lambdamikel/Busch-2090/microtronic-nextgen-sh1106-spi/README.md

# Busch-2090
## Microtronic Emulator - The Next Generation - SH1106 SPI OLED Display Version
### License: GPL 3

Current version. 

### PCB Version

SPI Pic 1
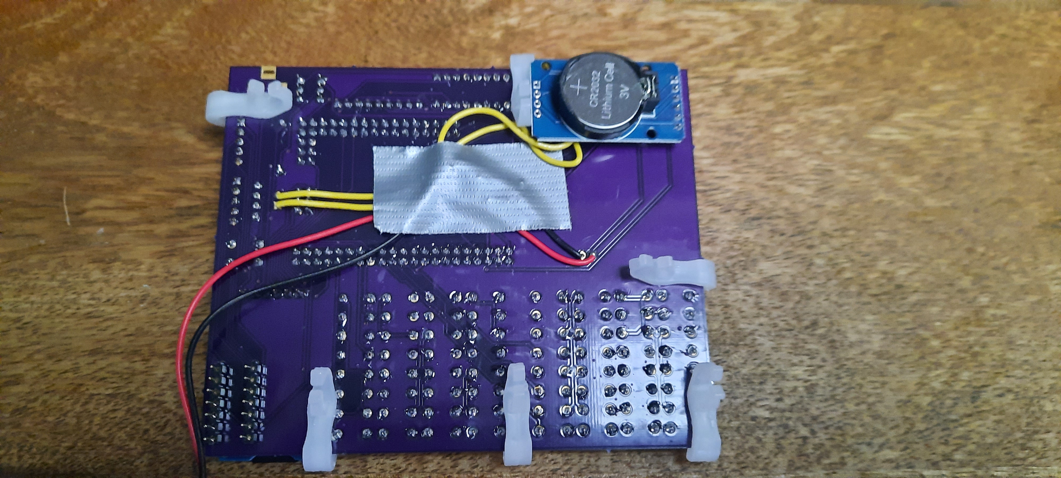
[picture p49: microtronic-nextgen-sh1106-spi/nextgen-spi-2.jpg]
SPI Pic 2

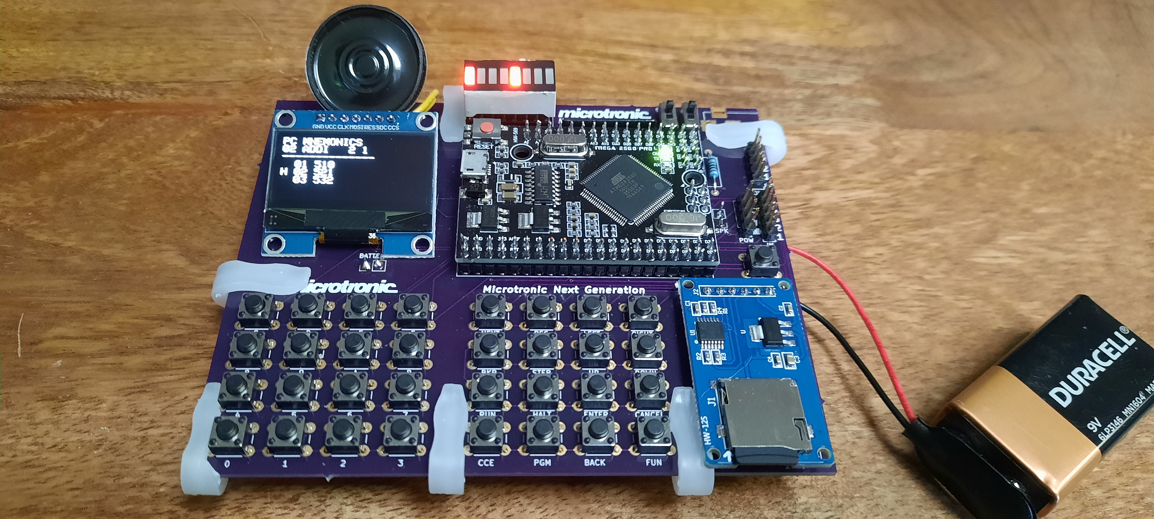
[picture p50: microtronic-nextgen-sh1106-spi/nextgen-spi-3.jpg]
SPI Pic 3

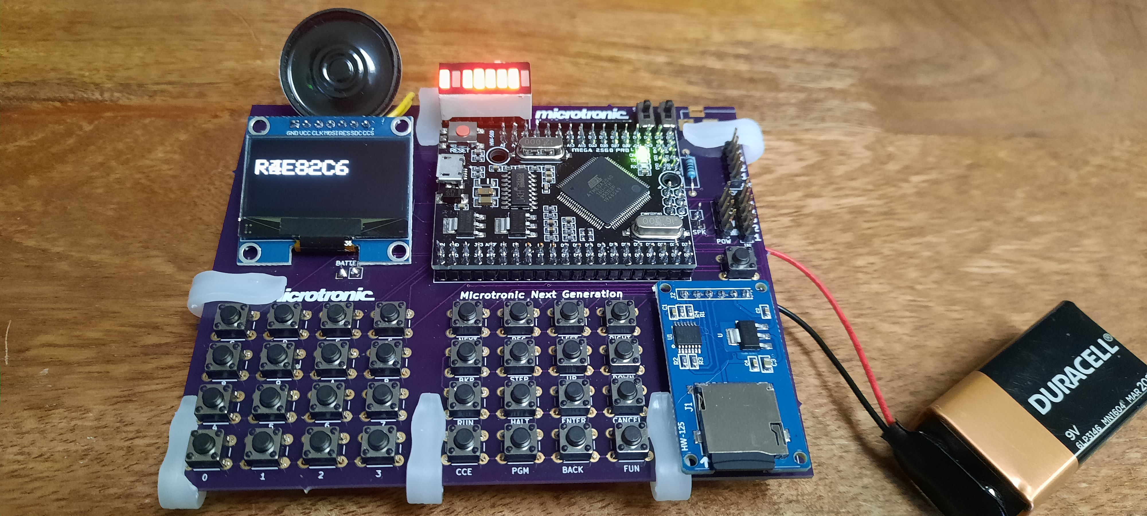
[picture p51: microtronic-nextgen-sh1106-spi/nextgen-spi-4.jpg]
SPI Pic 4

SPI Pic 5

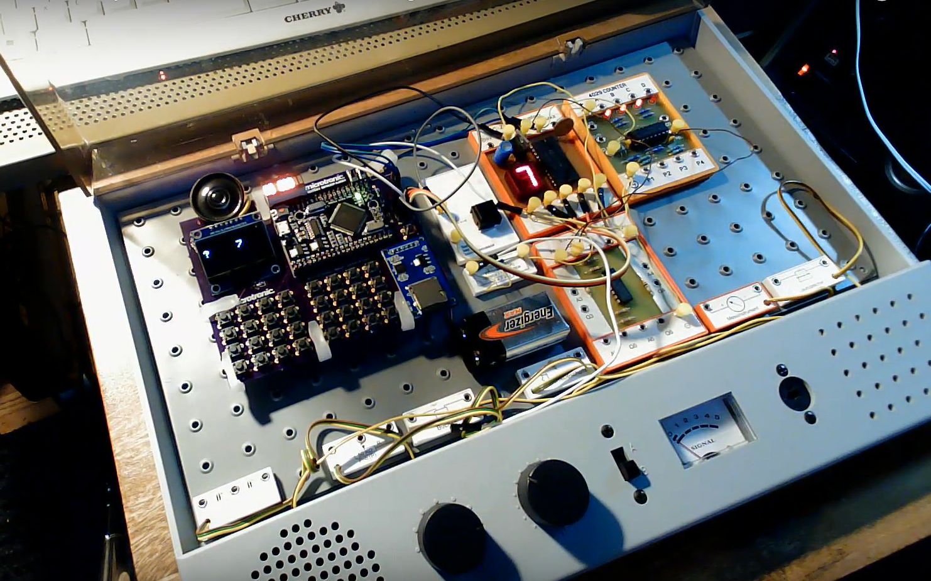
[picture p52: microtronic-nextgen-sh1106-spi/busch-2075-experiment.jpg]
SPI Pic 6


The latest version of the SPI SH1106 Next Generation also has pulldown-resistors and proper feet / PCB mounting holes: 

Busch 2090 Microtronic Next Generation - SH1106 SPI OLED Version v2 1 

Busch 2090 Microtronic Next Generation - SH1106 SPI OLED Version v2 2 

Busch 2090 Microtronic Next Generation - SH1106 SPI OLED Version v2 3 

### Breadboard Prototype

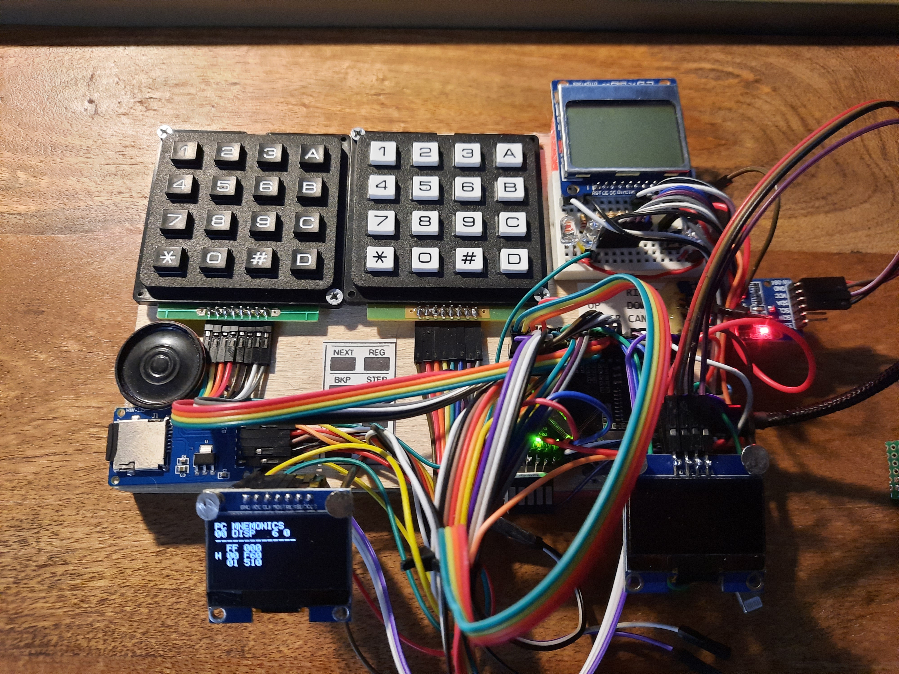
[picture p53: microtronic-nextgen-sh1106-spi/pic1.jpg]

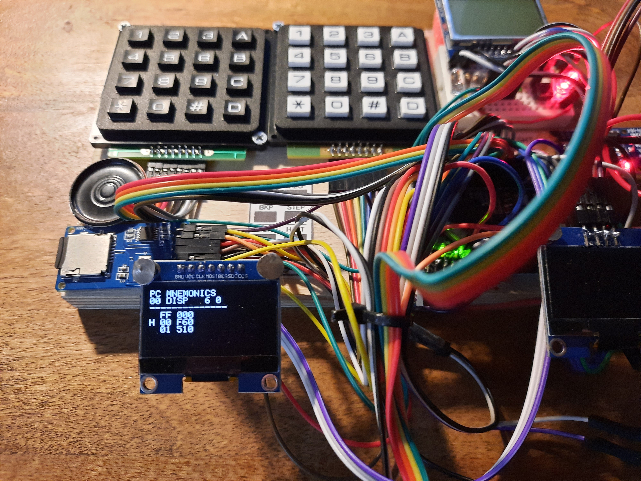
[picture p54: microtronic-nextgen-sh1106-spi/pic2.jpg]

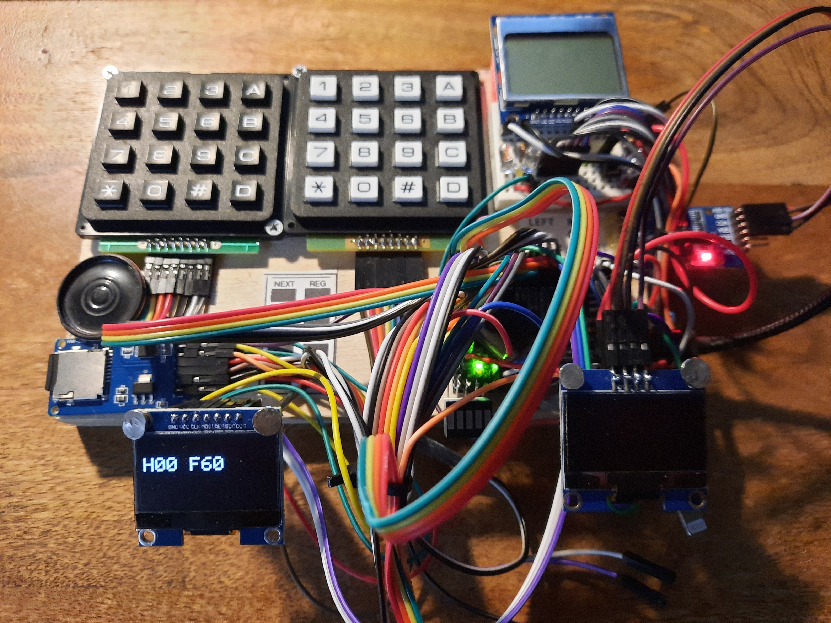
[picture p55: microtronic-nextgen-sh1106-spi/pic3.jpg]

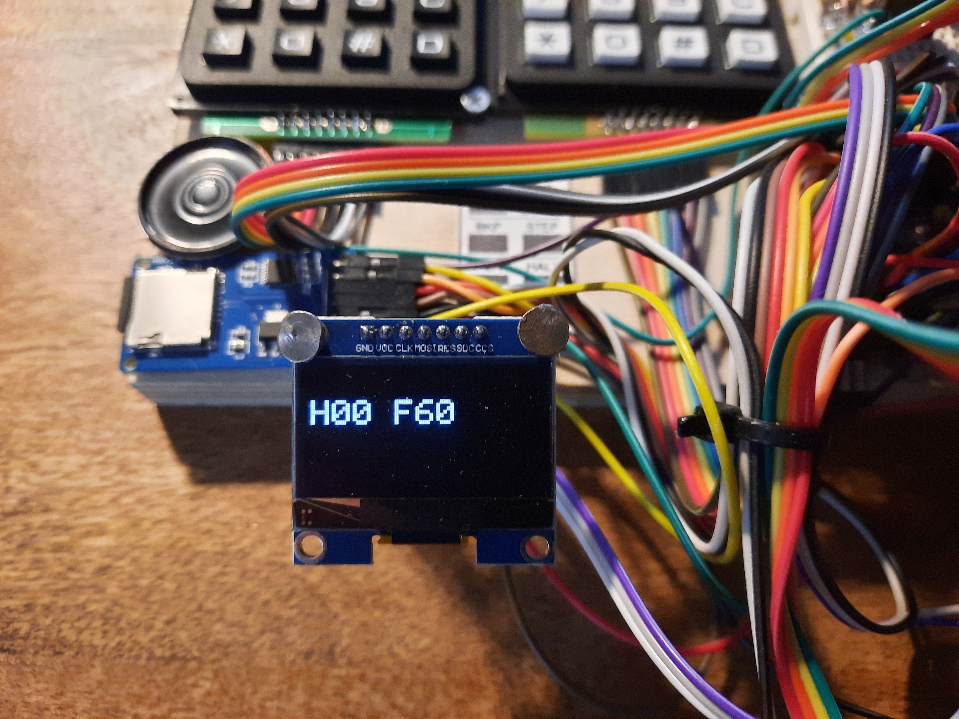
[picture p56: microtronic-nextgen-sh1106-spi/pic4.jpg]


### YouTube Videos

[YouTube Videos](https://www.youtube.com/playlist?list=PLvdXKcHrGqhekyx81EoCwQij1Lqylp0dB)
