lambdamikel/Busch-2090/microtronic-2nd-generation/README.md

# Busch-2090
## Microtronic Emulator - Microtronic 2nd Generation Version
### License: GPL 3

Microtronic 2nd Generation Version

Authors: 

- Frank de Jaeger: PCB Design & Electronics
- Manfred Henf: 3D Design & Print
- Michael Wessel: Arduino Firmware

More details about this great project can be found on the [homepage of the Microtronic 2nd Generation project.](https://www.rigert.com/ee-forum/viewtopic.php?t=2497) 

### PCB Version

*The following pictures are courtesy of Frank de Jaeger:* 

Microtronic 2nd Generation Pic 1
Microtronic 2nd Generation Pic 2
Microtronic 2nd Generation Pic 3
Microtronic 2nd Generation Pic 4
