lambdamikel/Busch-2090/microtronic-nextgen-nokia/README.md

# Busch-2090
## Microtronic Emulator - The Next Generation - Nokia 5110 Display Version
### License: GPL 3

**Deprecated.** 
Please consider [the SH1106 SPI Version instead](https://github.com/lambdamikel/Busch-2090/tree/master/microtronic-nextgen-sh1106-spi). 

### PCB Version

PCB 1
PCB 2
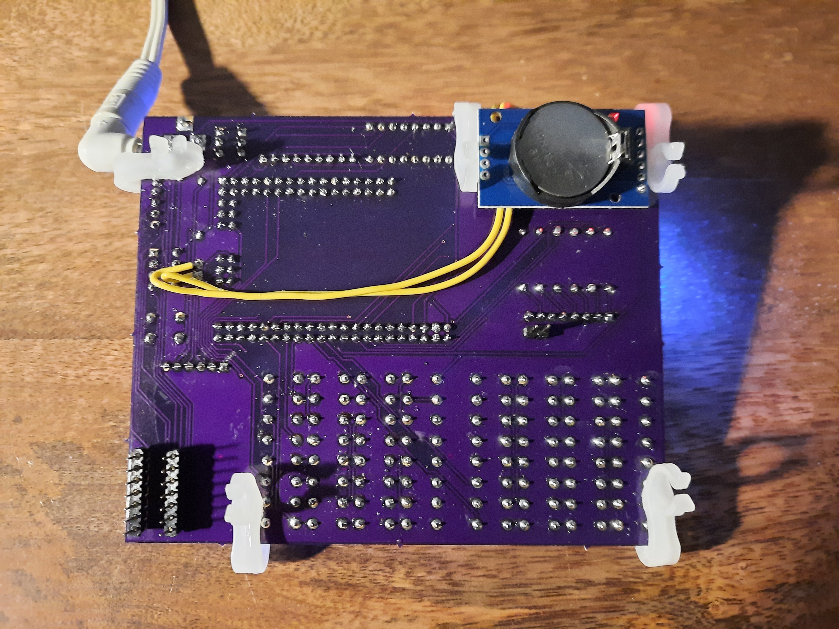
[picture p57: microtronic-nextgen-nokia/pcb3.jpg]
PCB 3


### 2095 Cassette Interface Emulation 



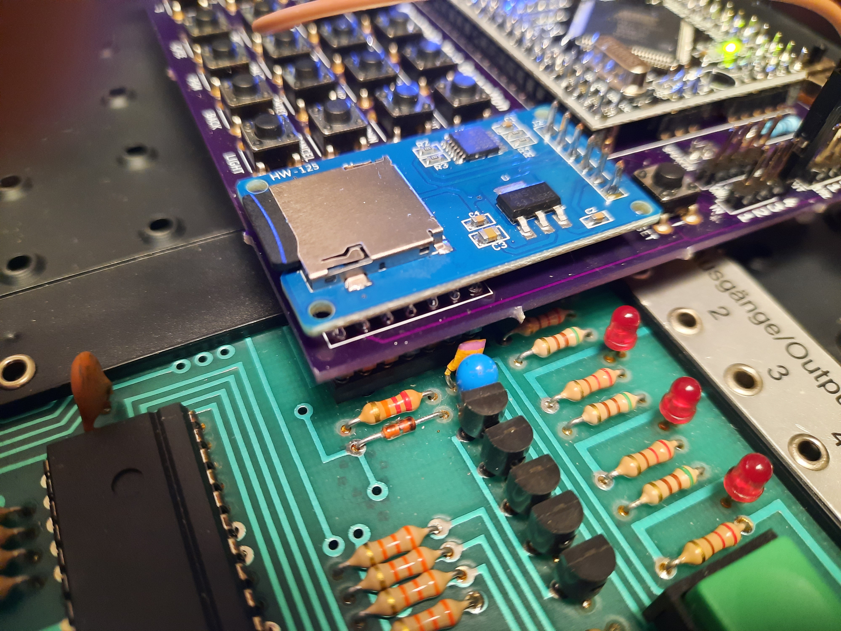
[picture p58: microtronic-nextgen-nokia/2095-3.jpg]


### Breadboard Prototype

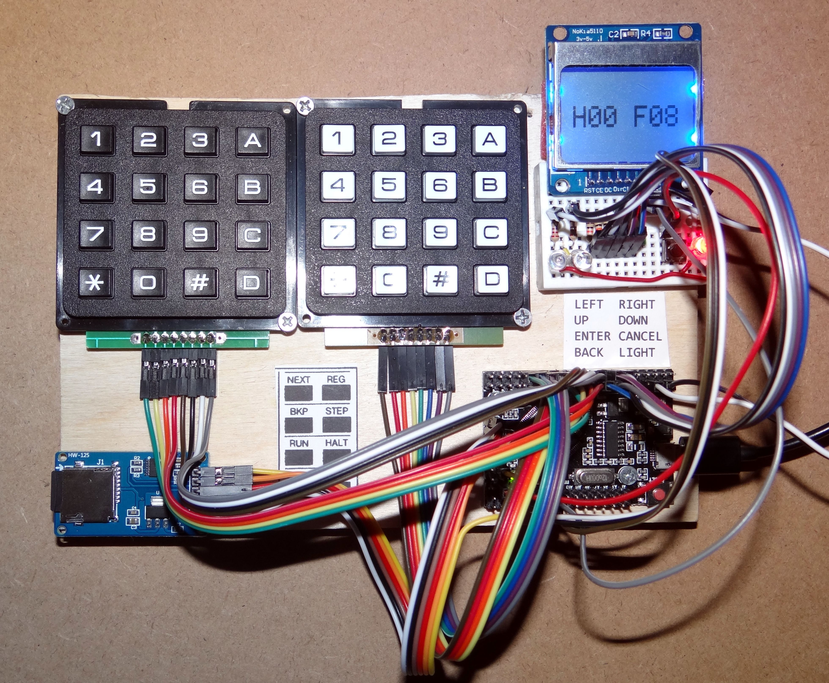
[picture p59: microtronic-nextgen-nokia/microtronic-next-gen-1.jpg]
Microtronic Emulator New Version - 1


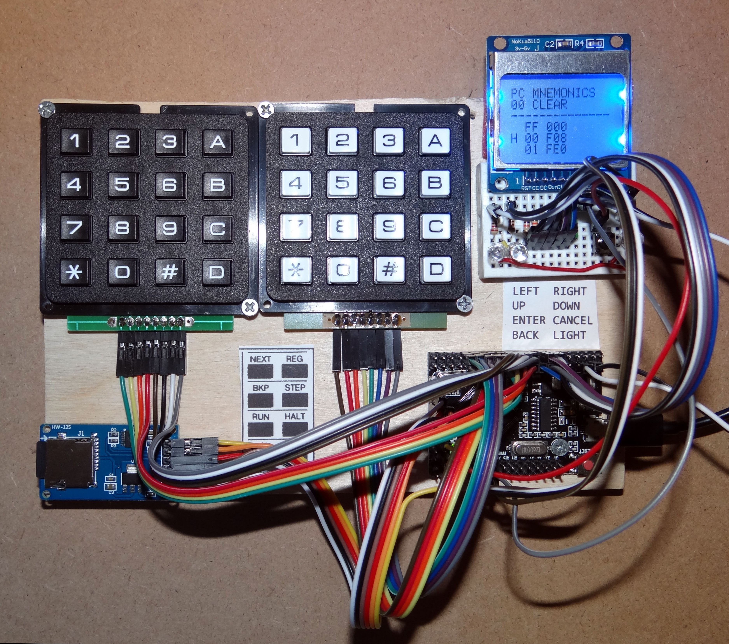
[picture p60: microtronic-nextgen-nokia/microtronic-next-gen-2.jpg]
Microtronic Emulator New Version - 2






### YouTube Videos

[YouTube Videos](https://www.youtube.com/playlist?list=PLvdXKcHrGqhekyx81EoCwQij1Lqylp0dB)
