lambdamikel/Busch-2090/microtronic-nextgen-sh1106-i2c/README.md

# Busch-2090
## Microtronic Emulator - The Next Generation - SH1106 I2C OLED Display Version
### License: GPL 3

**Deprecated.** 
Please consider [the SH1106 SPI Version instead](https://github.com/lambdamikel/Busch-2090/tree/master/microtronic-nextgen-sh1106-spi). 

### PCB Version



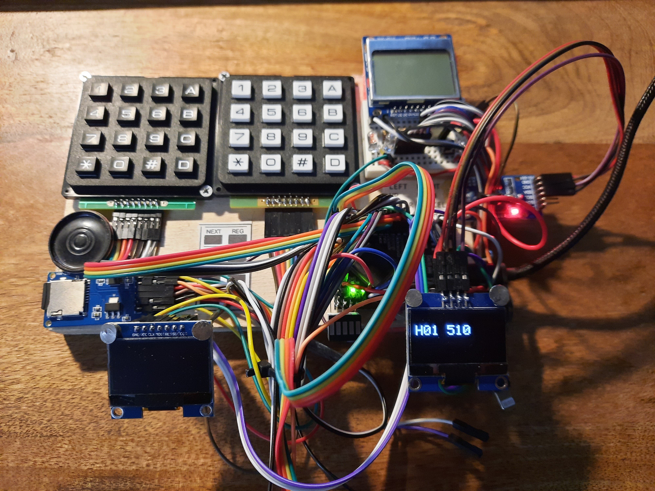
[picture p61: microtronic-nextgen-sh1106-i2c/pic3.jpg]

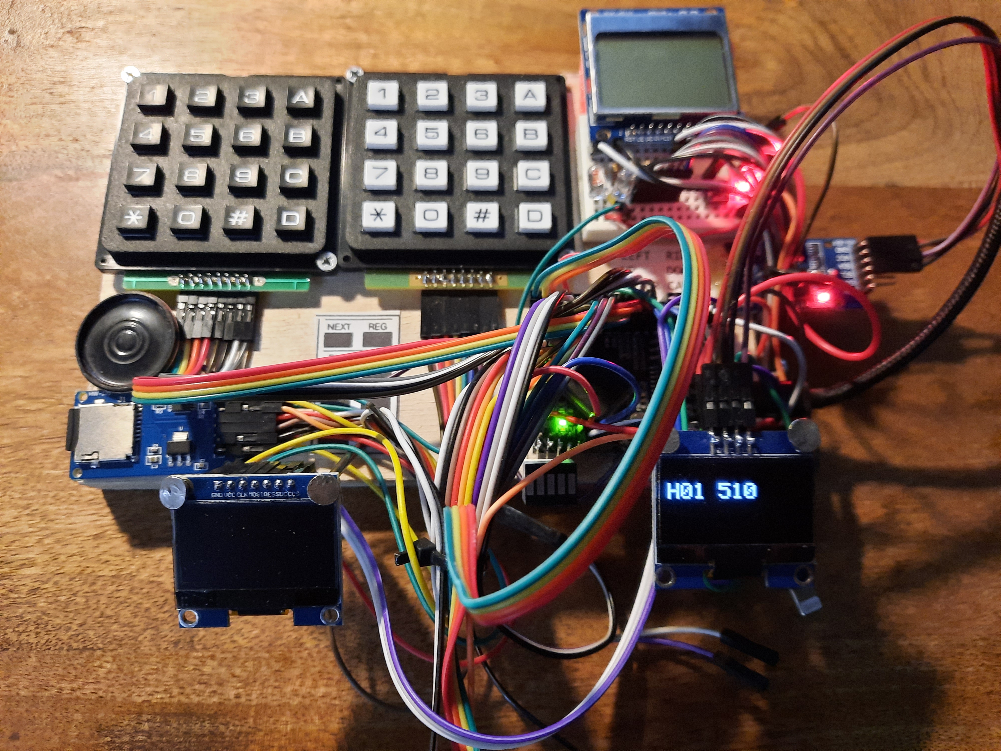
[picture p62: microtronic-nextgen-sh1106-i2c/pic4.jpg]



### YouTube Videos

[YouTube Videos](https://www.youtube.com/playlist?list=PLvdXKcHrGqhekyx81EoCwQij1Lqylp0dB)
