lambdamikel/Busch-2090/busch2090-pcb/datasheets/TM-key+led-schematics.png

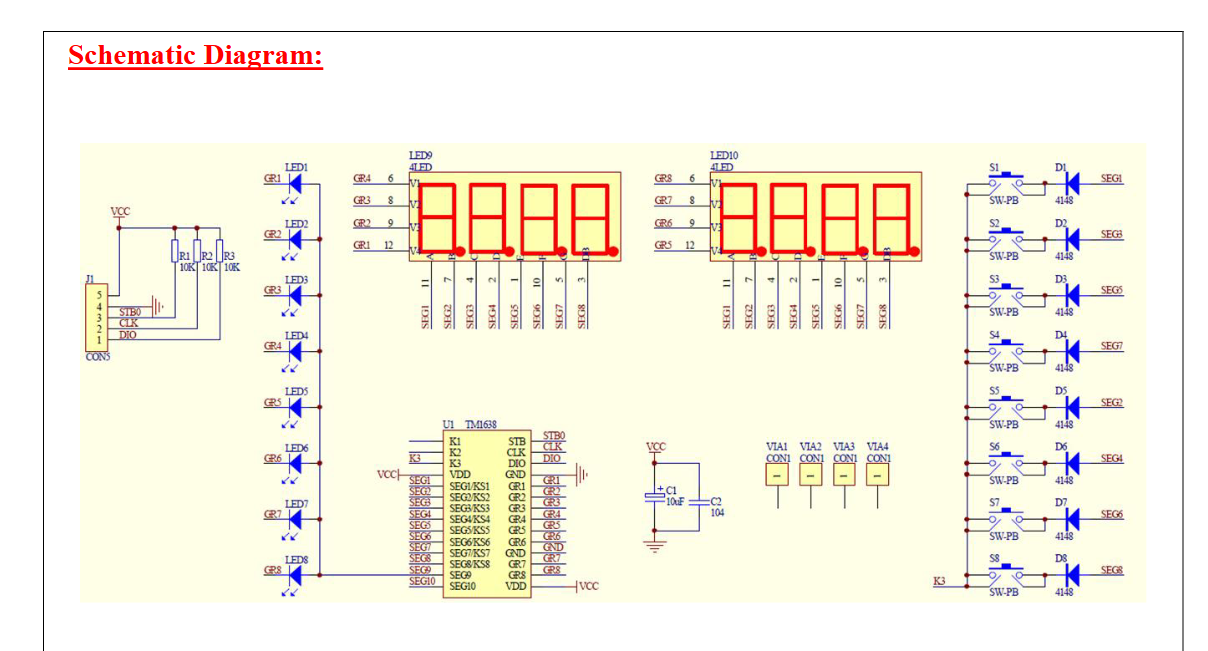
busch2090-pcb/datasheets/TM-key+led-schematics.png
