lambdamikel/Busch-2090/images/2095-flatband-cable-1.jpg

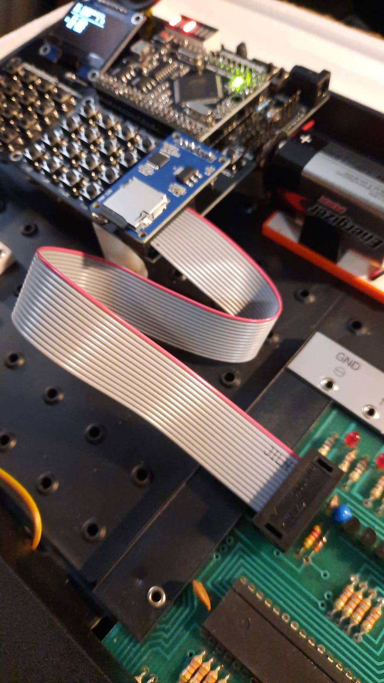
images/2095-flatband-cable-1.jpg
