lambdamikel/Busch-2090/images/emulator-busch-1-medium.jpg

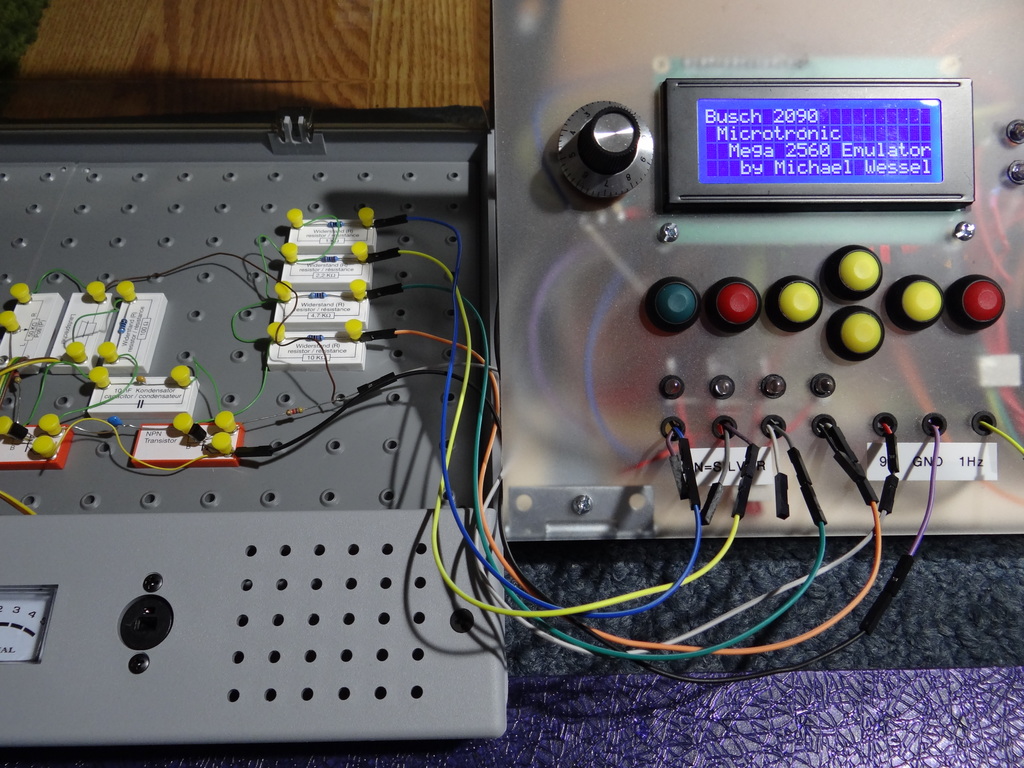
images/emulator-busch-1-medium.jpg
