lambdamikel/Busch-2090/images/emulator-busch-2-medium.jpg

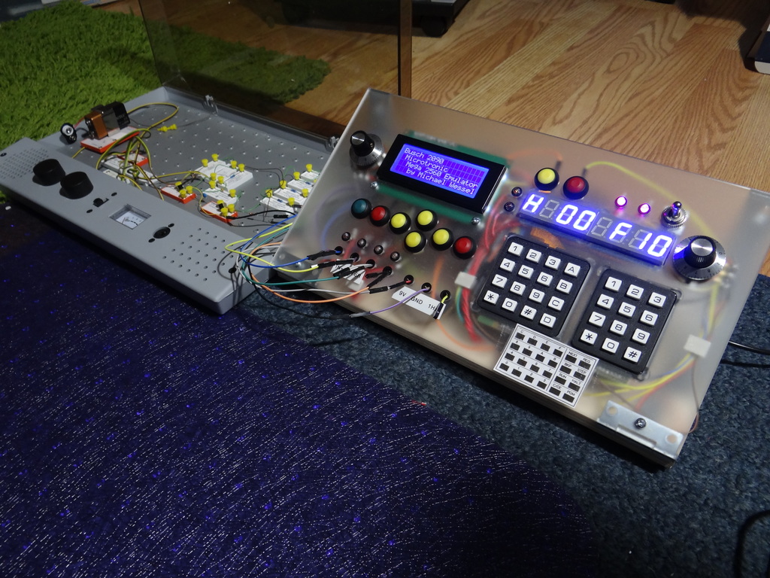
images/emulator-busch-2-medium.jpg
