lambdamikel/Busch-2090/images/emulator-busch-3-medium.jpg

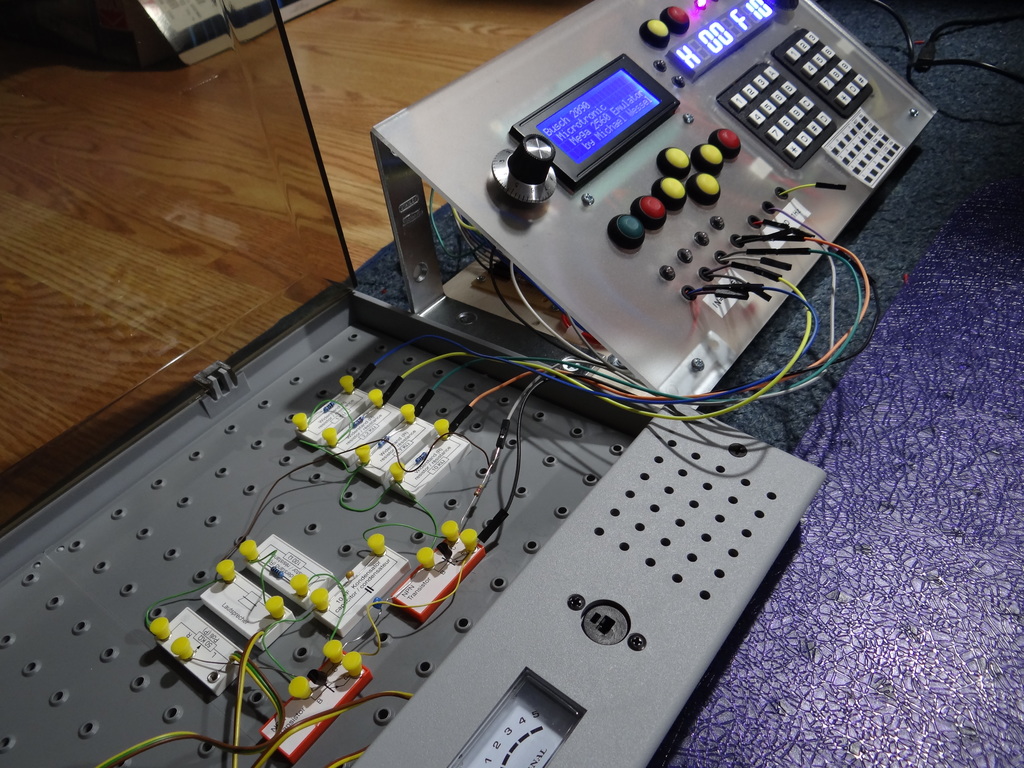
images/emulator-busch-3-medium.jpg
