lambdamikel/Busch-2090/images/emulator-busch-4-medium.jpg

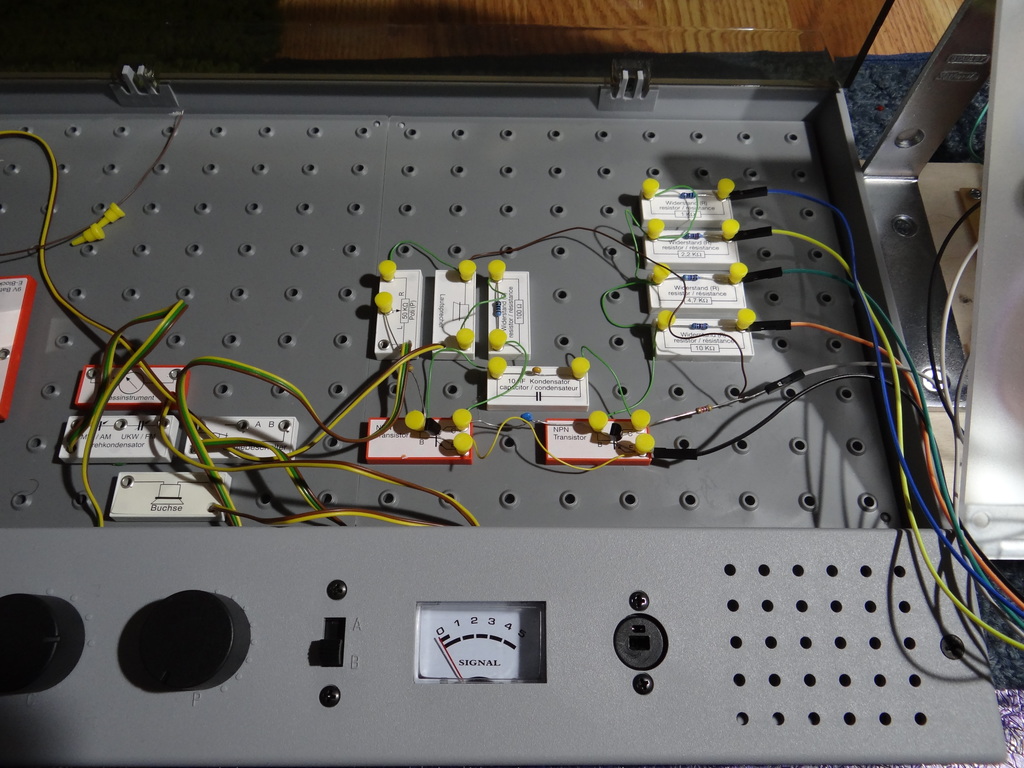
images/emulator-busch-4-medium.jpg
