lambdamikel/Busch-2090/images/emulator-busch-5-medium.jpg

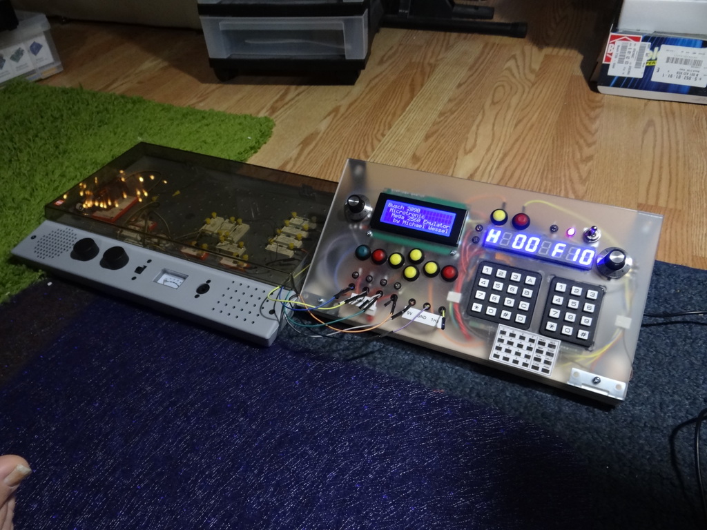
images/emulator-busch-5-medium.jpg
