lambdamikel/Busch-2090/images/emulator-busch-6-medium.jpg

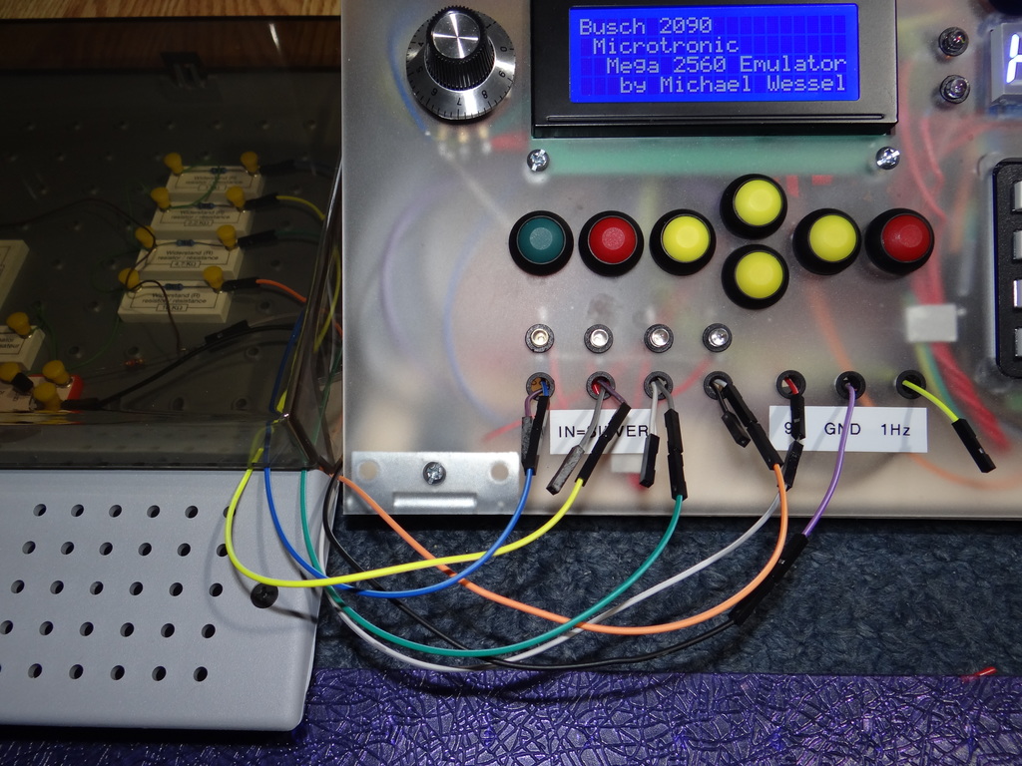
images/emulator-busch-6-medium.jpg
