lambdamikel/Busch-2090/images/emulator-busch-7-medium.jpg

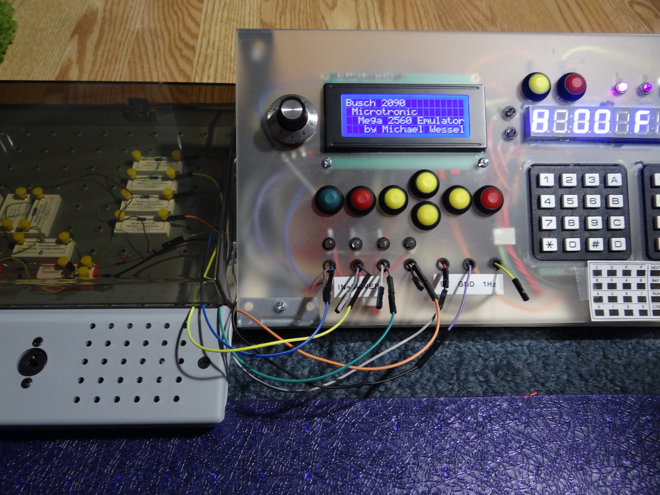
images/emulator-busch-7-medium.jpg
