lambdamikel/Busch-2090/images/img1-medium.jpg

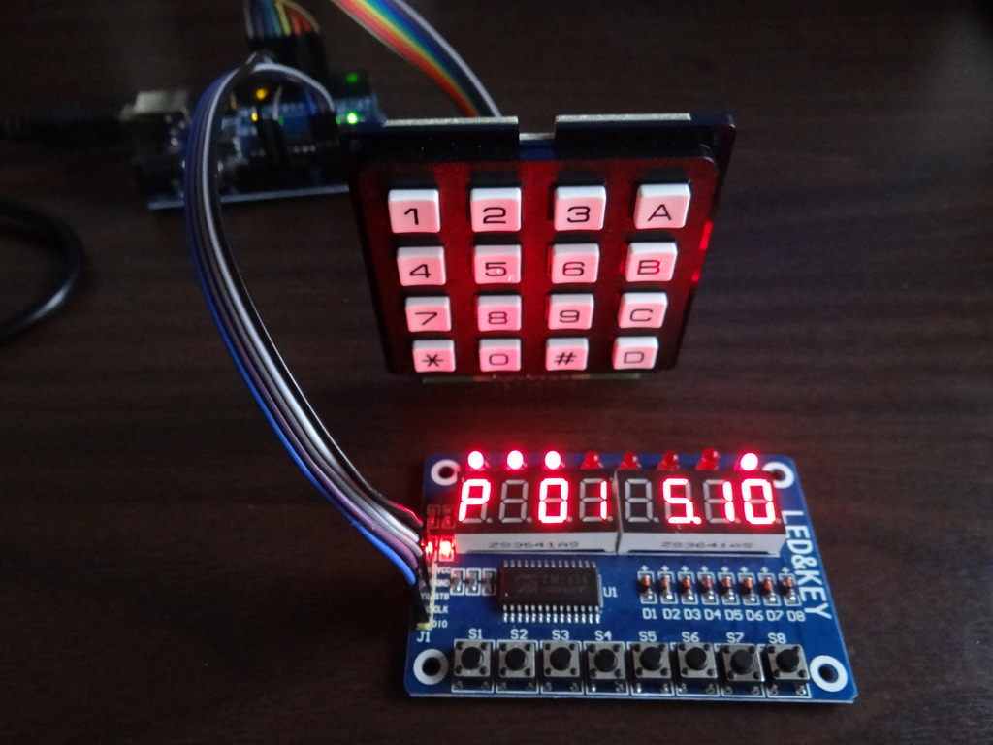
images/img1-medium.jpg
