lambdamikel/Busch-2090/images/img2-medium.jpg

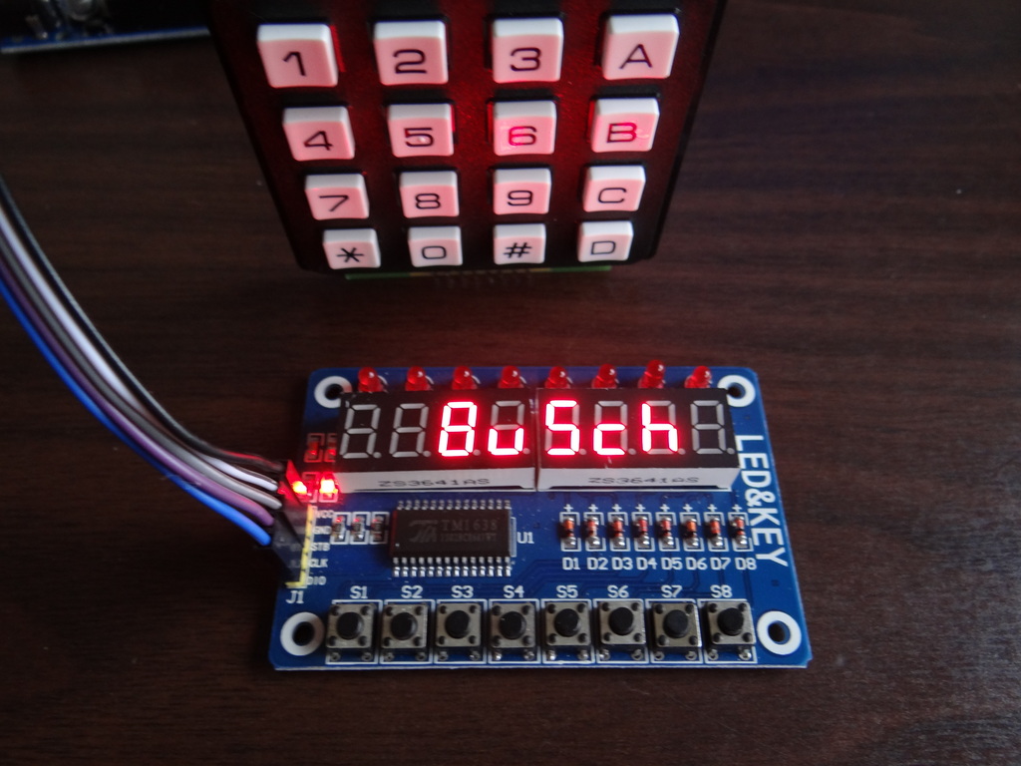
images/img2-medium.jpg
