lambdamikel/Busch-2090/images/img3-medium.jpg

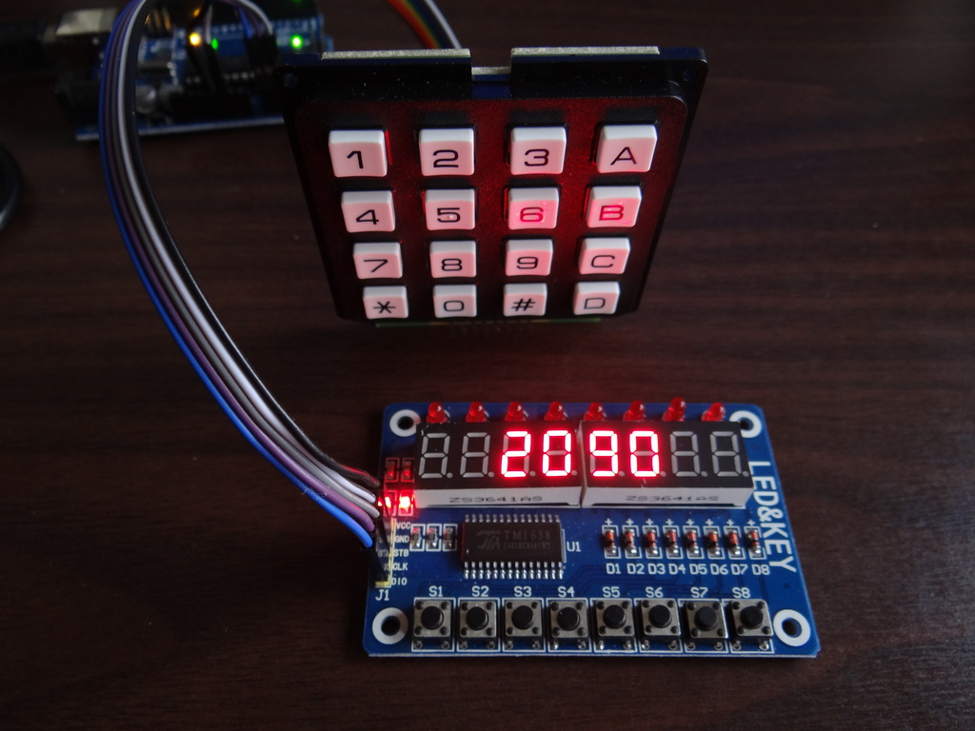
images/img3-medium.jpg
