lambdamikel/Busch-2090/images/img5-medium.jpg

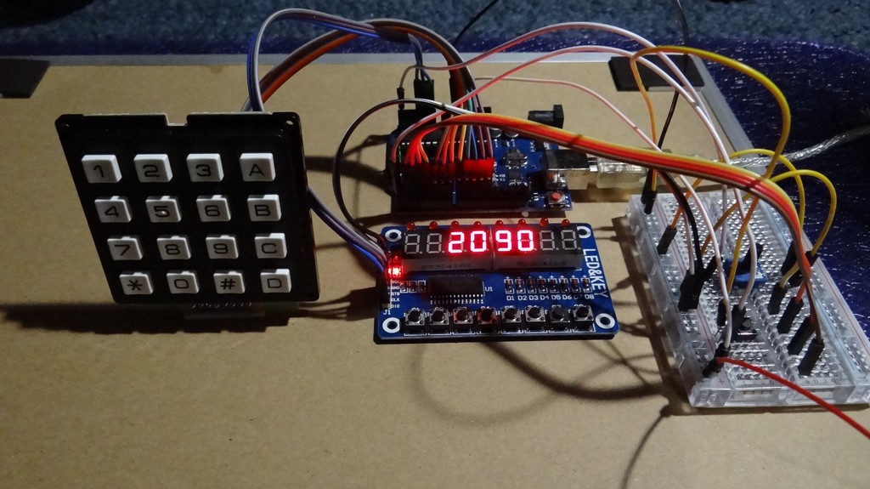
images/img5-medium.jpg
