lambdamikel/Busch-2090/images/img6-medium.jpg

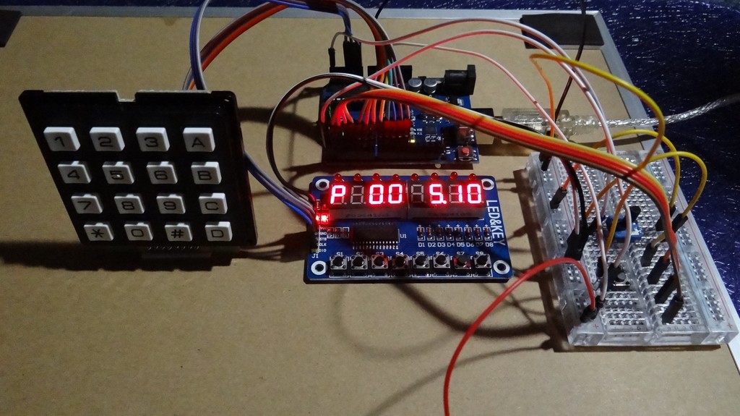
images/img6-medium.jpg
