lambdamikel/Busch-2090/images/img-mega1-medium.jpg

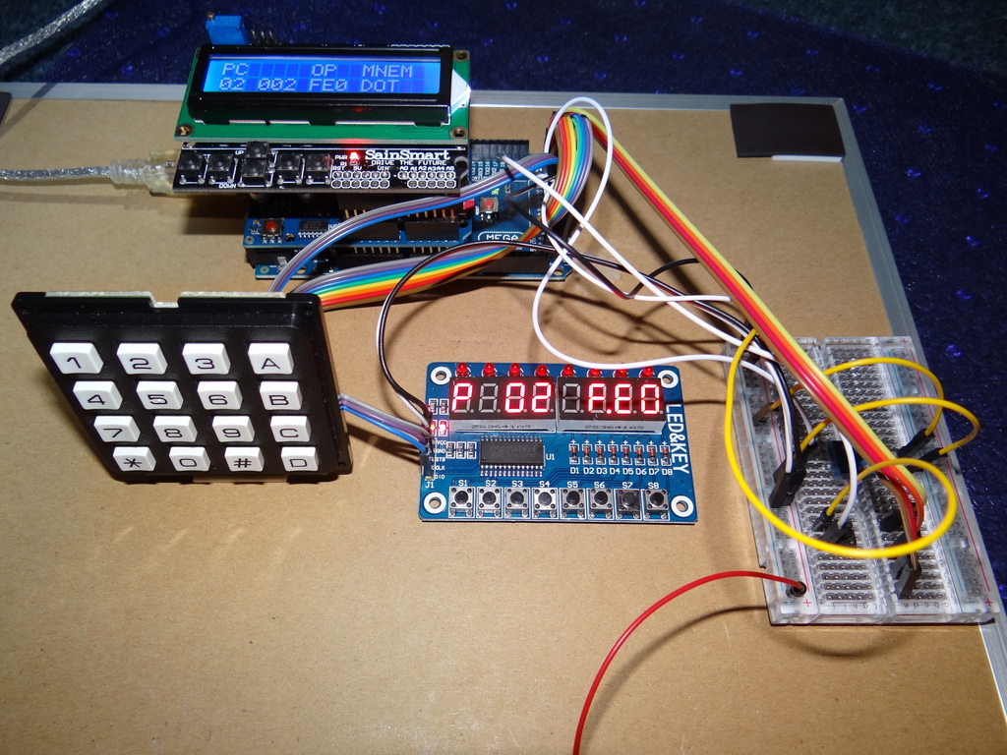
images/img-mega1-medium.jpg
