lambdamikel/Busch-2090/images/img-mega2-medium.jpg

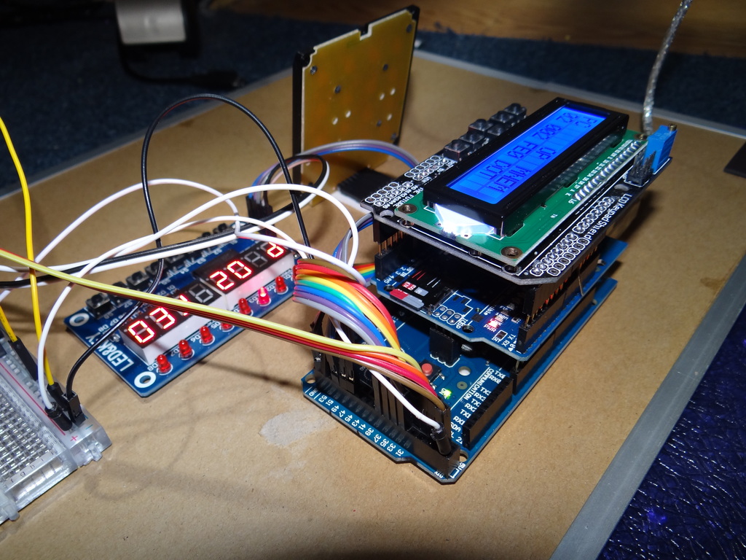
images/img-mega2-medium.jpg
