lambdamikel/Busch-2090/images/img-mega3-medium.jpg

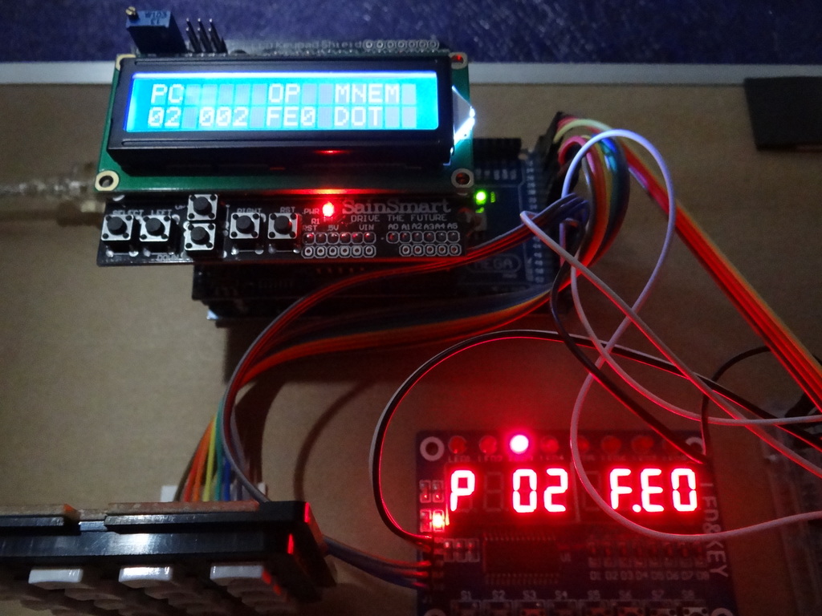
images/img-mega3-medium.jpg
