lambdamikel/Busch-2090/images/img-mega4-medium.jpg

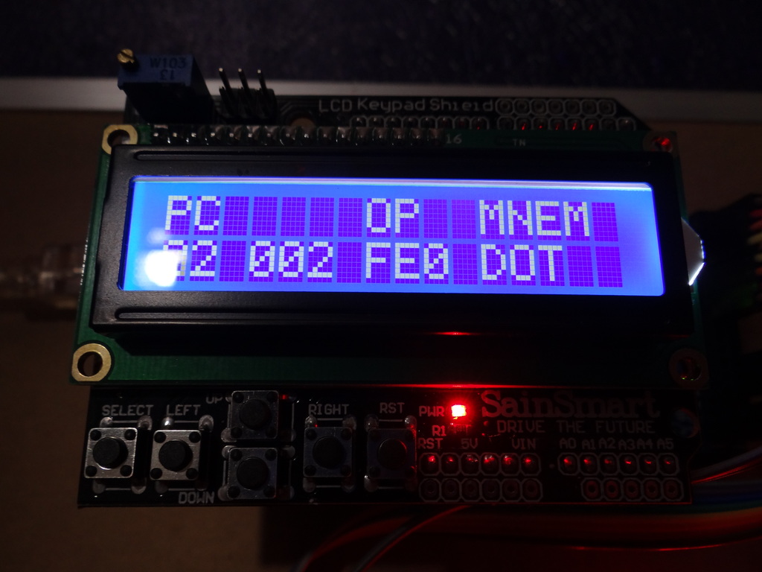
images/img-mega4-medium.jpg
