lambdamikel/Busch-2090/images/img-mega-v1-3-medium.jpg

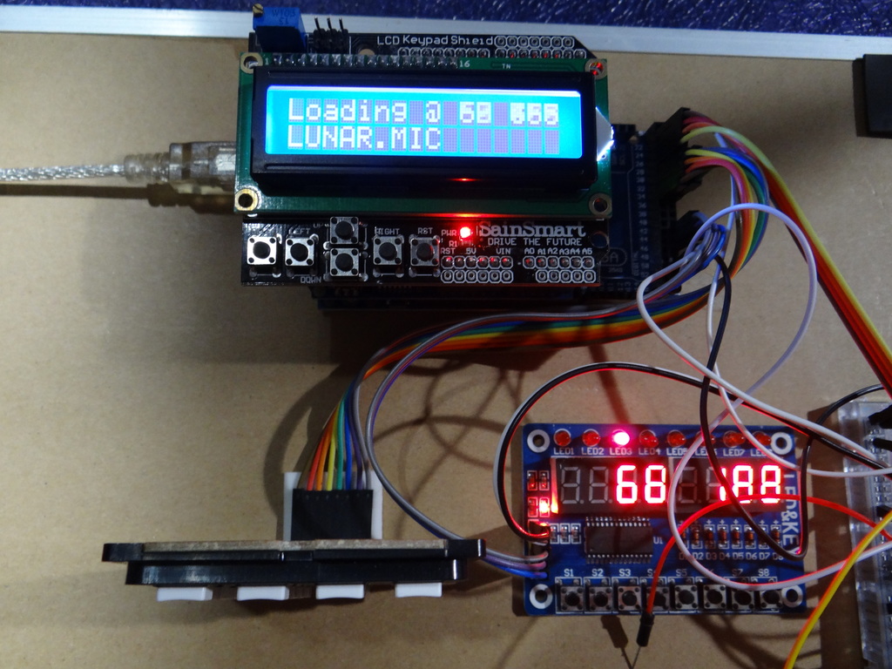
images/img-mega-v1-3-medium.jpg
