lambdamikel/Busch-2090/images/img-mega-v2-1-medium.jpg

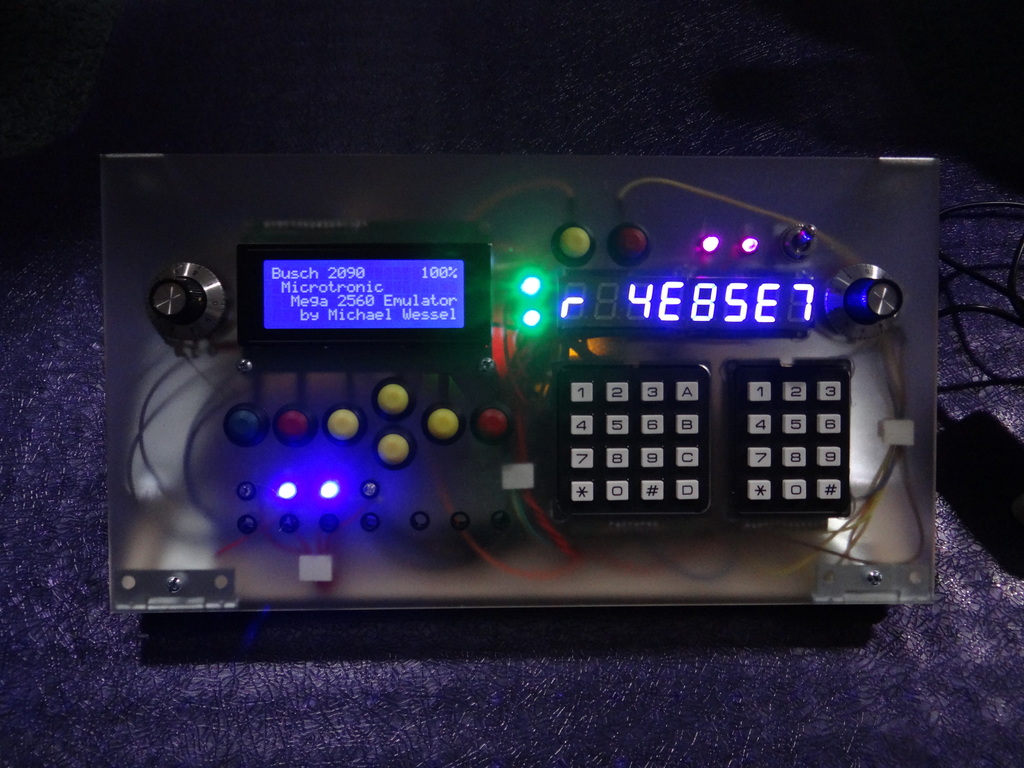
images/img-mega-v2-1-medium.jpg
