lambdamikel/Busch-2090/images/img-mega-v2-3-medium.jpg

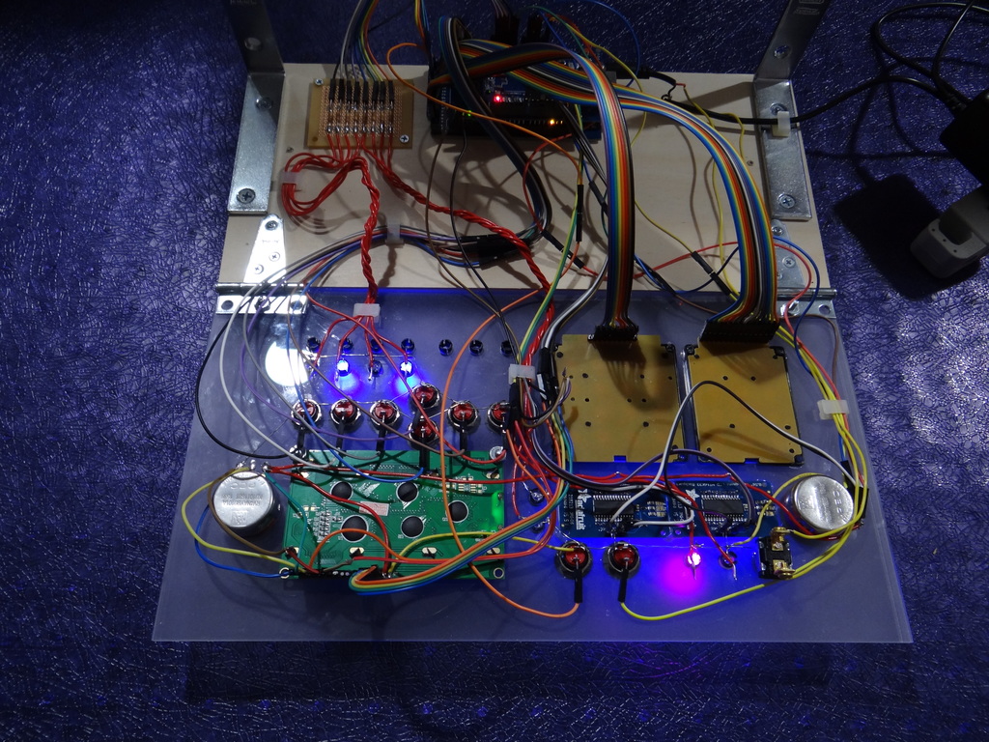
images/img-mega-v2-3-medium.jpg
