lambdamikel/Busch-2090/images/img-mega-v2-4-medium.jpg

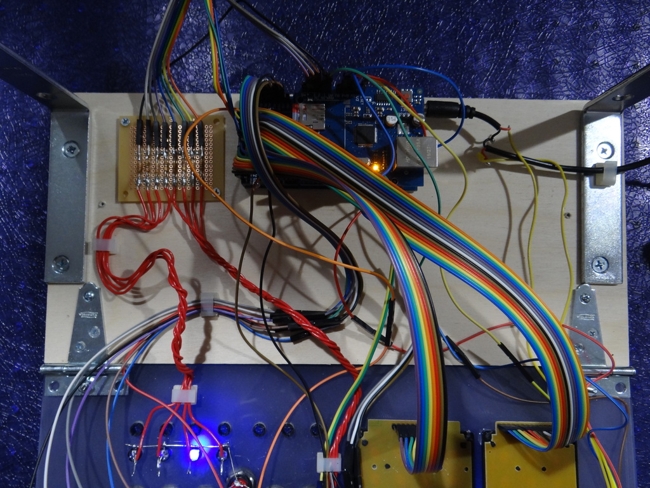
images/img-mega-v2-4-medium.jpg
