lambdamikel/Busch-2090/images/IMG_1842.JPG

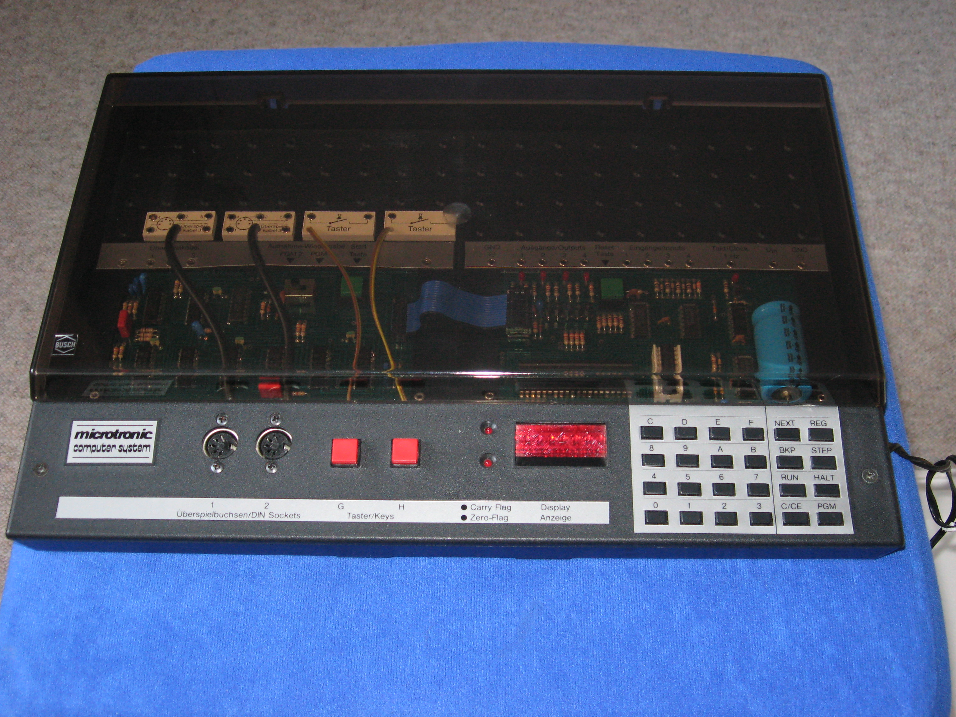
images/IMG_1842.JPG
