lambdamikel/Busch-2090/images/IMG_1843.JPG

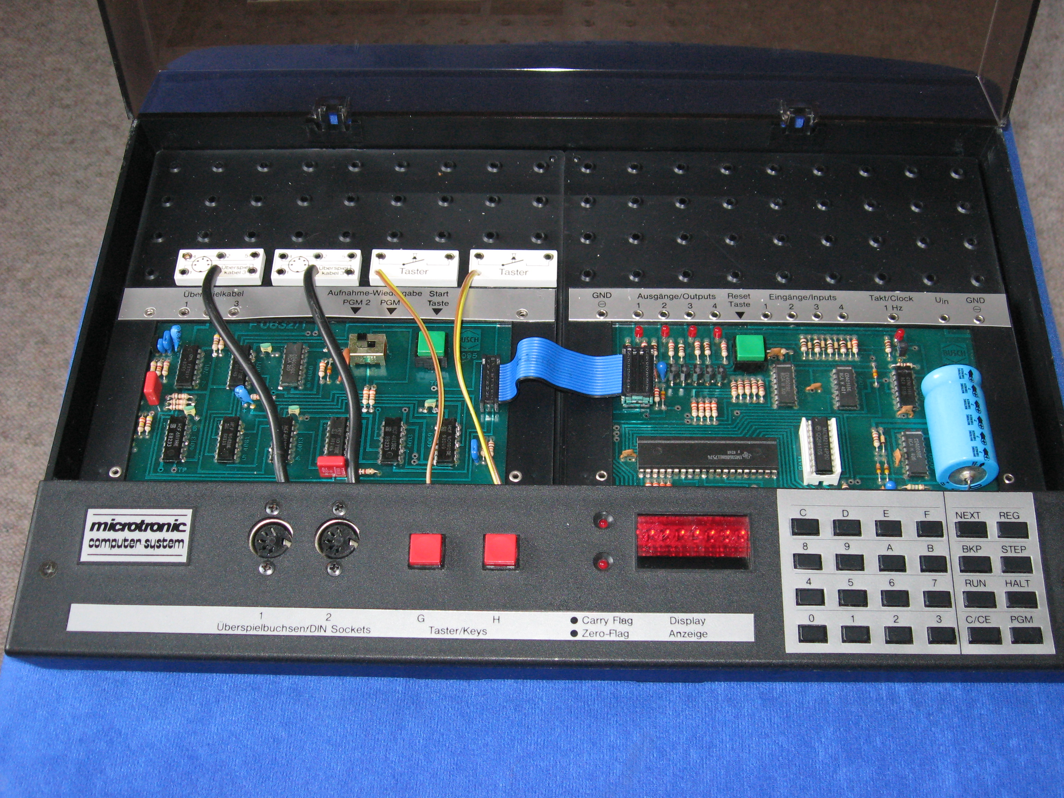
images/IMG_1843.JPG
