lambdamikel/Busch-2090/images/schematics-nextgen-v2.jpg

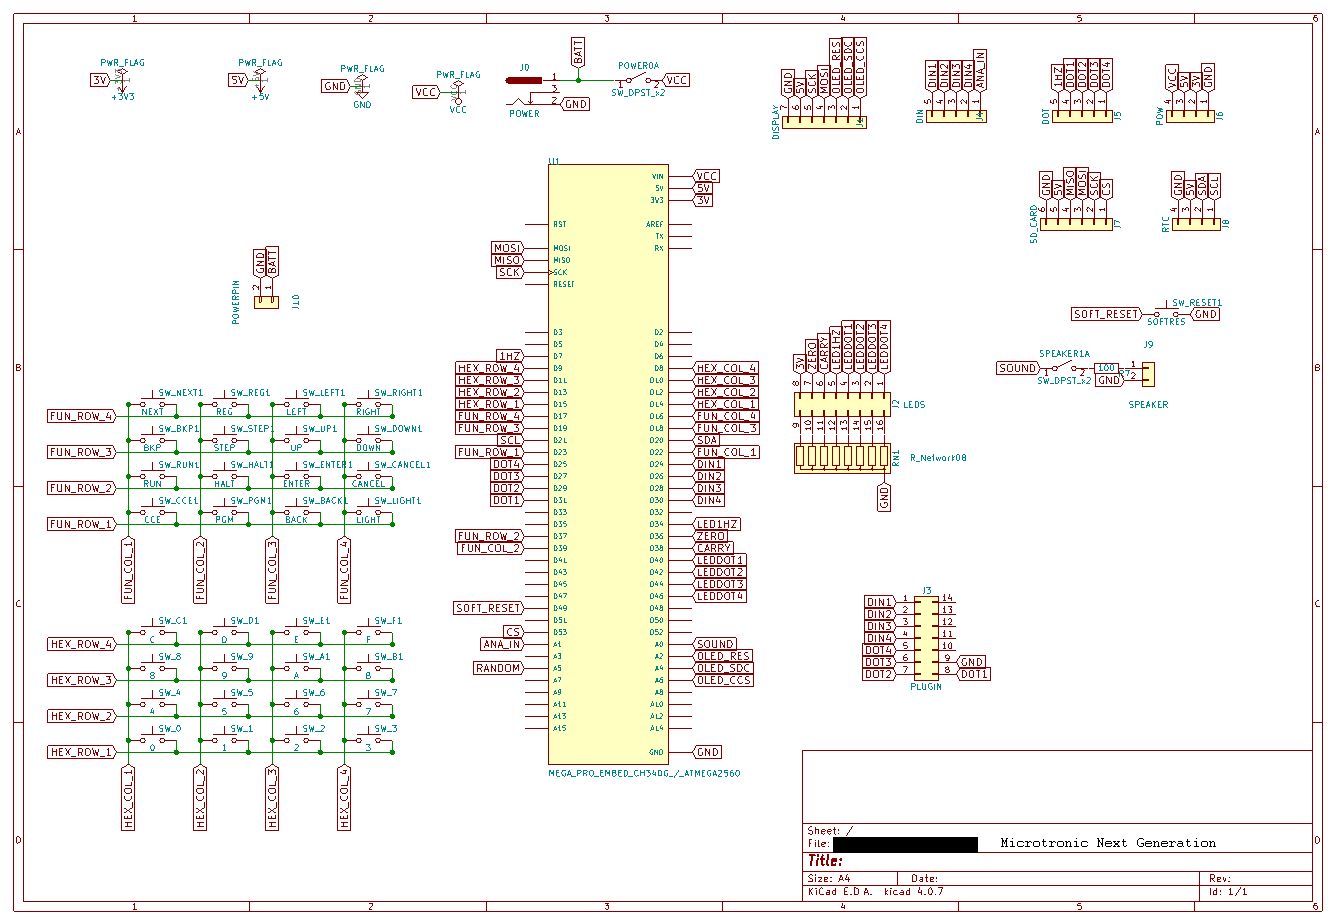
images/schematics-nextgen-v2.jpg
