lambdamikel/Busch-2090/images/smd-pcb-b-l.jpg

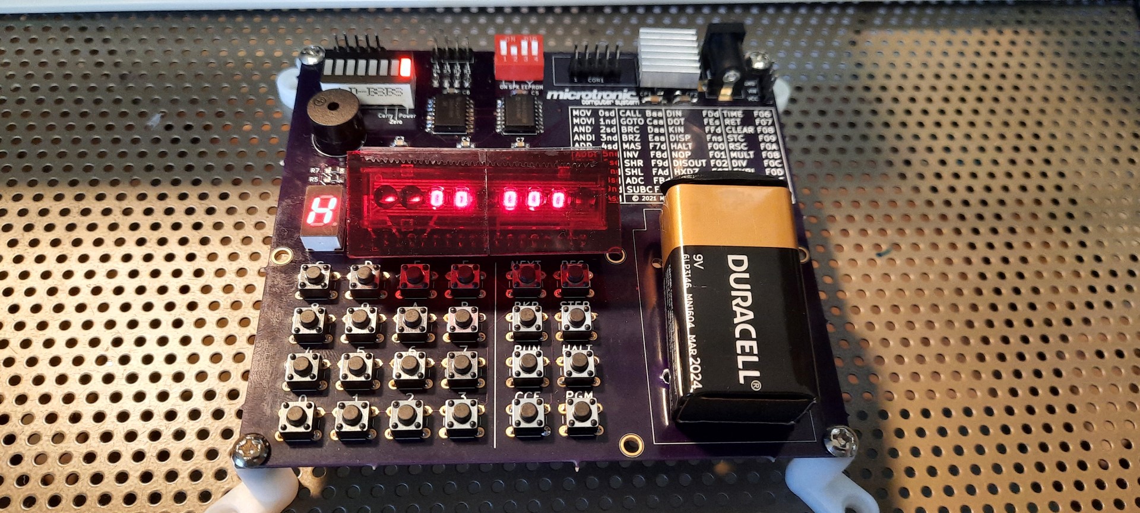
images/smd-pcb-b-l.jpg
