lambdamikel/Busch-2090/images/smd-version-pcb-1.png

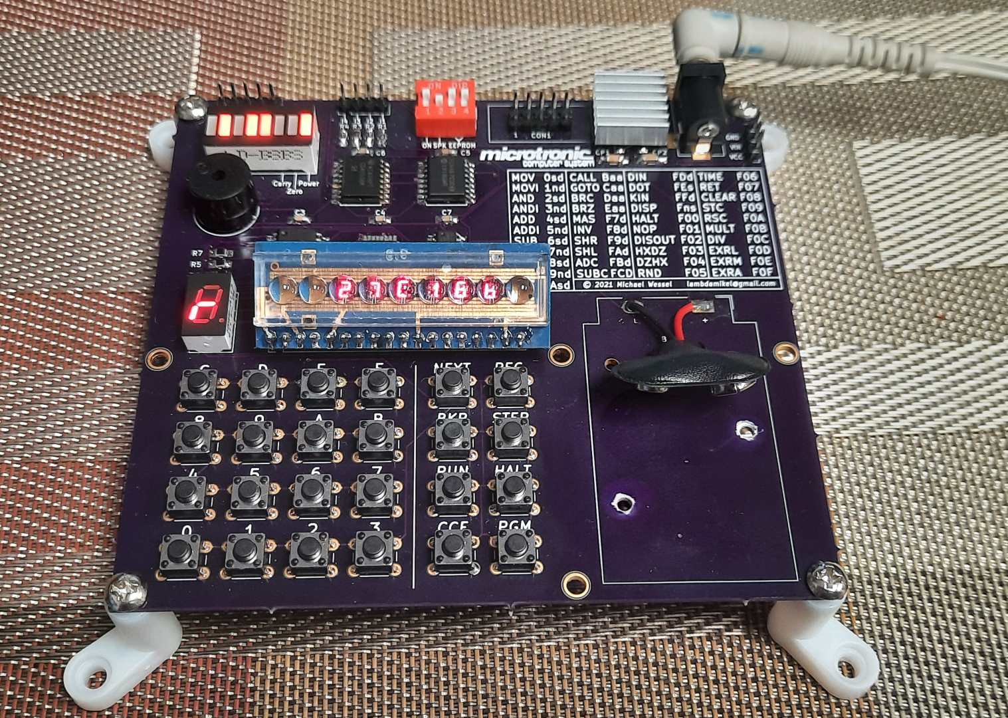
images/smd-version-pcb-1.png
