lambdamikel/Busch-2090/images/smd-version-pcb-2.jpg

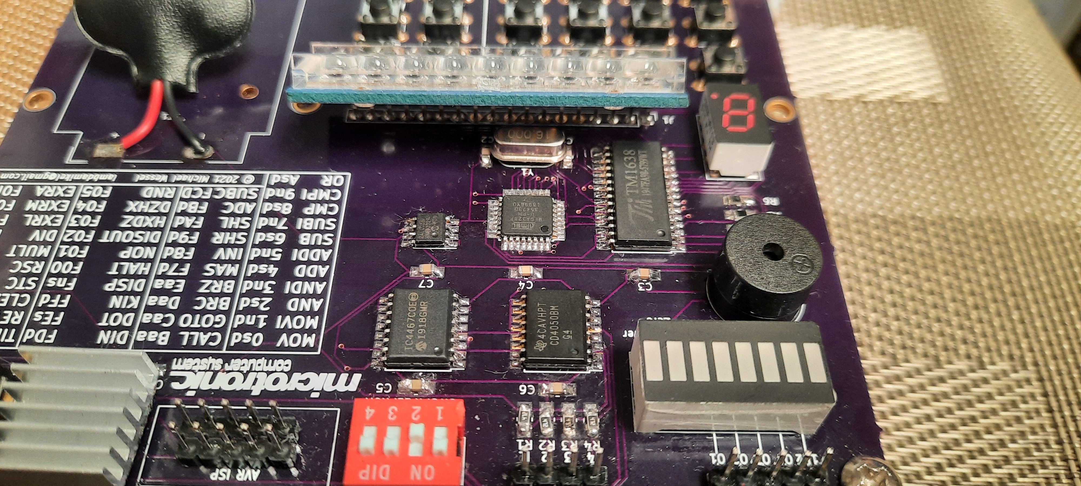
images/smd-version-pcb-2.jpg
