lambdamikel/Busch-2090/manuals/TIL393-9_pinout.jpg

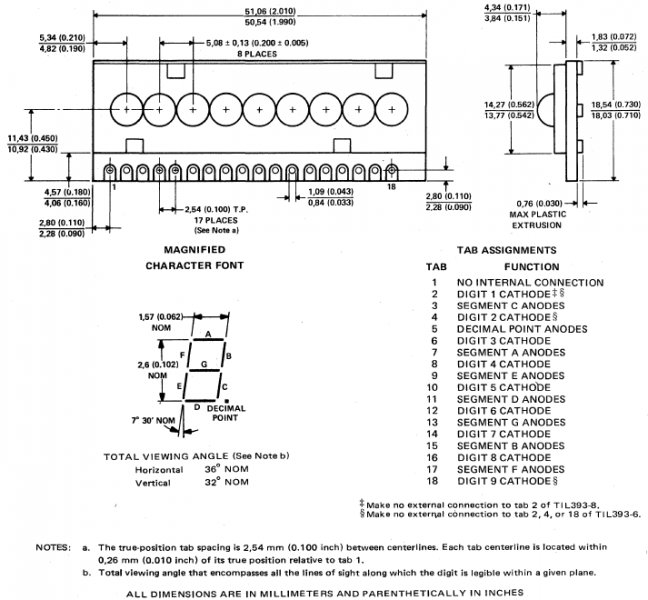
manuals/TIL393-9_pinout.jpg
