lambdamikel/Busch-2090/microtronic-nextgen-sh1106-i2c/atmega-pinout.jpg

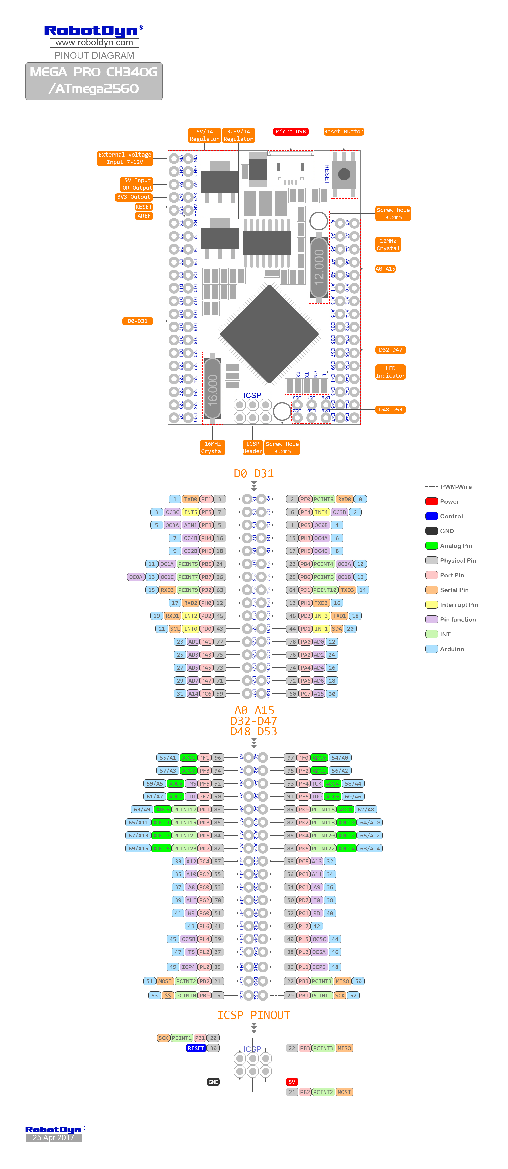
microtronic-nextgen-sh1106-i2c/atmega-pinout.jpg
