lambdamikel/Busch-2090/microtronic-nextgen-sh1106-i2c/busch-keypad.jpeg

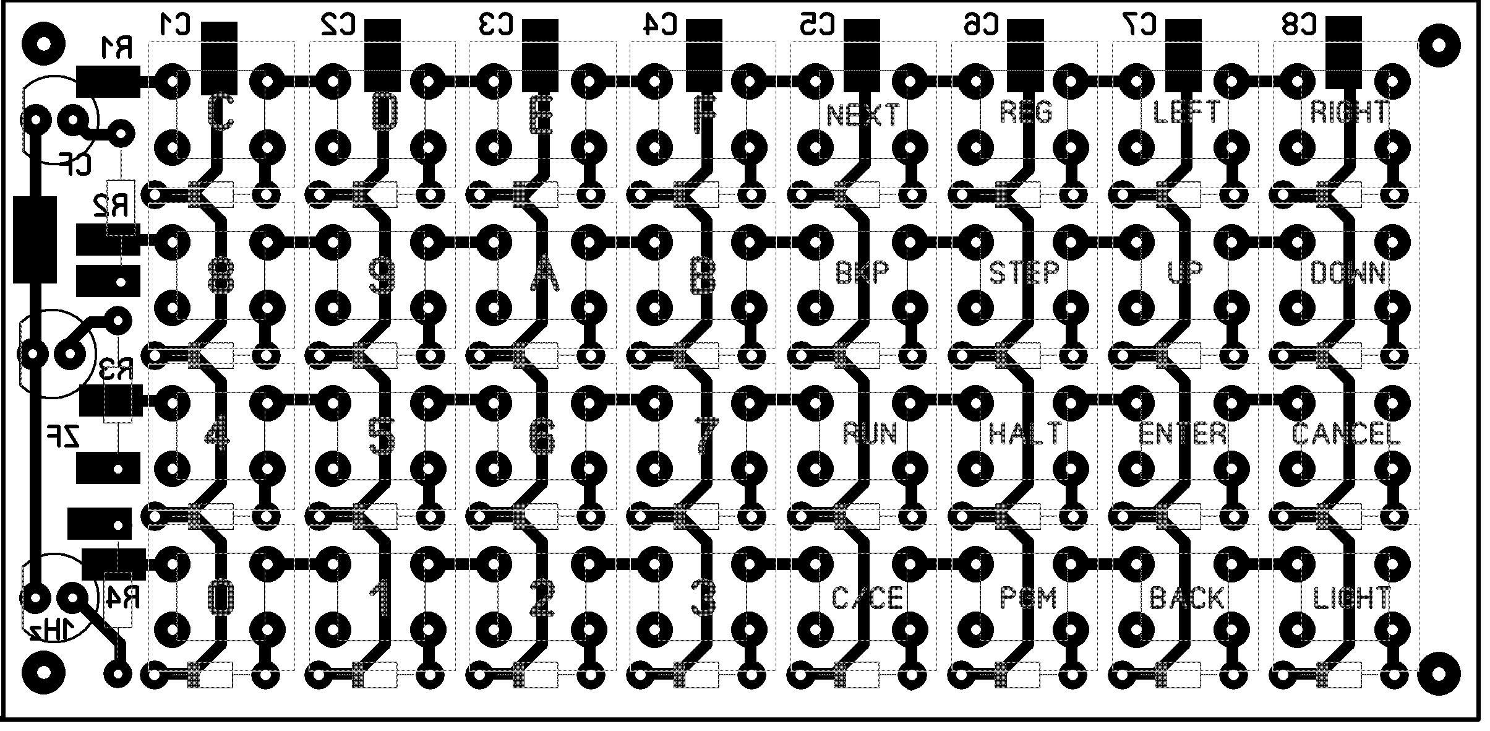
microtronic-nextgen-sh1106-i2c/busch-keypad.jpeg
