lambdamikel/Busch-2090/microtronic-nextgen-sh1106-i2c/microtronic-keyboard.png

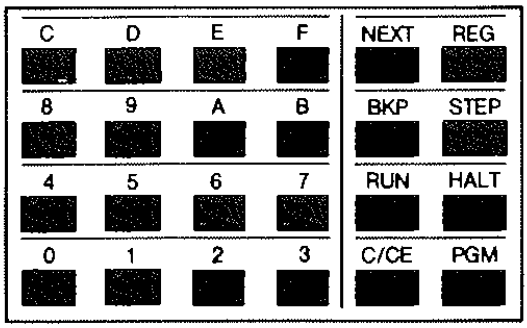
microtronic-nextgen-sh1106-i2c/microtronic-keyboard.png
