lambdamikel/Busch-2090/microtronic-nextgen-sh1106-i2c/microtronic.jpg

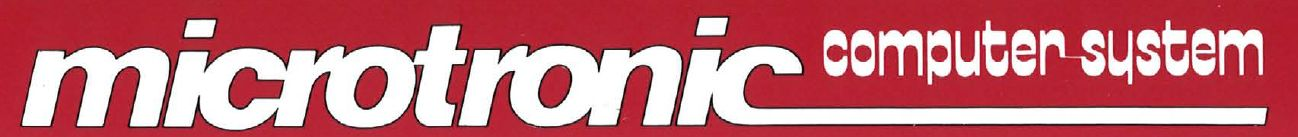
microtronic-nextgen-sh1106-i2c/microtronic.jpg
