lambdamikel/Busch-2090/software/busch-calculator-overlay.jpg

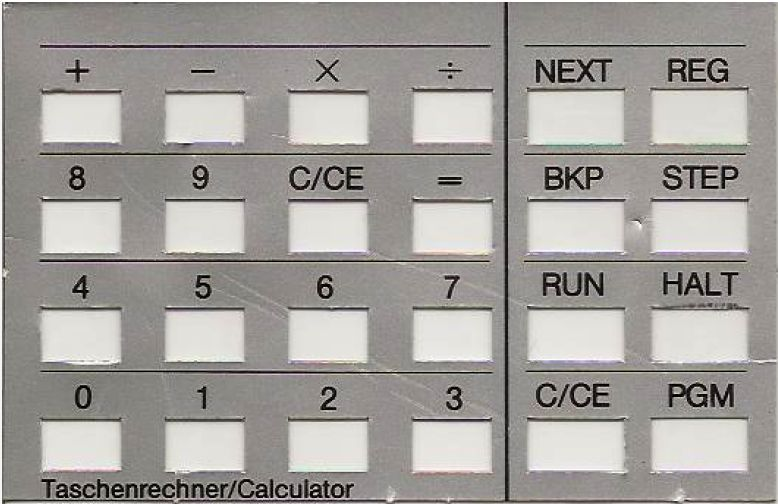
software/busch-calculator-overlay.jpg
