lambdamikel/Busch-2090/software/busch-morse-encoder-overlay.jpg

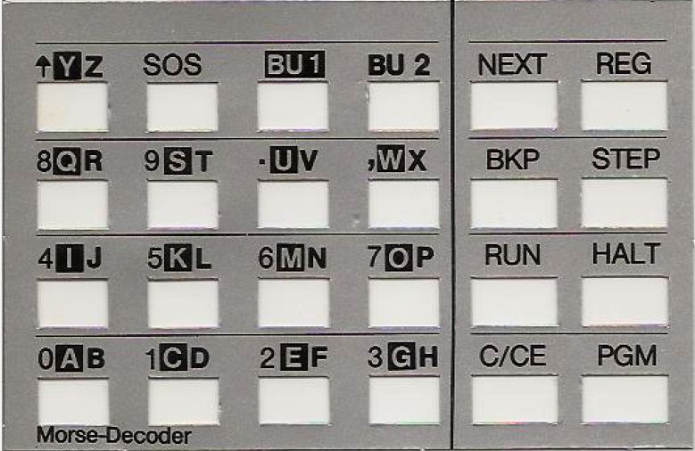
software/busch-morse-encoder-overlay.jpg
