lambdamikel/Busch-2090/software/busch-resistor-decoder-overlay.jpg

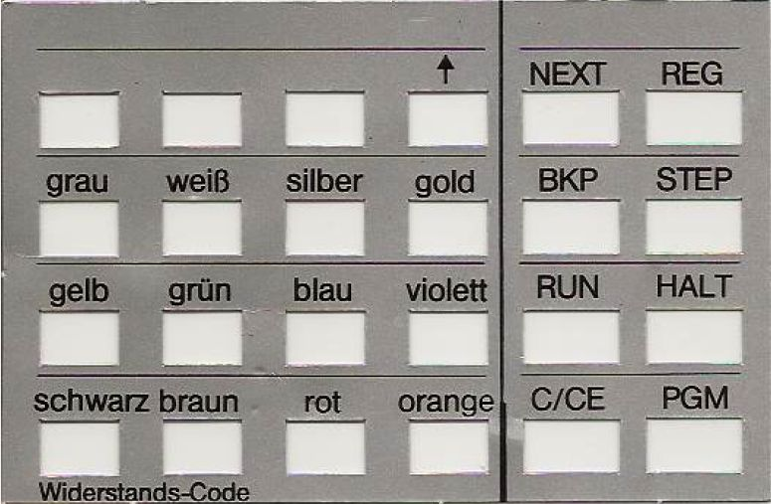
software/busch-resistor-decoder-overlay.jpg
