lambdamikel/Busch-2090/manuals/microtronic-intro-doc.rtf

Dear Customer,
Thank you so much for the purchase of
"Microtronic - The Next Generation"!
Please note: do not use an external power supply while the battery is connected, even if the device is off! Please only either use the battery, or an external power, but not both, even if the device is off!
The external PSU should have 7 to 12 V, and positive center polarity (i.e., a standard Arduino Uno PSU will do).
Some first steps:
17+4 Game: when the machine turns on, it will have 17+4 blackjack game loaded. Display shows "H00 F08" (Halted, Op-Code at address 00: F08 = CLEAR REGISTERS). Just run it: HALT-NEXT-0-0-RUN. Display shows "?17ADD4". "?" Indicates that Microtronic is waiting for keypad input. Press any HEX key. Display shows 4 digits now: current value (2 digits), and value of last card (2 digits), e.g., 1304 means you have 13, and last card was 4. Get another card with 1, or decline with 0. Computer will also take cards. The player who got closest to 21 wins ("G00D" or "BAD" output). Stop program with HALT.
Set the realtime clock: HALT-PGM-3. Enter time, using 24 hours format. Display time with HALT-PGM-4. Set and see the date: HALT-PGM-0.
Play the NIM game in ROM: HALT-PGM-7. HALT-NEXT-0-0-RUN. Display shows "? 0000". Enter number of matches on the table, e.g., 15: 1-5. Enter number of matches you can take max: 3. Now make the first move: 2. Display shows 1012. Now - meaning: computer took 1, leaving 12 matches on the table. Make your next move. Player who has to take the last match looses, e.g., display shows "3EE1" and Output LEDs flicker. If you win, computer shows "FOO".
Next, maybe try Lunar Lander. Clear memory: HALT-PGM-5. Enter SD Card loader: HALT-PGM-1. Us UP and DOWN buttons to select LUNAR.MIC. Hit ENTER. Display shows "2095? YOU NO" - say "NO = CANCEL Button". Display shows "Turbo?". Say NO = CANCEL BUTTON (YES is also possible, and faster, but that way you see the loading process). Display shows H00 FO2. Start the program: HALT-NEXT-0-0-RUN. Display shows "?A0500" = Current Height of Lunar Lander. Hit 0. Next the display shows "?B0050" = Current Velocity in m/s. Hit 0. Display shows "?C0120" = Current Fuel left. Now display shows "? 00". Enter the amount of fuel you would like to use. Use HEX button "A" to continue. Continue until game ends. Possible outputs: EEEEEEE = You landed successfully! AAAAAA = Lander crashed - velocity too high. AEAE - Out of fuel. AFAF = you're lost in outer space, you put in too much fuel.
Next, try a ROM program - Prime Numbers. HALT-PGM-8. HALT-NEXT-0-0-RUN. Display shows "? 00000". Push B. Enter "123", then C - What is the next prime number higher than 123? Microtronic comes back after 20 seconds: 127.
Write you first program: HALT-PGM-5 (Clear Memory). HALT-NEXT-0-0. Now change display mode: push RIGHT button until you see PC MNEMONICS..." etc. Then enter: F-0-8-NEXT F-1-0-NEXT 5-1-0-NEXT F-E-0-NEXT C-0-2-NEXT. Program entered. Double check: HALT-NEXT-0-0. Use NEXT button to step through. See the MNEMONICS. Or use UP DOWN for navigation through program. Run the program: HALT-NEXT-0-0-RUN. Change display mode: RIGHT or LEFT. Change speed of CPU emulation while the program is running: use UP DOWN.

Please note: there is a MICRO.INI init file on SD card which determines some default values for the UI and emulation. Please see the documentation here:
https://github.com/lambdamikel/Busch-2090?tab=readme-ov-file#init-file-on-sdcard---microini

I hope you enjoy this little very limited, but IMHO, very fun microcomputer!

Thanks much for supporting this project

Yours,

Michael Wessel aka LambdaMikel
