lambdamikel/Busch-2090/manuals/2210976NAT.pdf

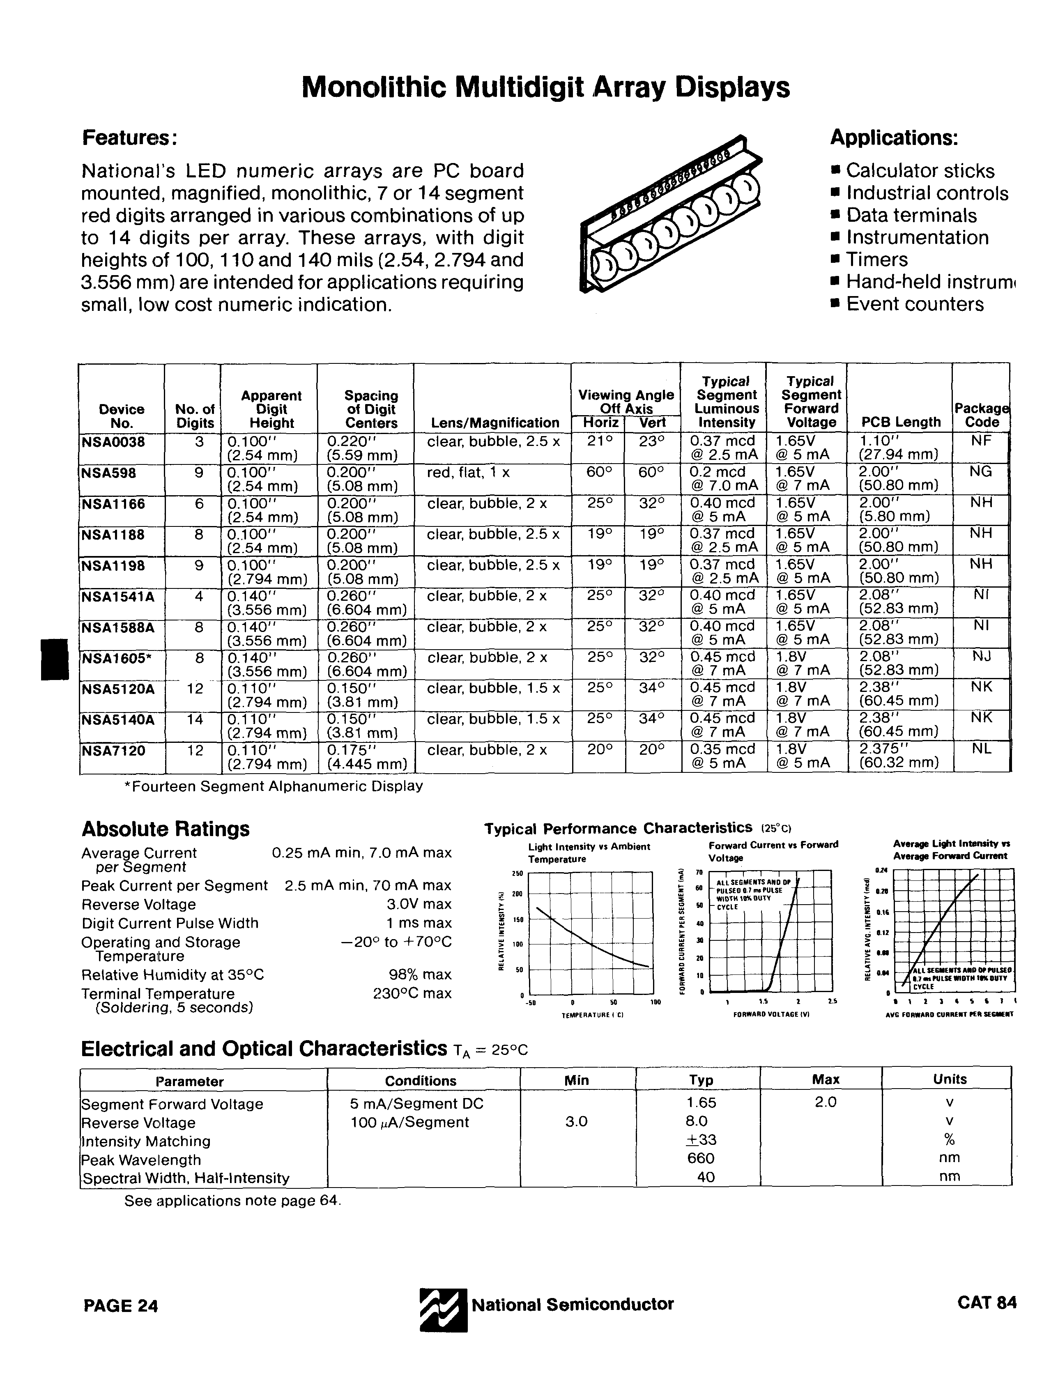
[picture p109: page 1]
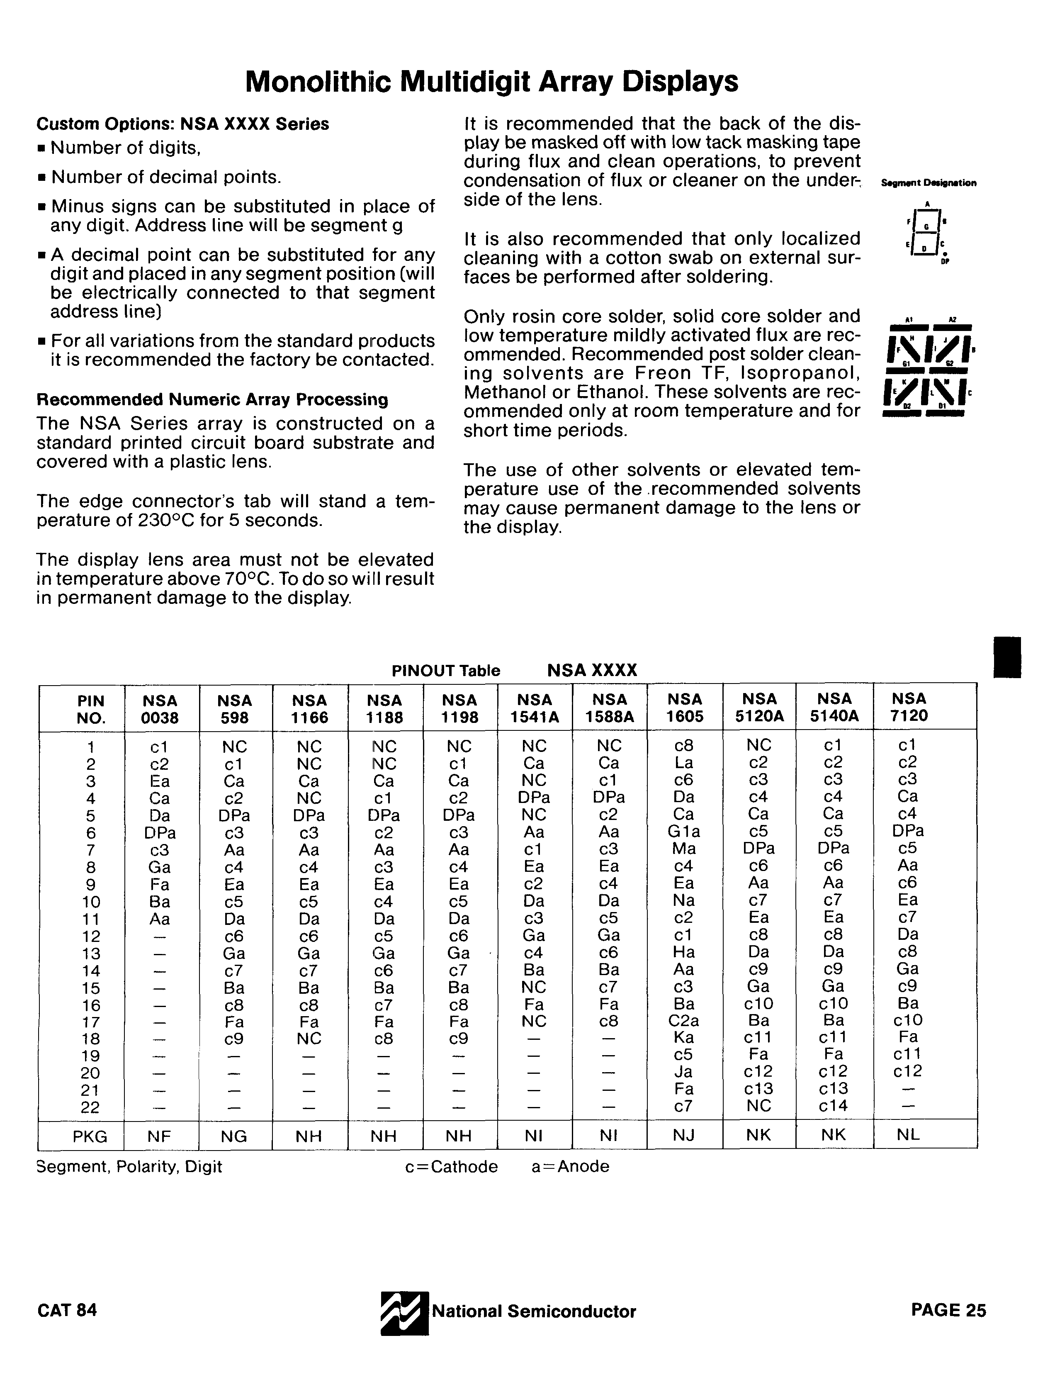
[picture p110: page 2]
