lambdamikel/Busch-2090/manuals/mc-1983-03-microtronic-review.pdf

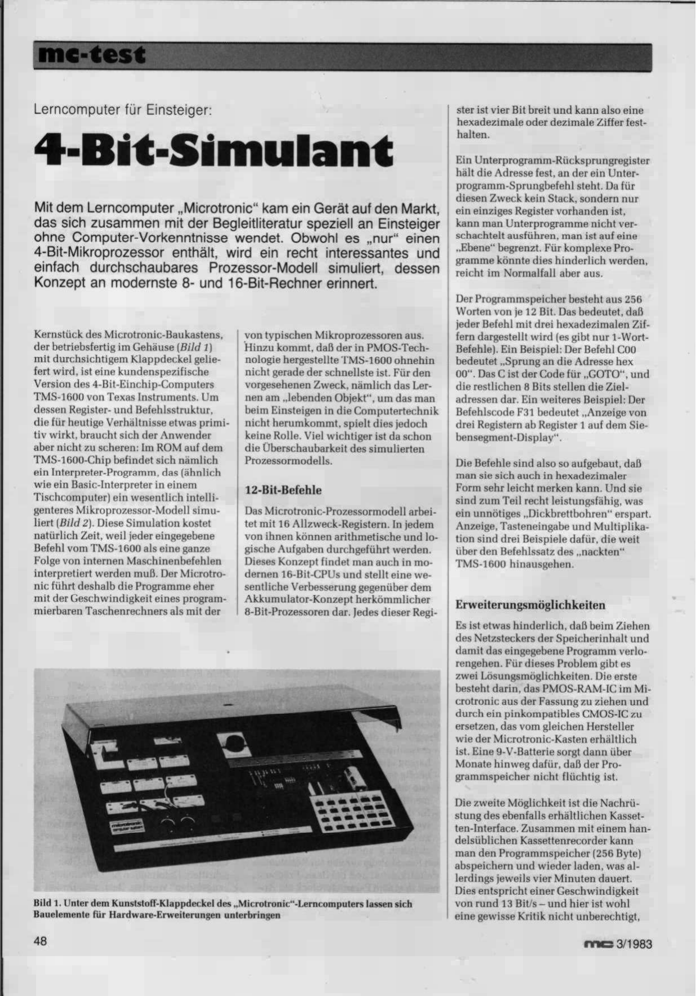
[picture p111: page 1]
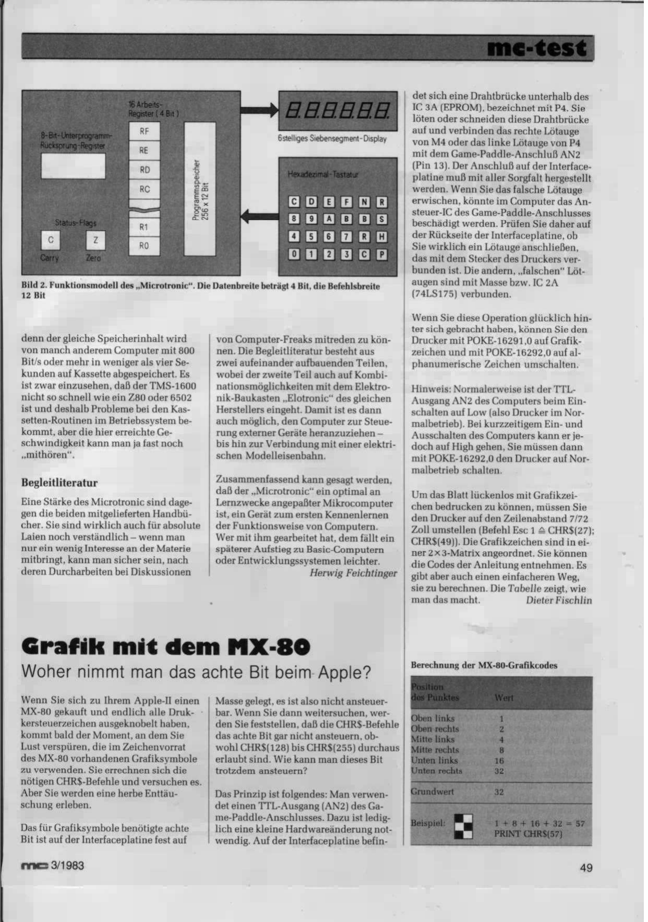
[picture p112: page 2]
