lambdamikel/Busch-2090/hackaday/microchip-makes.jpg

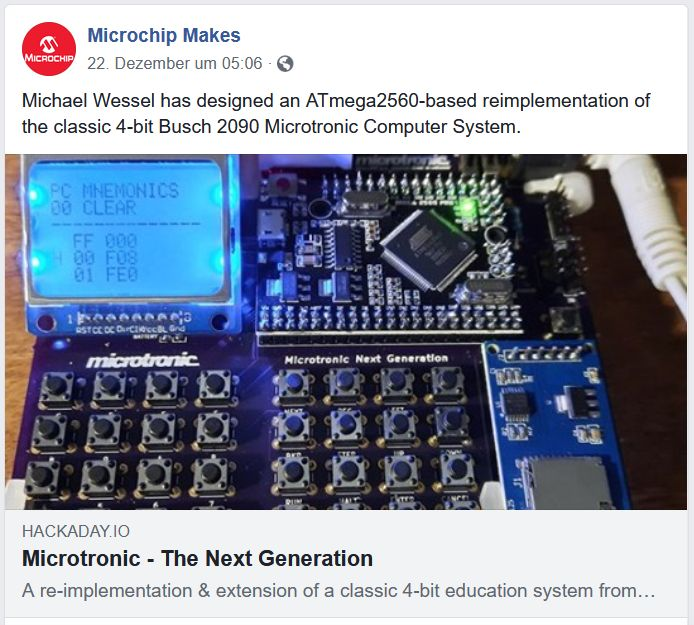
hackaday/microchip-makes.jpg
