lambdamikel/Busch-2090/manuals/blockschaltbild.jpg

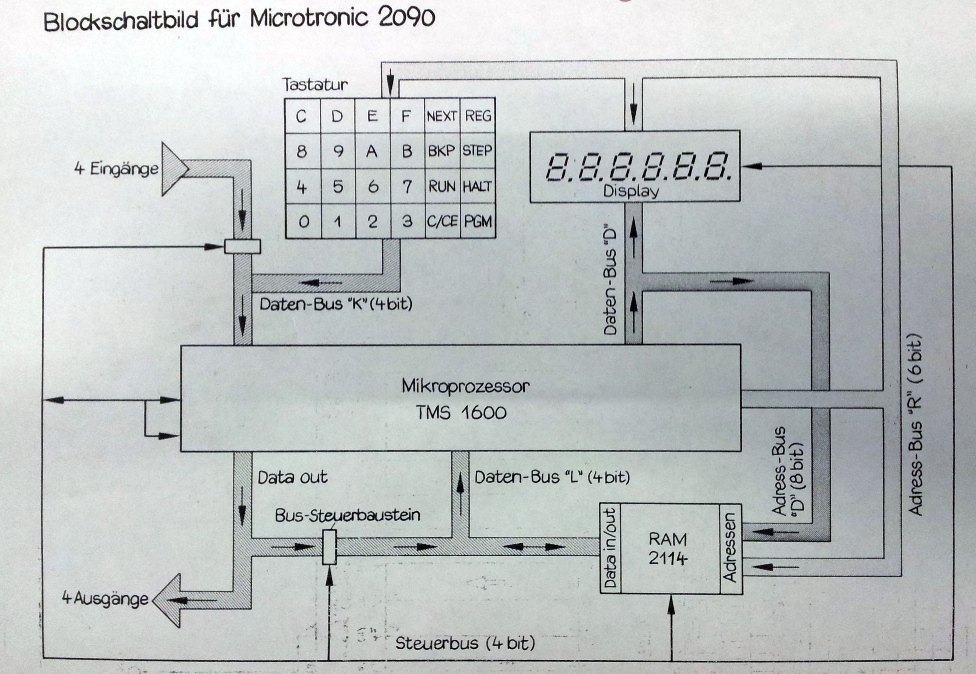
manuals/blockschaltbild.jpg
