lambdamikel/Busch-2090/manuals/elo-8-1982-microtronic-review-page-1.jpg

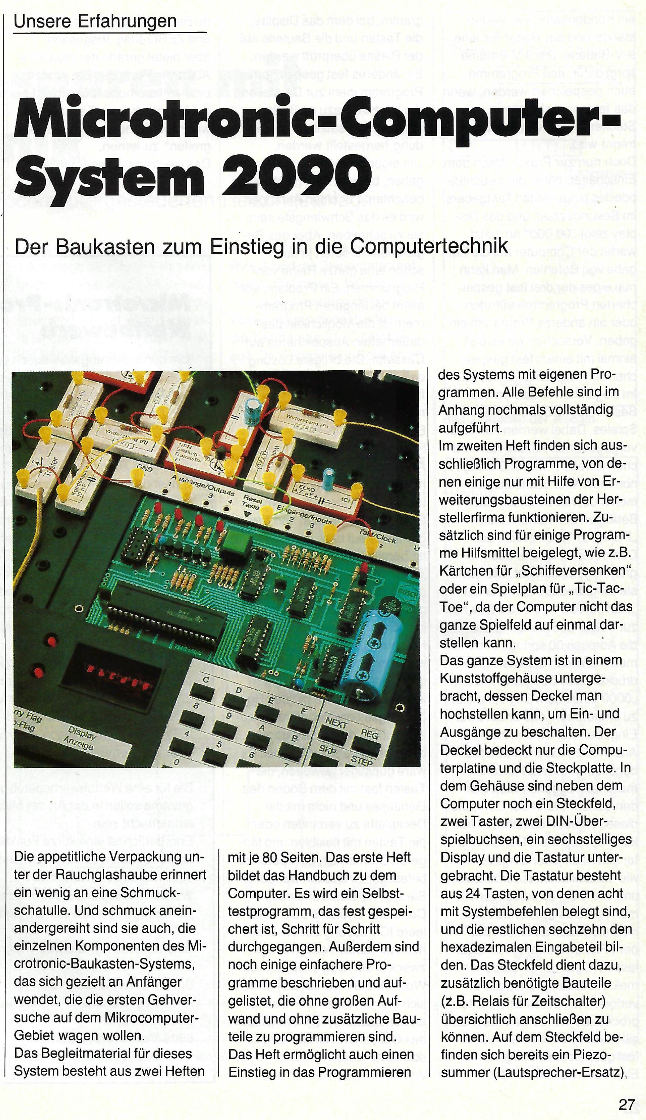
manuals/elo-8-1982-microtronic-review-page-1.jpg
