lambdamikel/Busch-2090/manuals/elo-8-1982-microtronic-review-page-2.jpg

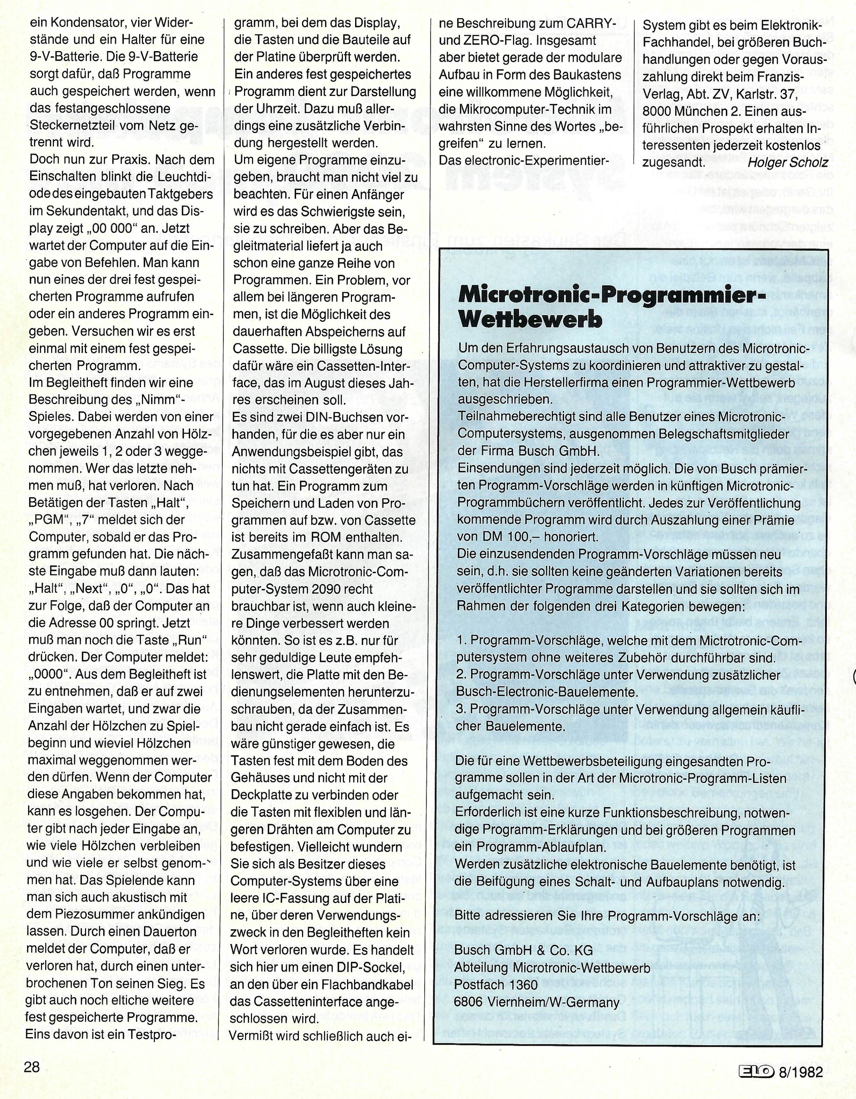
manuals/elo-8-1982-microtronic-review-page-2.jpg
