lambdamikel/Busch-2090/manuals/HE-2.png

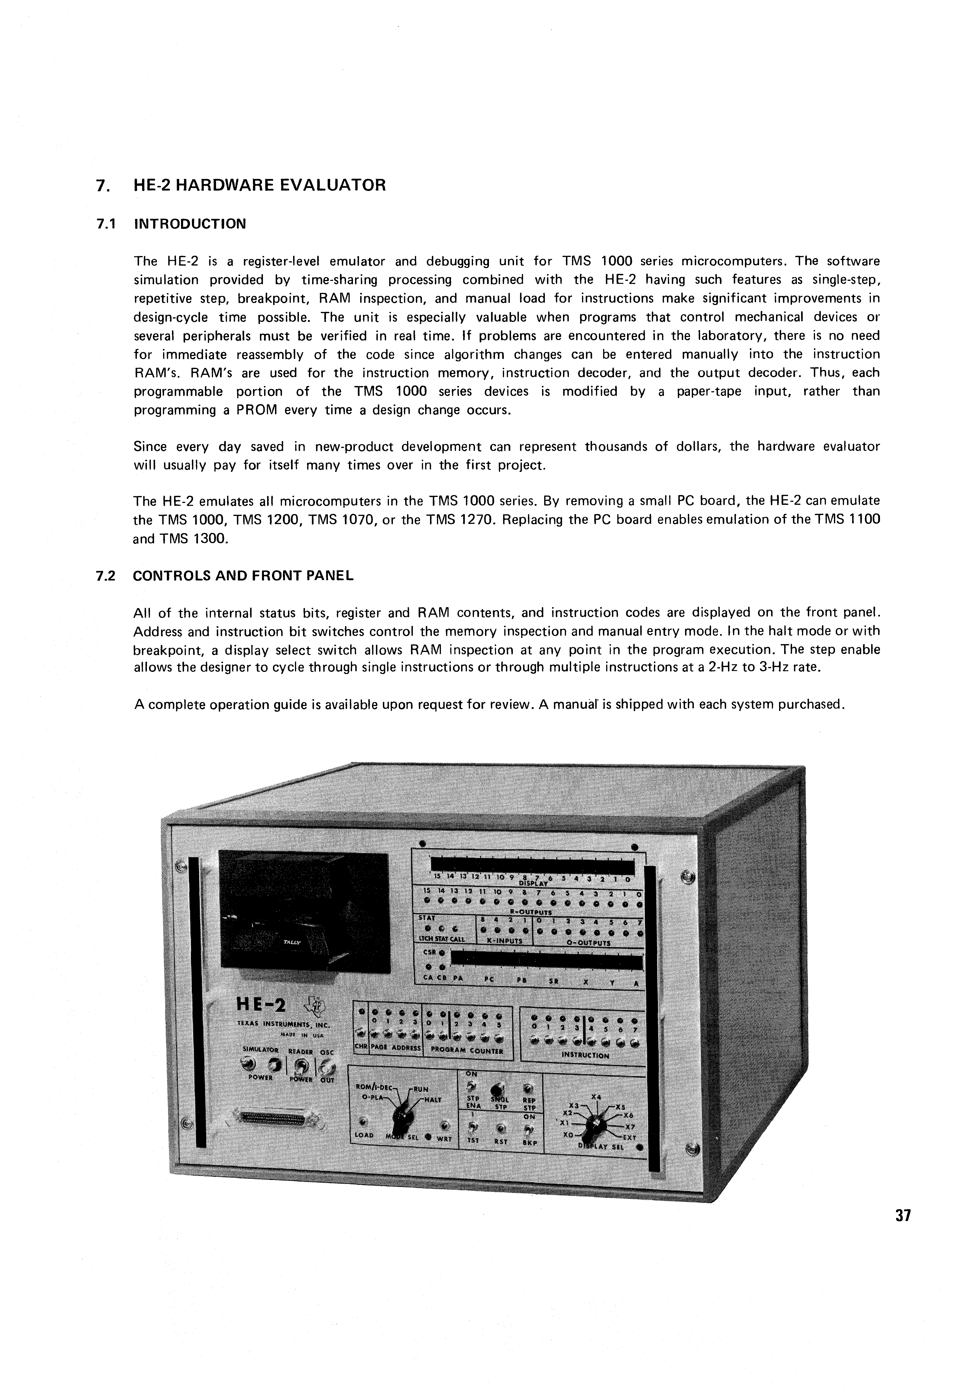
manuals/HE-2.png
