lambdamikel/Busch-2090/manuals/microtronic.jpg

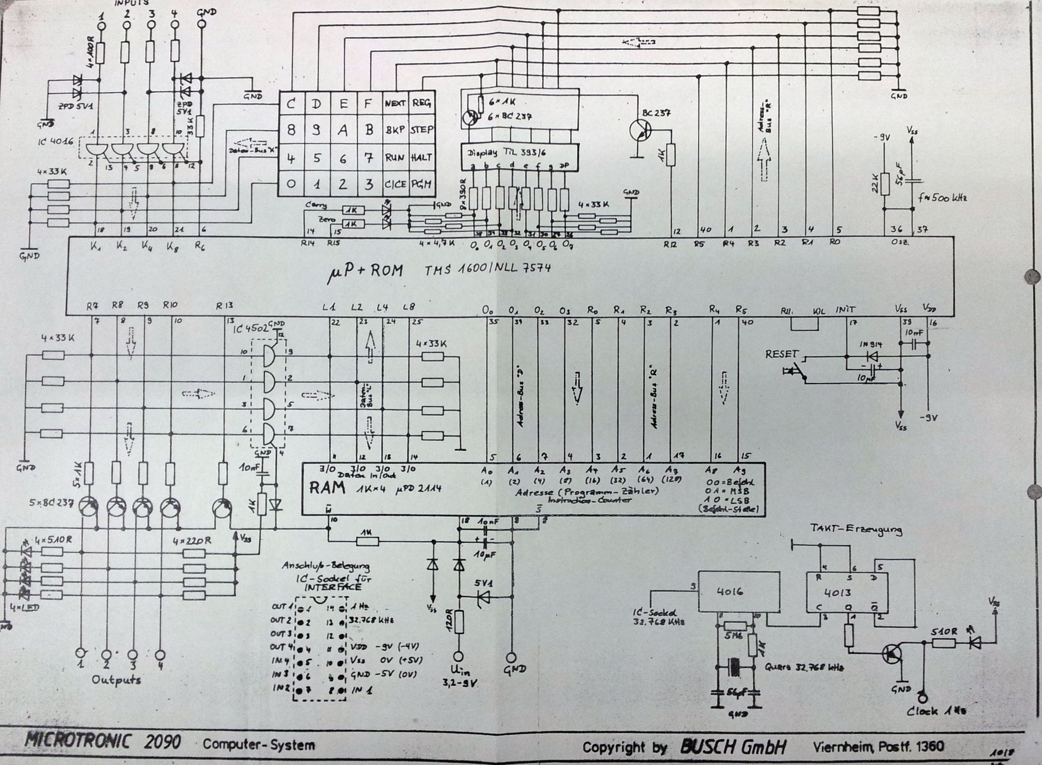
manuals/microtronic.jpg
