lambdamikel/Busch-2090/manuals/netzteil.jpg

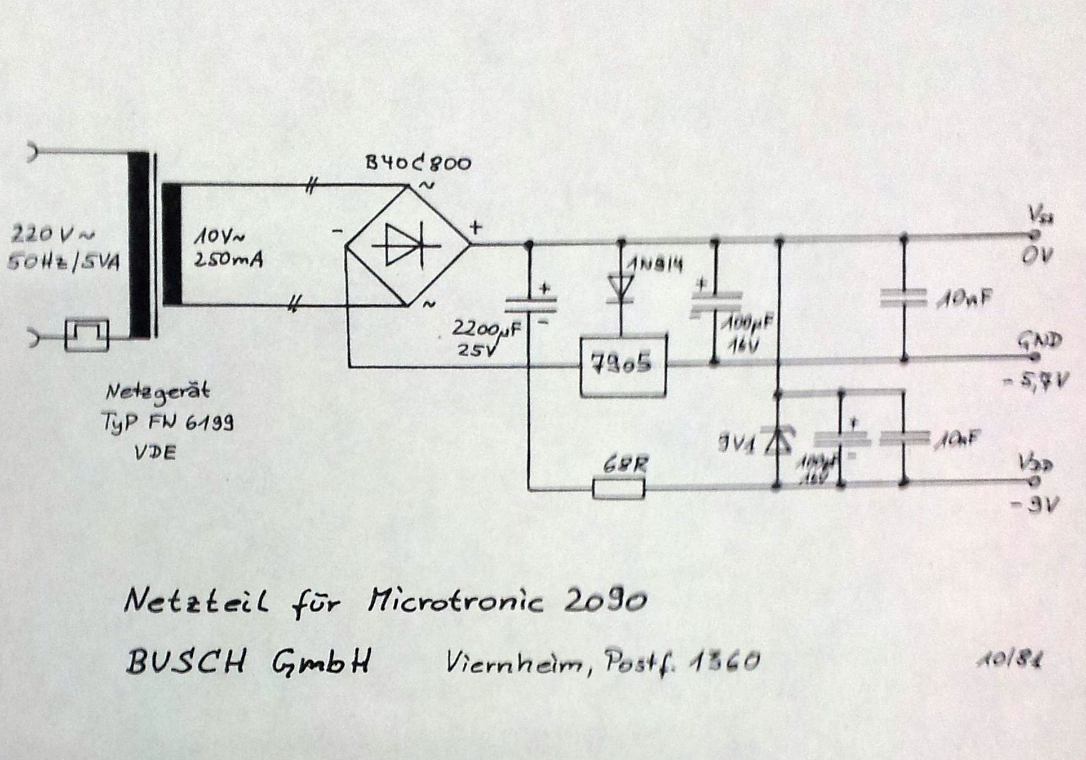
manuals/netzteil.jpg
