lambdamikel/Busch-2090/manuals/spielmittel-article1-page1.jpg

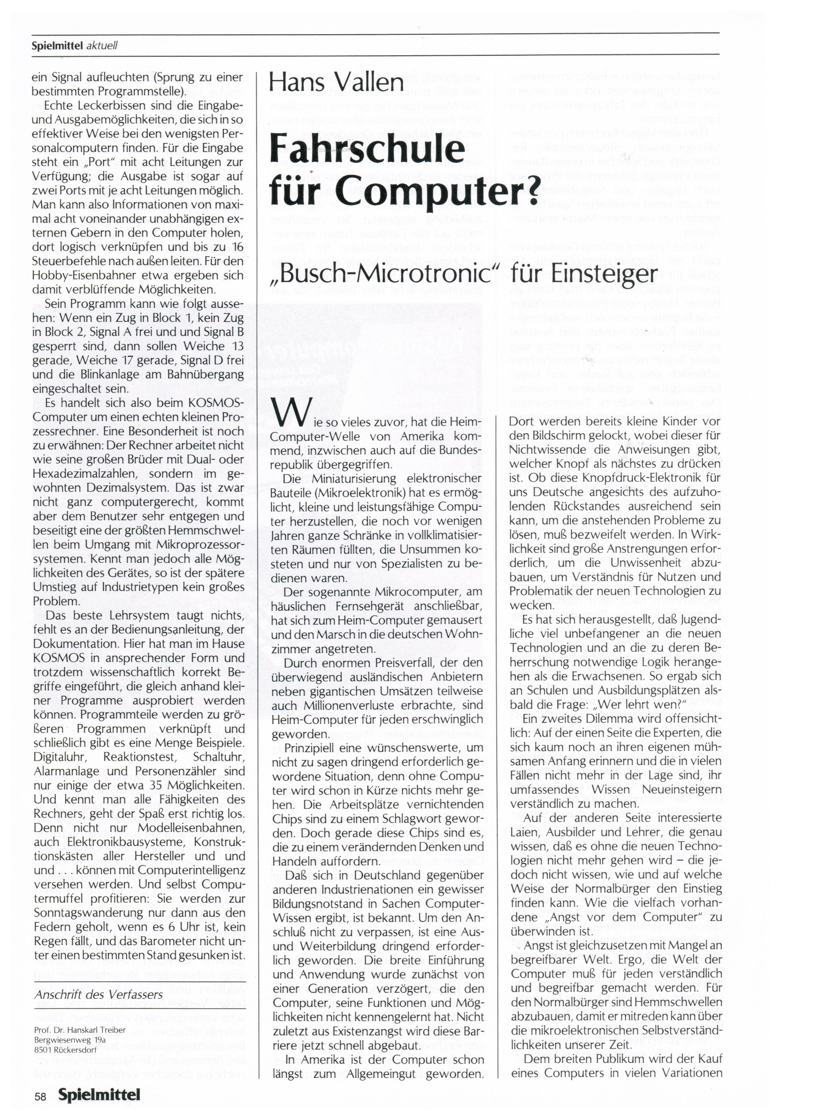
manuals/spielmittel-article1-page1.jpg
