lambdamikel/Busch-2090/manuals/spielmittel-article1-page2.jpg

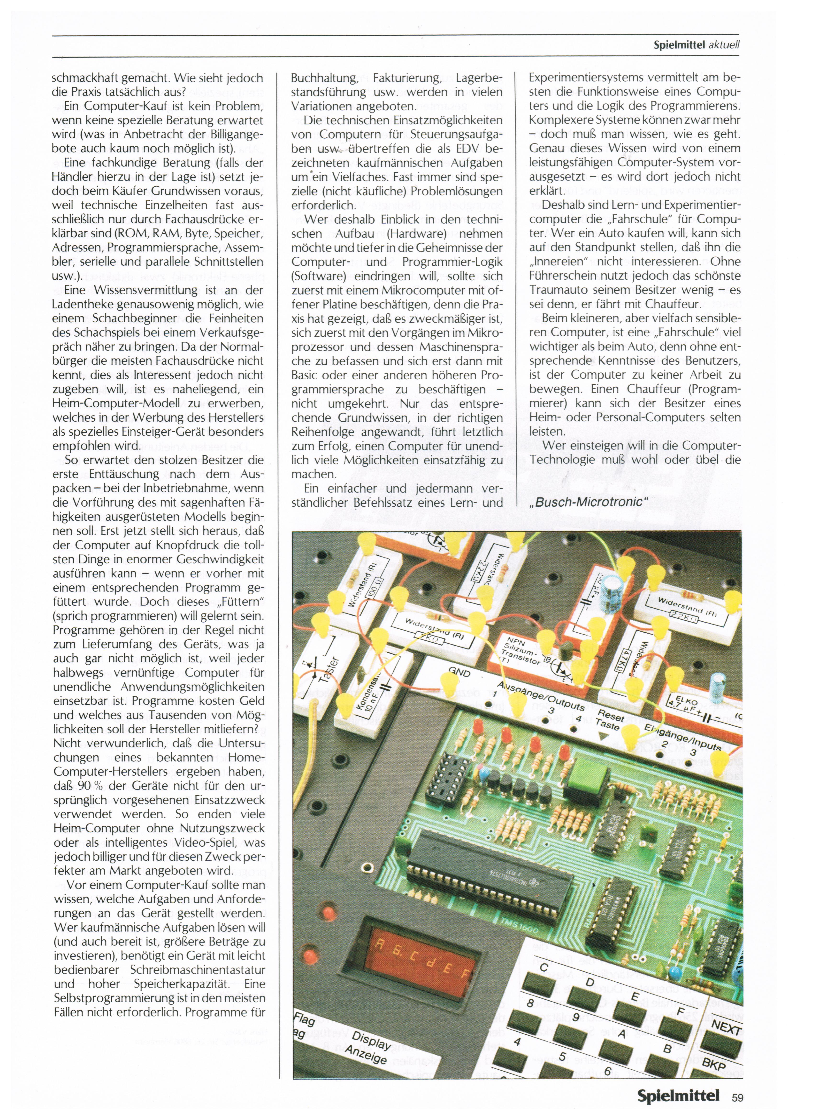
manuals/spielmittel-article1-page2.jpg
