lambdamikel/Busch-2090/manuals/spielmittel-article1-page3.jpg

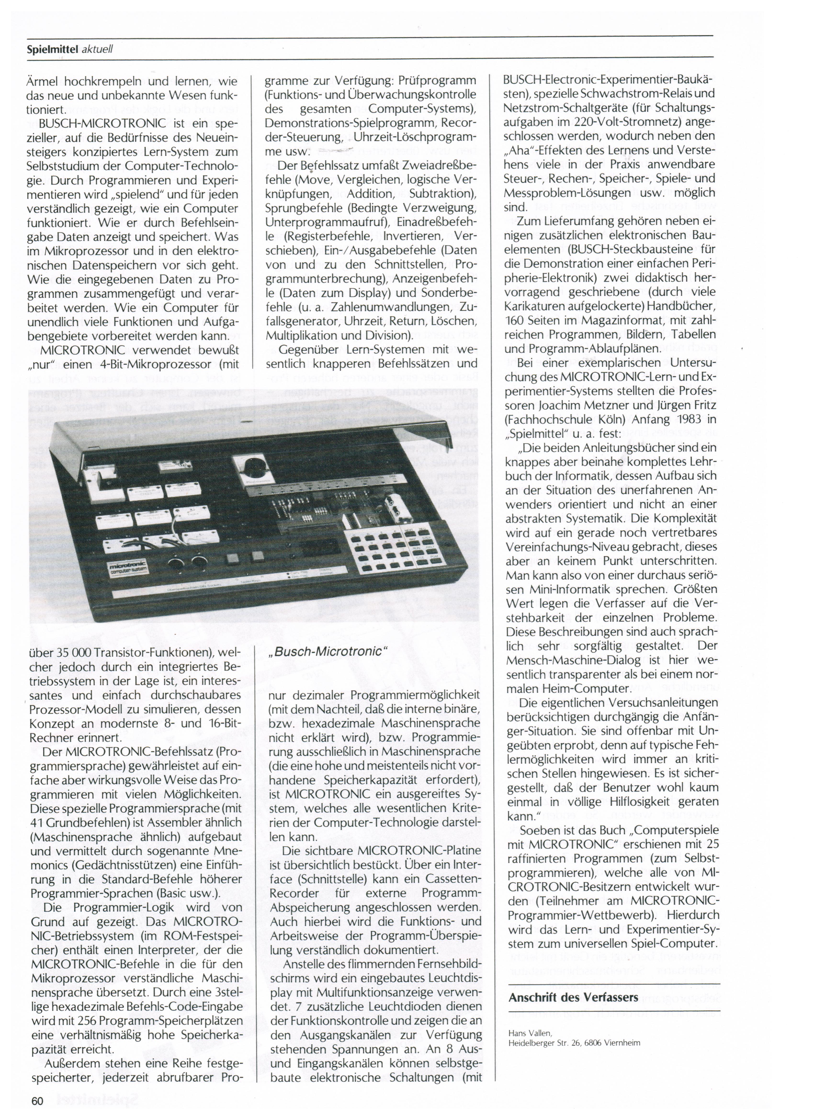
manuals/spielmittel-article1-page3.jpg
