lambdamikel/Busch-2090/manuals/spielmittel-article2-page2.jpg

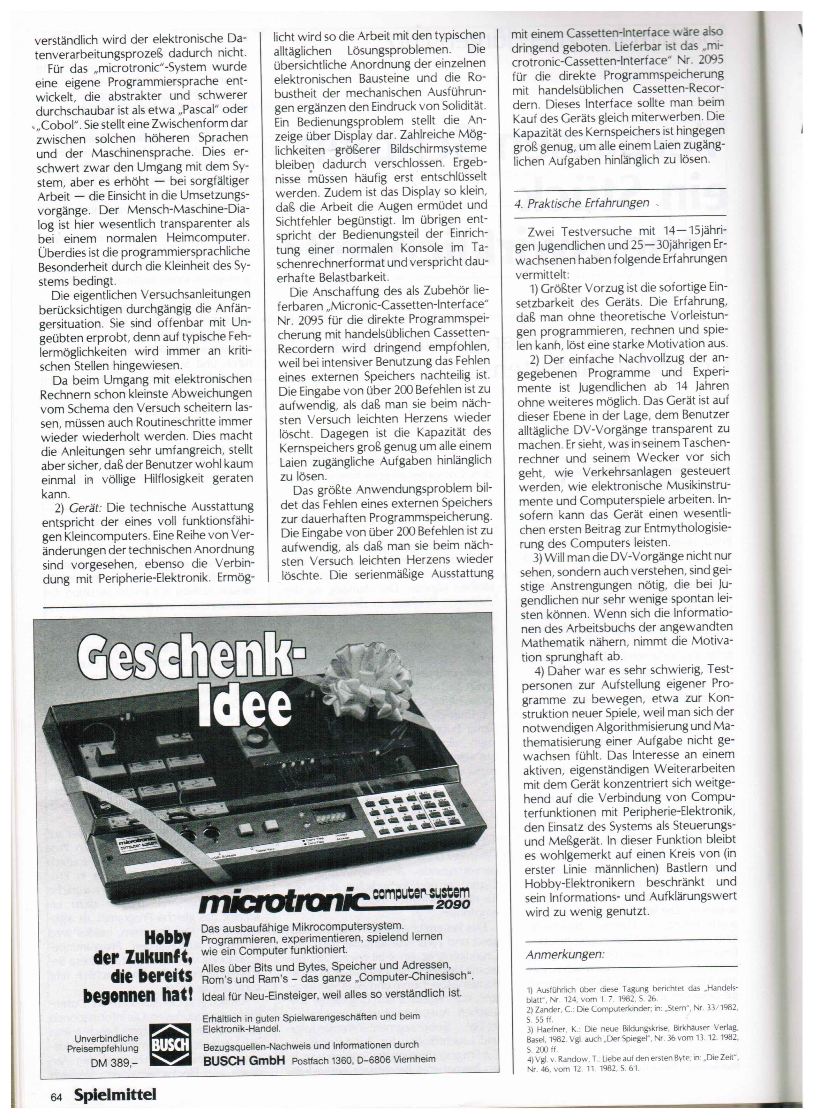
manuals/spielmittel-article2-page2.jpg
