lambdamikel/Busch-2090/hackaday/4-bit Retrocomputer Emulator Gets Custom PCB _ Hackaday.pdf

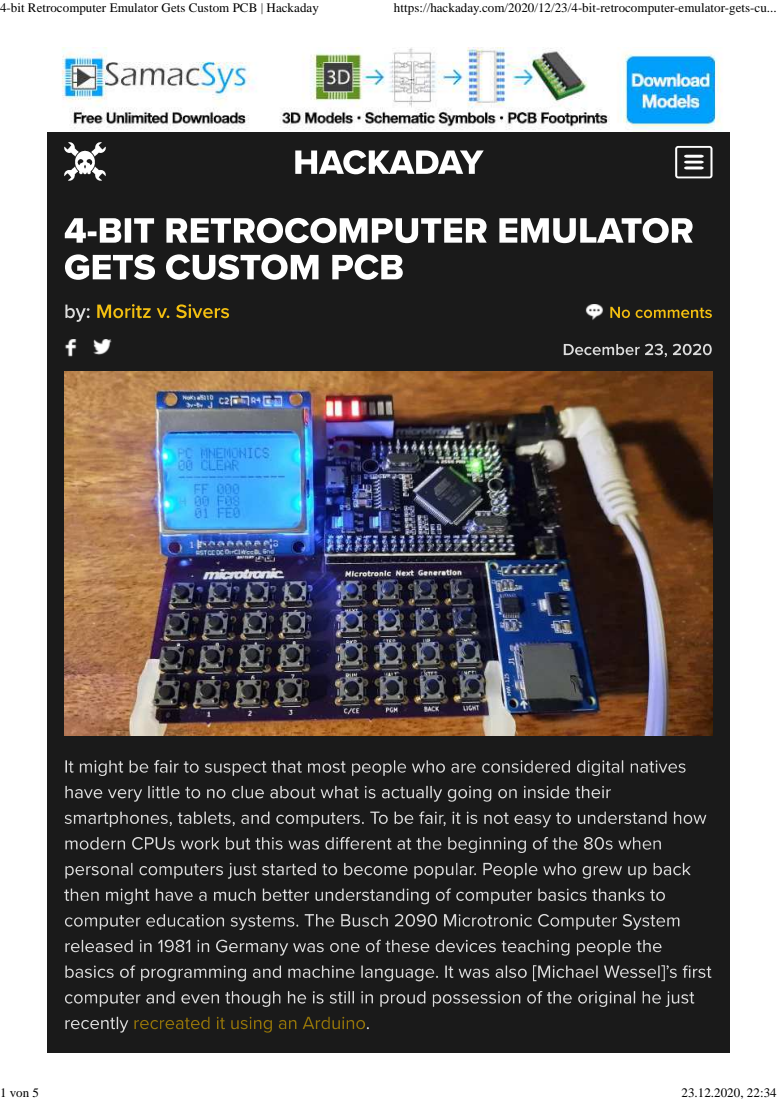
[picture p125: page 1]
4-bit Retrocomputer Emulator Gets Custom PCB | Hackaday; https://hackaday.com/2020/12/23/4-bit-retrocomputer-emulator-gets-cu...; 1 von 5

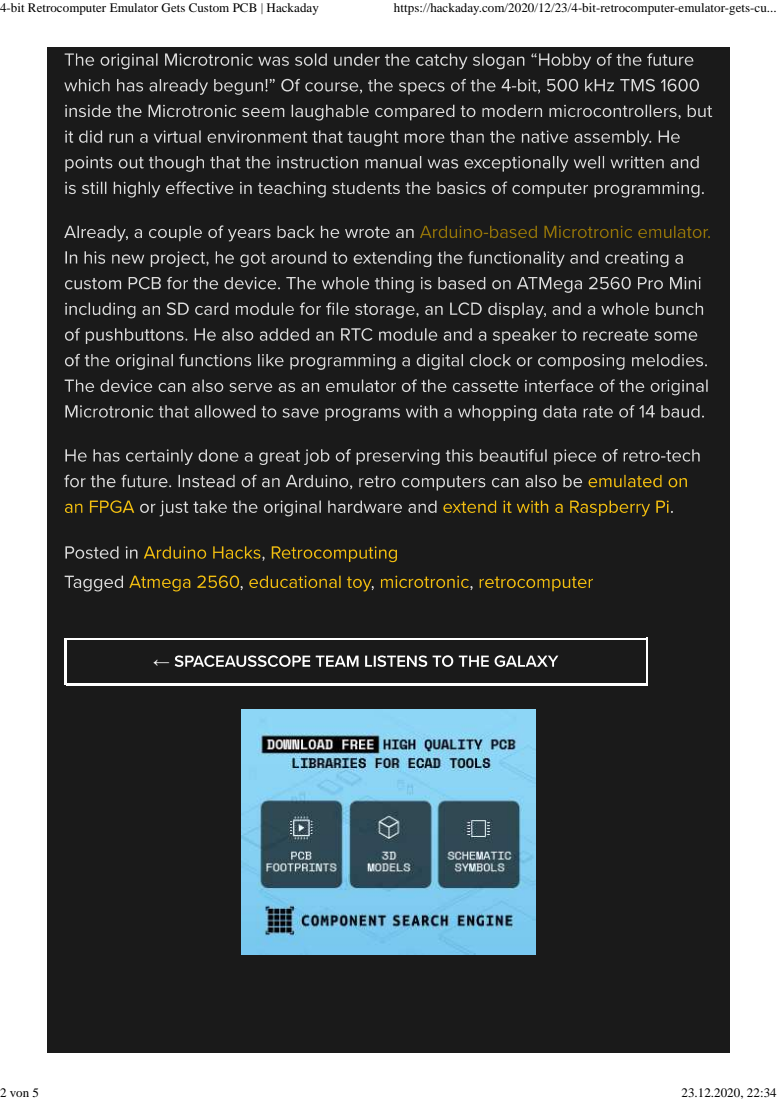
[picture p126: page 2]
4-bit Retrocomputer Emulator Gets Custom PCB | Hackaday; https://hackaday.com/2020/12/23/4-bit-retrocomputer-emulator-gets-cu...; 2 von 5
