lambdamikel/Busch-2090/Microtronic-Phoenix/schematics.pdf

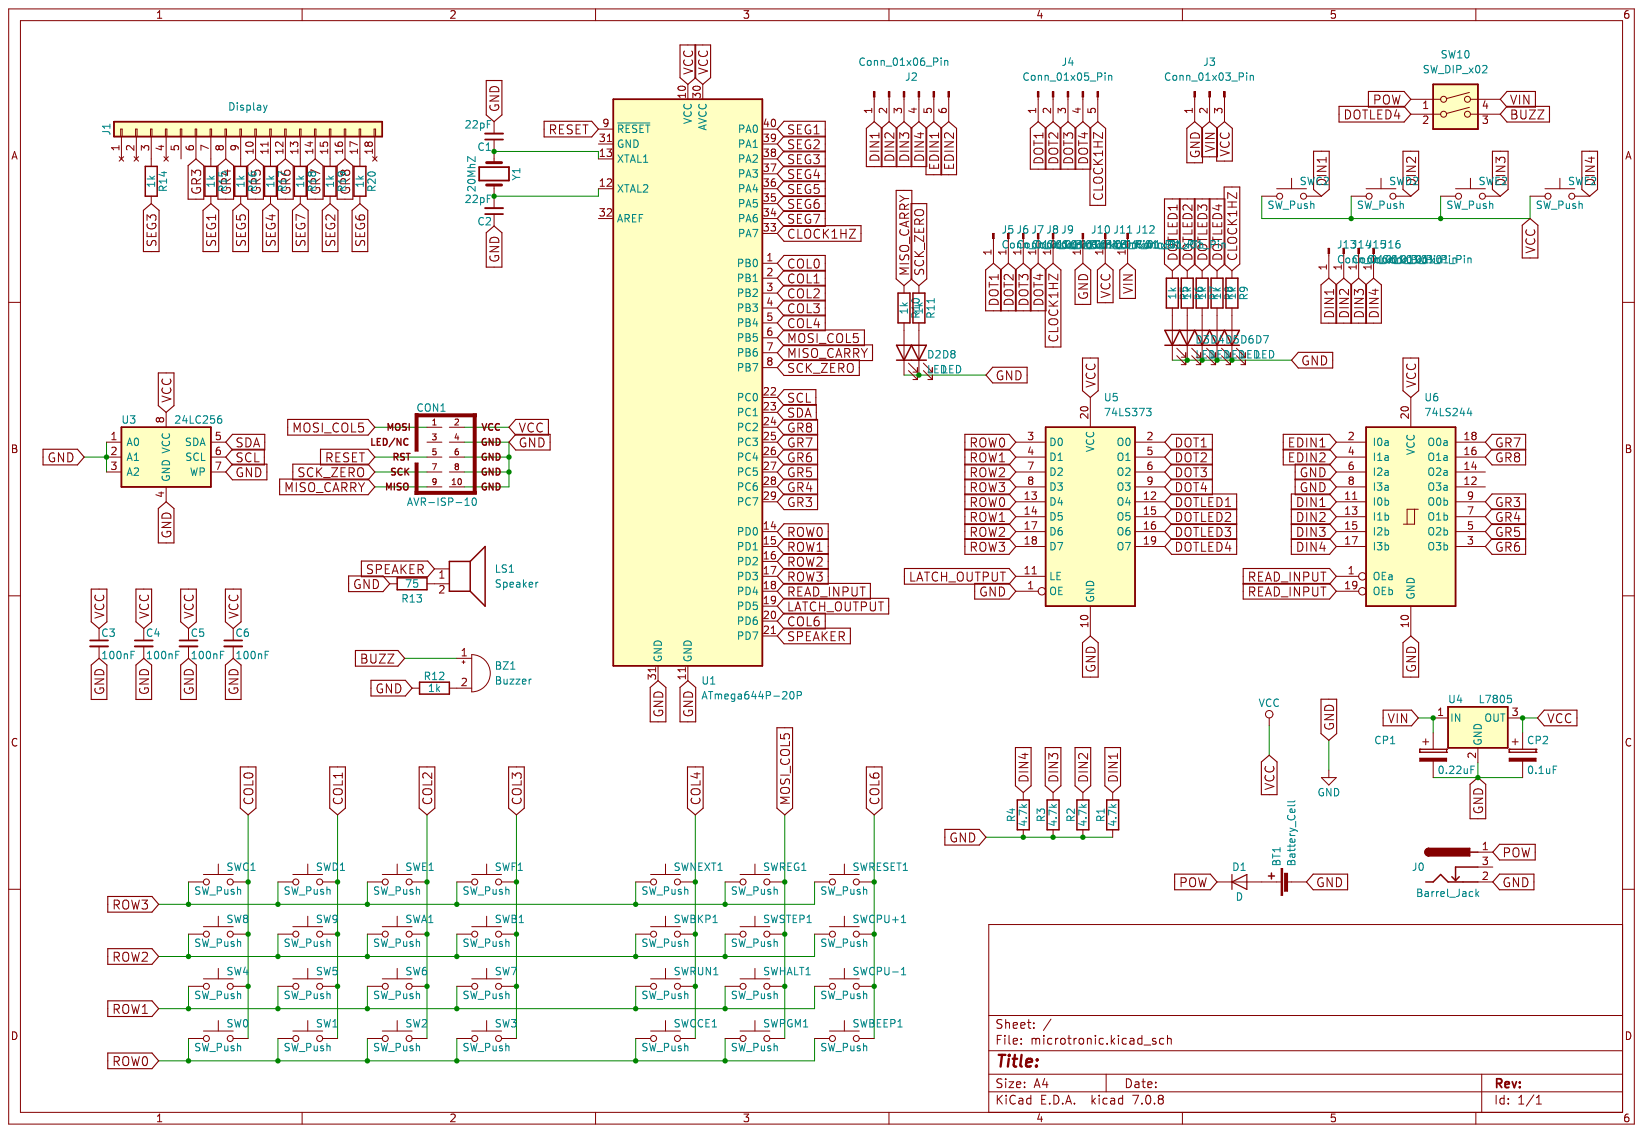
[picture p127: page 1]
