lambdamikel/Busch-2090/images/retro-microtronic-schematics.pdf

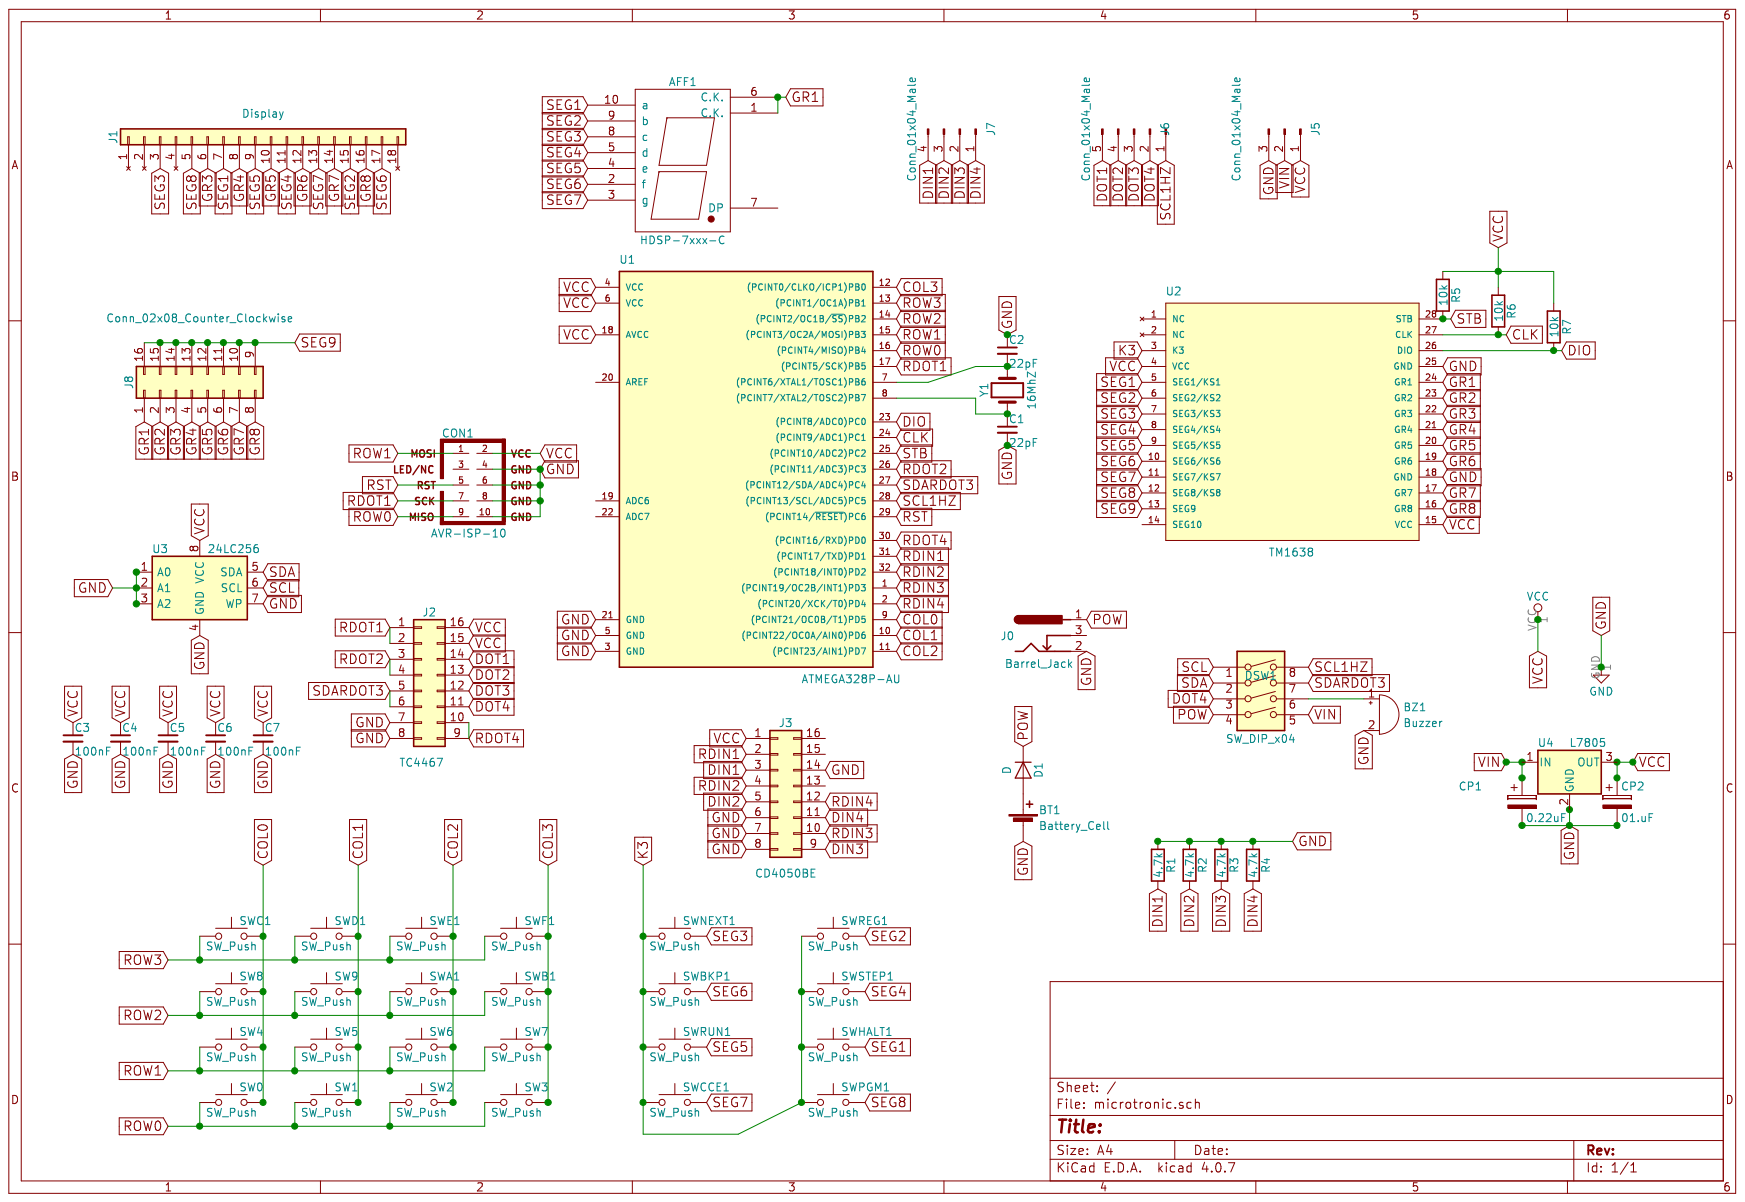
[picture p128: page 1]
