lambdamikel/Busch-2090/images/schematics-microtronic-emulator-bw.pdf

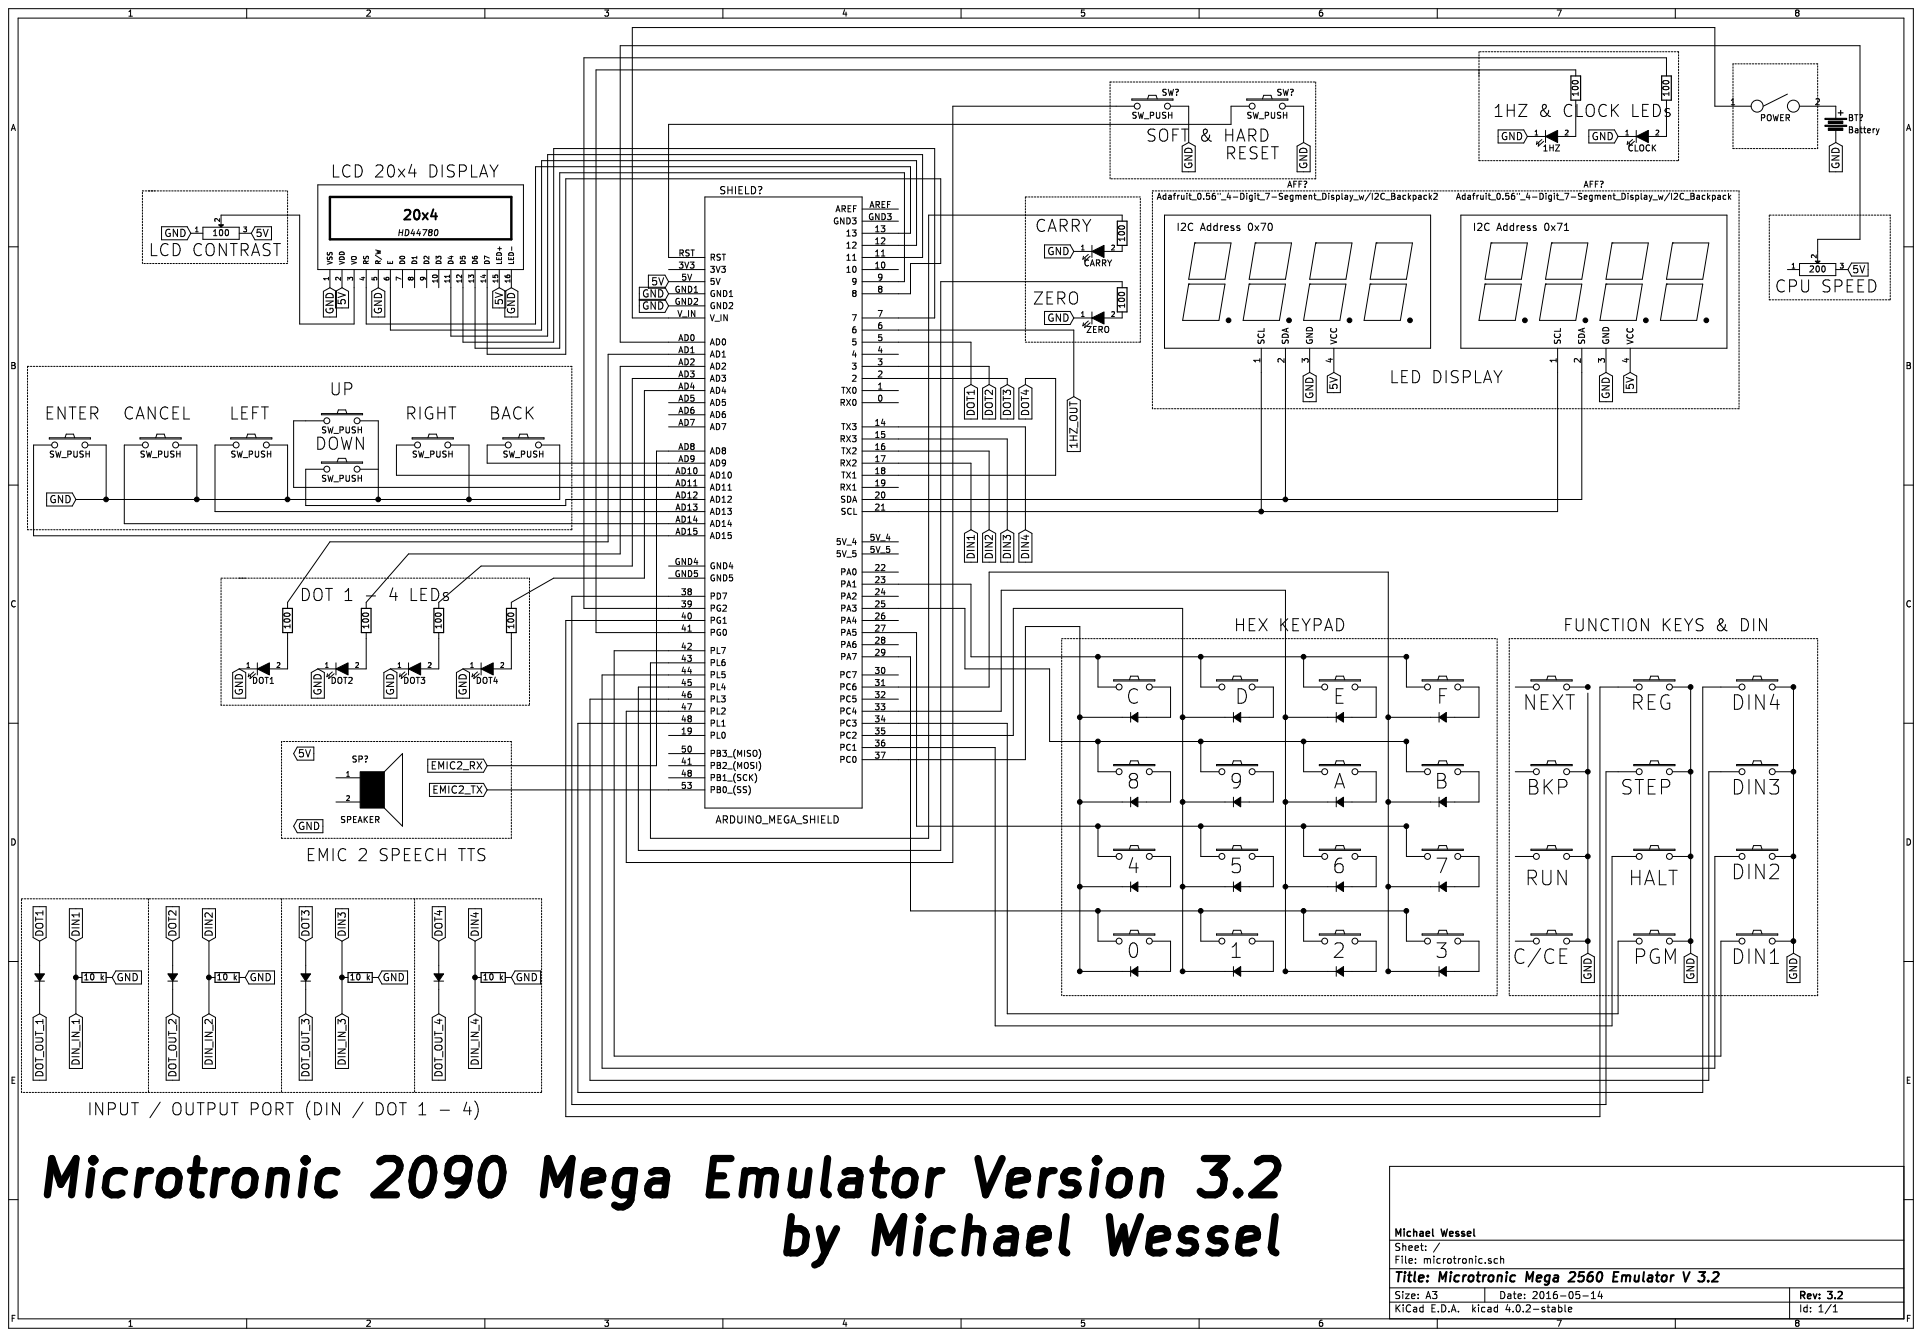
[picture p129: page 1]
