lambdamikel/Busch-2090/images/schematics-microtronic-emulator-color.pdf

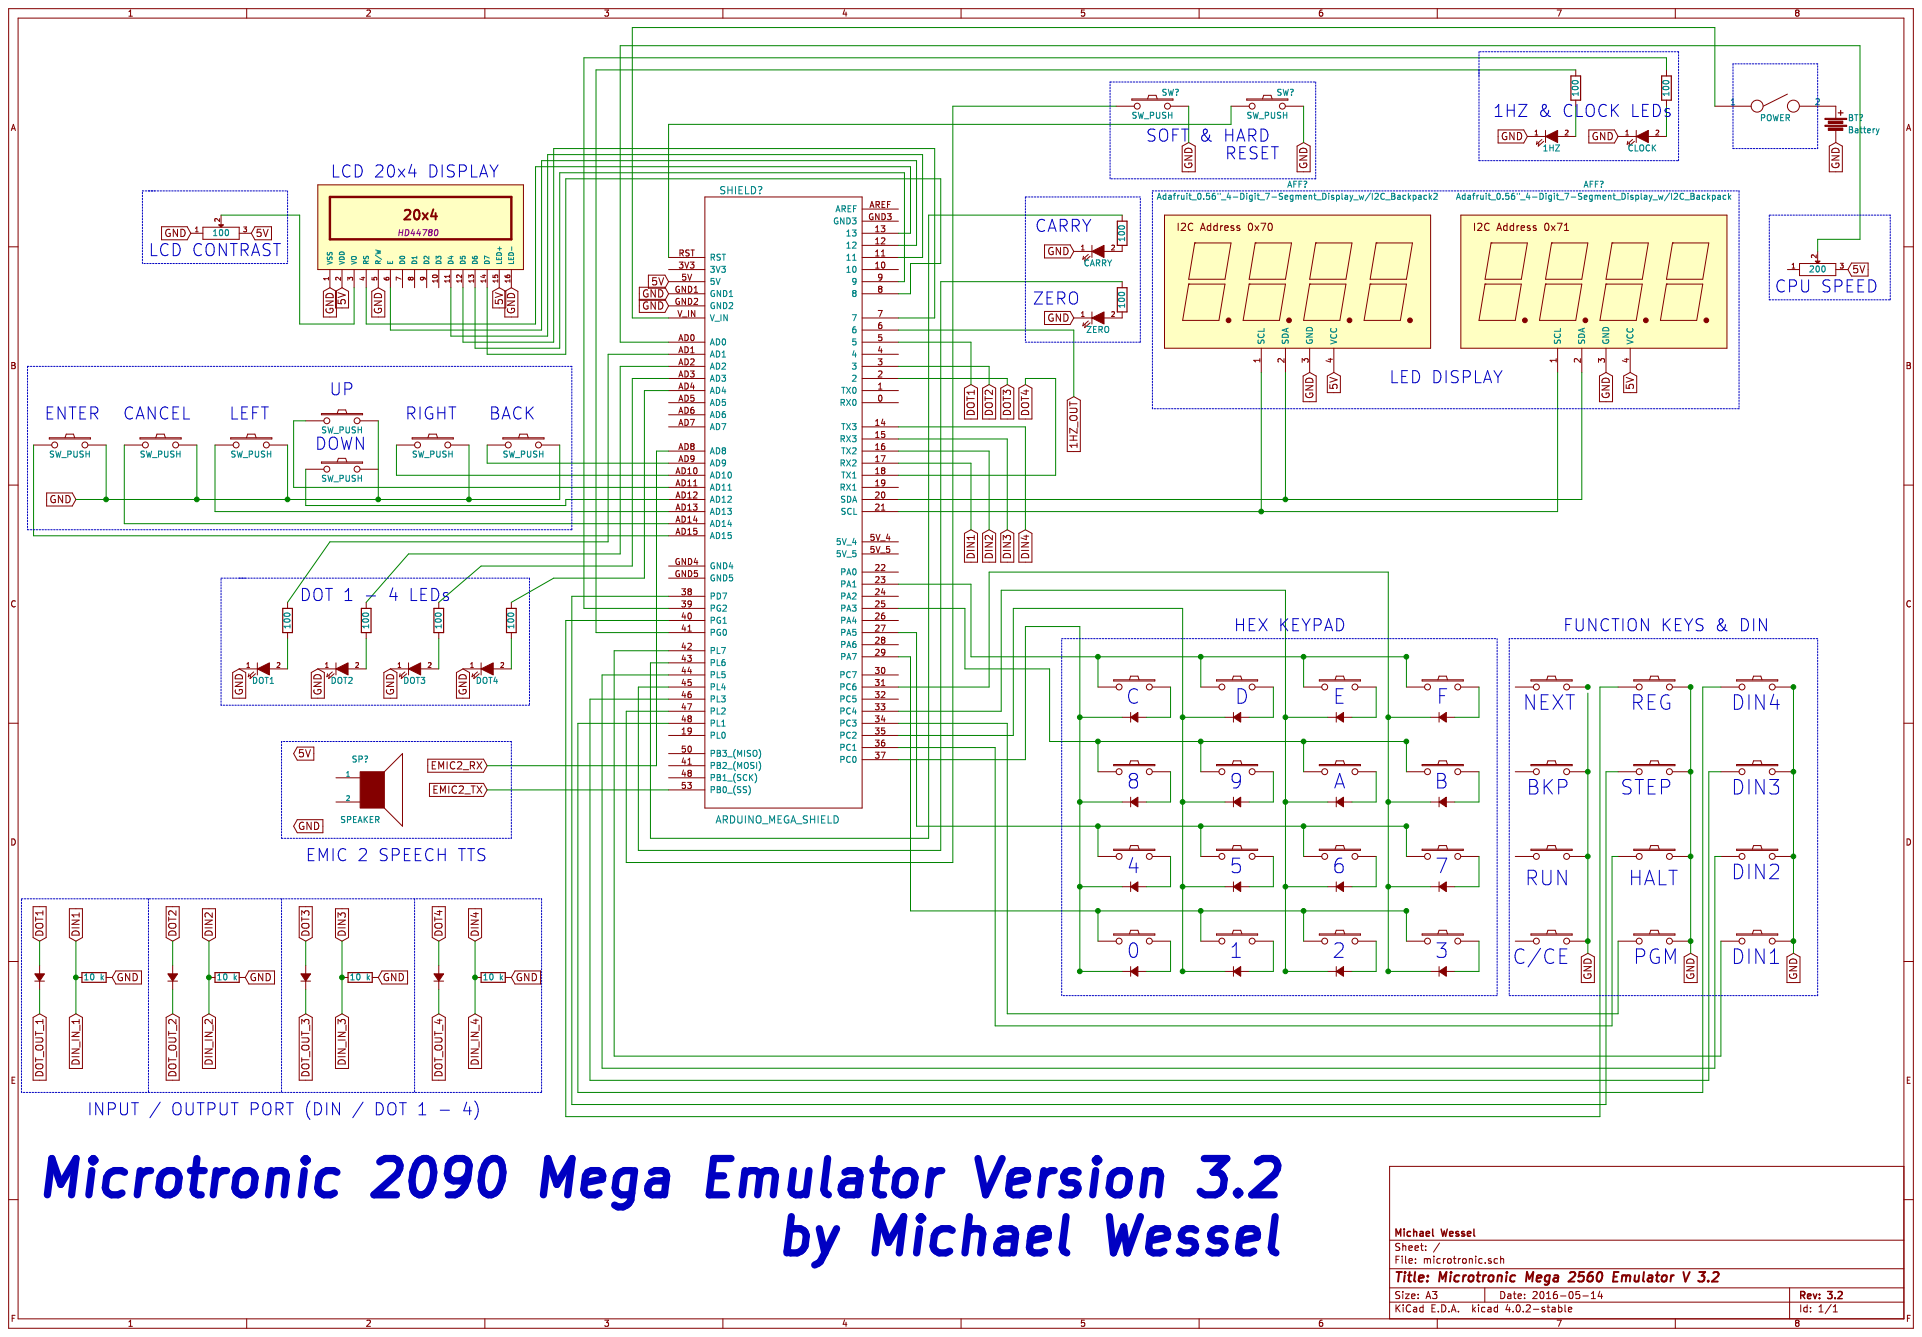
[picture p130: page 1]
