lambdamikel/Busch-2090/hackaday/Microtronic - The Next Generation Is a 4-bit MCU Trainer Running on an Arduino Mega - Hackster.io.pdf

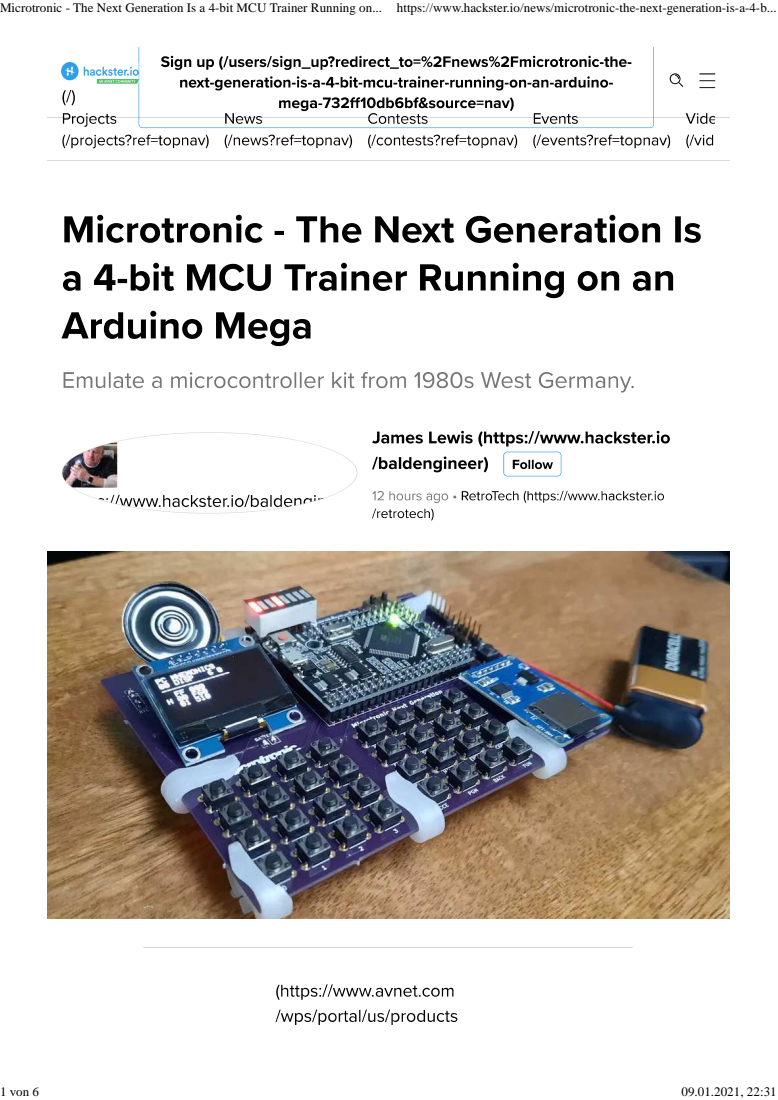
[picture p131: page 1]
1 von 6

Microtronic - The Next Generation Is a 4-bit MCU Trainer Running on... https://www.hackster.io/news/microtronic-the-next-generation-is-a-4-b...

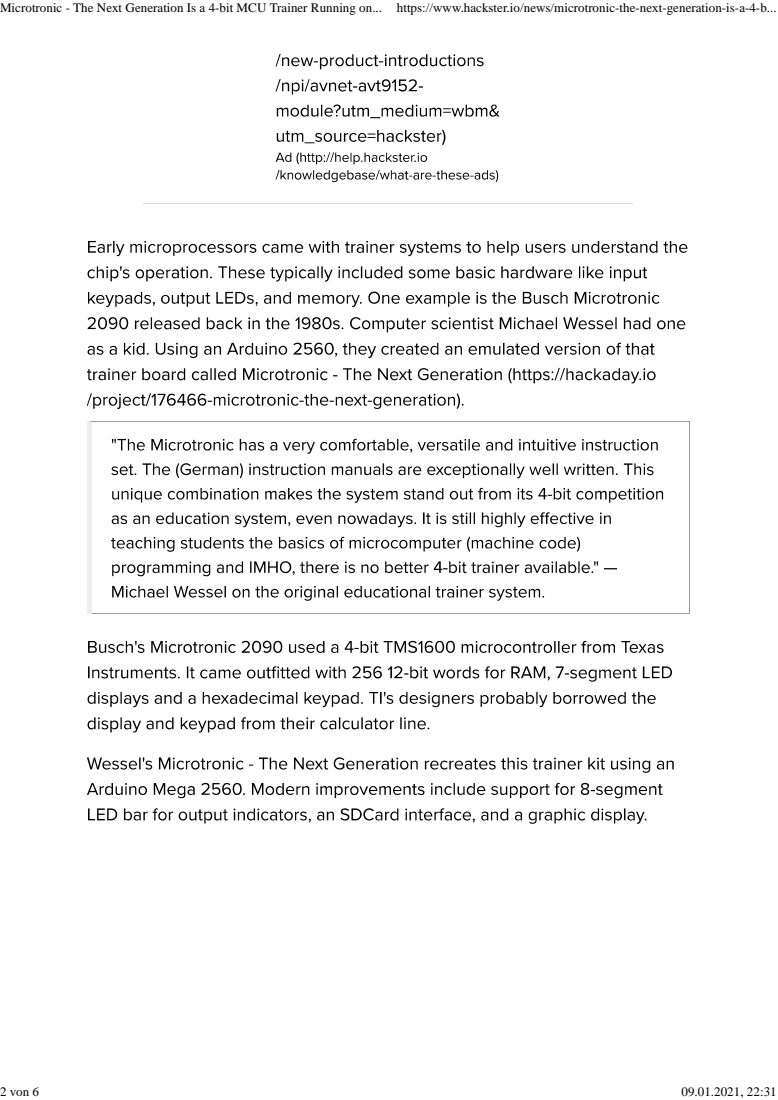
[picture p132: page 2]

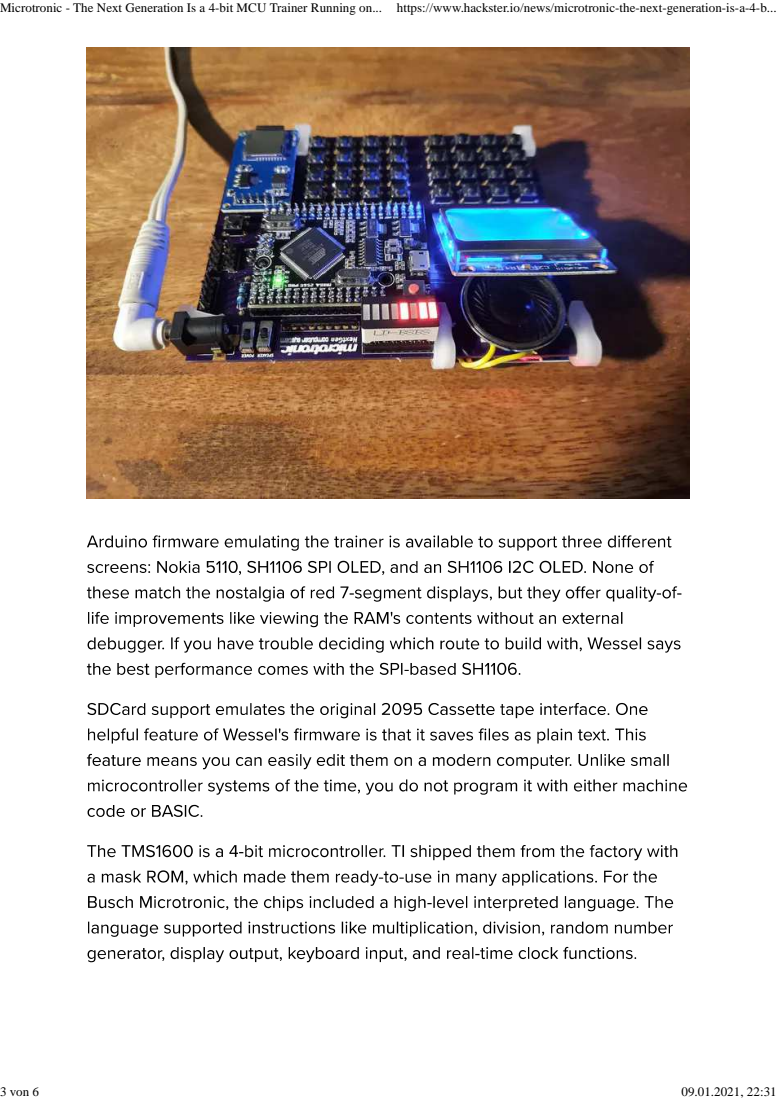
[picture p133: page 3]

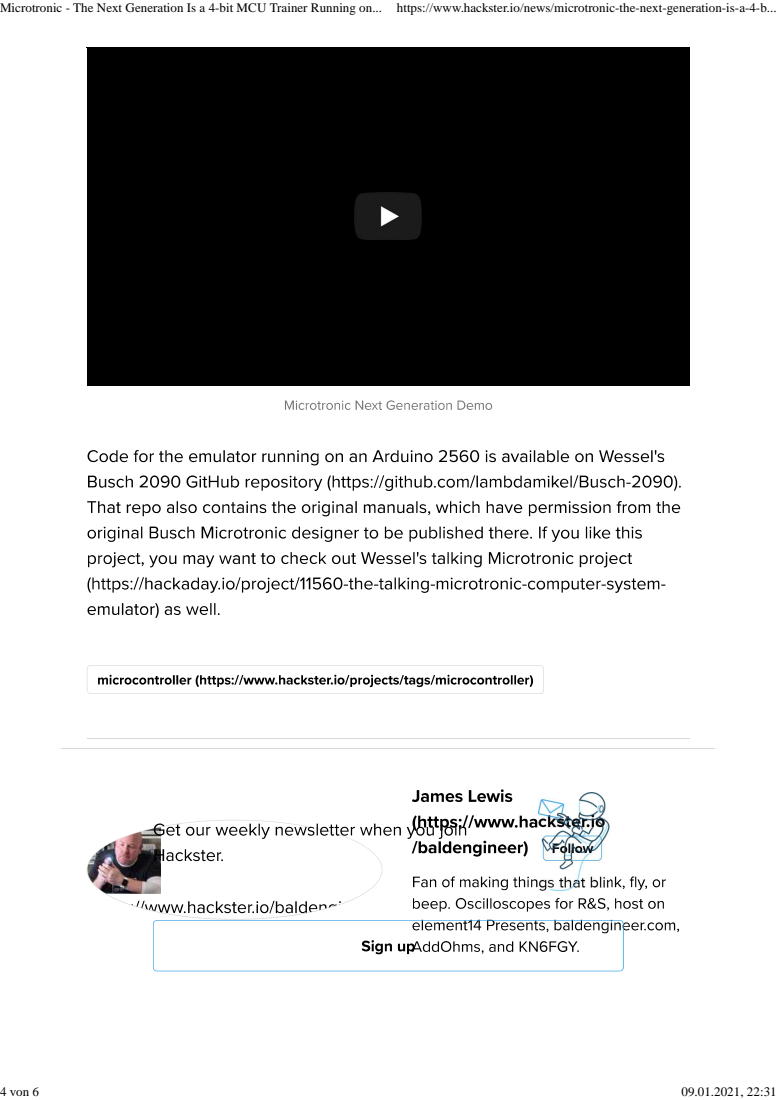
[picture p134: page 4]

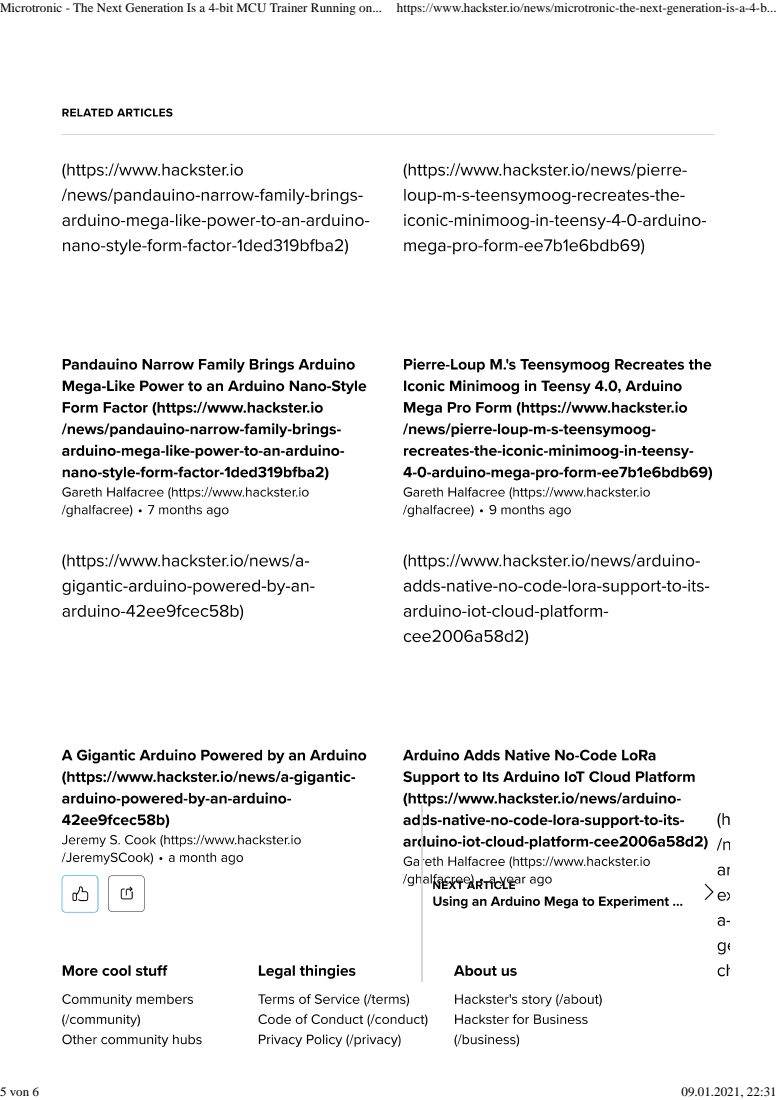
[picture p135: page 5]

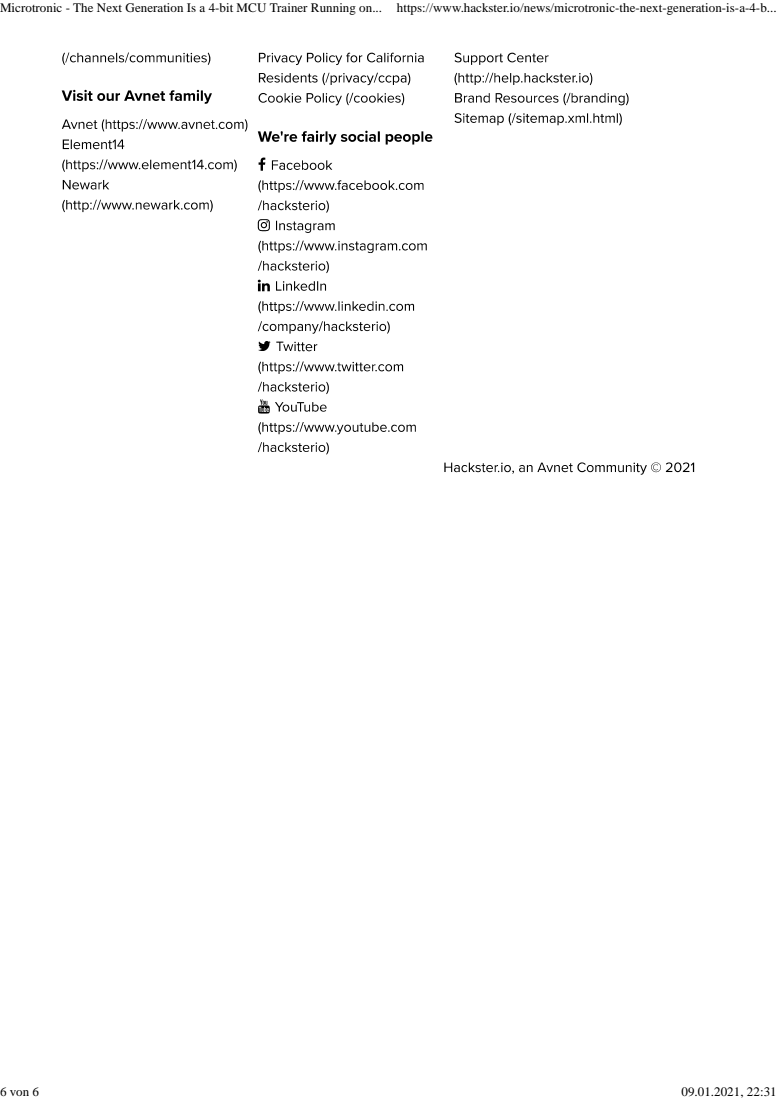
[picture p136: page 6]
