lambdamikel/Busch-2090/microtronic-speech-synthesizer-for-uno/microtronic-speech-synthesizer-for-uno.ino

// this version was used for connecting to a real Microtronic
// the analog THRESHOLDs and timing values are quite sensitive
// and required a lot of hand tweaking and trial and error
// to get the data connection reliably working

#include <SoftwareSerial.h>

#define rxPin 2 // Serial input (connects to Emic 2 SOUT)
#define txPin 3 // Serial output (connects to Emic 2 SIN)

#define IN1 A4  // we are using the analog inputs to connect to the Microtronic outputs
#define IN2 A3  // the digital inputs turned out to be difficult for that purpose 
#define IN3 A1
#define IN4 A0

#define THRESHOLD 1000

byte in = 0 ;
byte in1 = 0 ;
byte lastin = 0 ;
byte last = 255;

SoftwareSerial emicSerial =  SoftwareSerial(rxPin, txPin);

char buffer[100];

byte nibble1 = 0;
byte nibble2 = 0;
long t1 = 0;
byte ar1 = 0;
byte ar2 = 0;
byte ar3 = 0;
byte ar4 = 0;
char ch = 0;

void inline readString() {

  int count = 0;
  char ch = '0';
  long r = 0;

  do {

    nibble1 = 0;
    nibble2 = 0;
    ch = 0;

    while (true) {

      ar1 = analogRead(IN1) > THRESHOLD ? 1 : 0;
      ar2 = analogRead(IN2) > THRESHOLD ? 2 : 0;
      ar3 = analogRead(IN3) > THRESHOLD ? 4 : 0;
      ar4 = analogRead(IN4) > THRESHOLD ? 8 : 0;

      in = ar1 | ar2 | ar3 | ar4;

      t1 = 0;

      while (true) {

        if (in == in1) {

          t1++;

          if (t1 > 1) {
            if (last != in) {
              last = in;
              break;
            }
          }
        } else
          t1 = 0;

        in1 = in;

        delay(2);
        ar1 = analogRead(IN1) > THRESHOLD ? 1 : 0;
        ar2 = analogRead(IN2) > THRESHOLD ? 2 : 0;
        ar3 = analogRead(IN3) > THRESHOLD ? 4 : 0;
        ar4 = analogRead(IN4) > THRESHOLD ? 8 : 0;

        in = ar1 | ar2 | ar3 | ar4;

      }

      if (in != 0) {
        if (nibble1 == 0)
          nibble1 = in - 1;
        else {
          nibble2 = in - 1;
          ch = nibble1 * 10 + nibble2;
          break;
        }
      }
    }

    Serial.print(ch);
    buffer[count++] = ch;

  } while ( ch != 13 ) ;

  buffer[count] = 0;

}

void setup()
{

  Serial.begin(9600);
  Serial.println("Serial connection established!");

  pinMode(rxPin, INPUT);
  pinMode(txPin, OUTPUT);

  emicSerial.begin(9600);


  pinMode(IN1, INPUT);
  pinMode(IN2, INPUT);
  pinMode(IN3, INPUT);
  pinMode(IN4, INPUT);

}

void loop()
{

  while (true) {

    emicSerial.print('\n');
    while (emicSerial.read() != ':');
    delay(10);
    emicSerial.flush();

    while (true) {

      readString();
      Serial.println("String received: ");
      Serial.print(buffer);
      Serial.println();

      emicSerial.print(buffer);
    }
  }

}
