lambdamikel/Busch-2090/(commit log)

2016-01-15 Bugfixes and documentation update. Implemented reset function (D0 to GND), and digital input (D1 - D4 to GND) for DIN op-code.
2016-01-15 Version 0.8. Digital inputs D1-D4 for DIN op-code. Reset button on D0 (connect to GND). More example programs. Bugfixes (PC wasn't incremented).
    [busch2090.ino]
2016-01-15 Bugfix - missing pc++.
    [busch2090.ino]
2016-01-16 Added CPU throttle
2016-01-19 Moved PGM example programs into Arduino EEPROM. Load PGM-EEPROM.ino first before executing busch2090.ino! Thanks to Martin Sauter, PGM7 = Nim Game is in now, and working. Some bug fixes to CMPI op co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
    [PGM-EEPROM.ino, busch2090.ino]
2016-01-21 Adding busch2090-mega for Arduino Mega 2560. This version requires a LCD+Keypad shield, and the Ethernet+SDCard shield in addition to the Arduino Mega 2560.
2016-01-21 Bugfix - LCD display PC counter and instruction was one ahead during program execution. Fixed LCD flickering bug.
    [busch2090-mega.ino]
2016-01-21 Fix type (CMPUI -> CMPI)
    [busch2090-mega.ino]
2016-01-22 Added select button function to toggle LCD between PC + current instruction, register display, extra-register display, and off. Updated doc.
2016-01-23 Adding LUNAR.MIC lunar lander game from Manual Vol. 1. Bugfixes to DISP and some other instructions. Lunar Lander works now. PGM 1 and PGM 2 improvements.
    [busch2090-mega.ino]
2016-01-28 Fixed bugs in MULT opcode: extra-registers are set to zero! This is not documented in the manual, but becomes apparent when testing sinus program from manual vol 2. Also, fixed a bug in DIV opcode: m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
    [busch2090-mega.ino, busch2090.ino]
2016-01-29 Added comment # and origin @ to MIC files. Also, loadProgram() reads from current PC, unless origin is set in file via @. Save saves from current PC, too.
2016-01-29 Bugfixes to Microtronic programs. Some are tested now.
    [busch2090-mega.ino]
2016-01-29 Another bugfix - mult did clear extra register 6, but should only clear extra registers 0 to 5.
    [busch2090-mega.ino, busch2090.ino]
2016-01-30 Fixed PGM 1 / loadProgram bug related to directory browsing / file selection. Had to use rood.unwindDirectory().
    [busch2090-mega.ino]
2016-01-30 Doc update. One critical bugfix to RUN function key - first instruction was skipped!
    [busch2090-mega.ino, busch2090.ino]
2016-01-30 Adding Busch keypad overlays for CALC.MIC, MORSE.MIC, and RESIST.MIC. Thanks to Martin Sauter for scanning these!
2016-02-28 Version 2 of mega emulator. Uses different hardware, designed to be put in a cabinet. Adafruit LED 7Segment Backpacks, 4x20 Hitachi Display, discrete LEDs and Push Buttons.
2016-03-01 Cosmetic bugfix. Show logo screen after reset, show PGM + 7 loaded in PGM (correct PGM number).
    [busch2090-mega-v2.ino]
2016-03-03 Added clock 1 Hz output as digital output PIN. Changed DIN inputs to INPUT mode, and added pulldown resistors to the hardware. Note that keypad DIN is still INPUT_PULLUP, but digital DIN pins are INP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
    [busch2090-mega-v2.ino]
2016-03-04 Changed DOT1 output from 1 to 18. 1 Didn't work for hardware experiments for some reason.
    [busch2090-mega-v2.ino]
2016-03-20 Adding Microtronic speech synthesizer. Requires an Emic-2 and another Arduino Uno for hosting the Emic-2. The Uno also acts as a buffer and serial converter for the Microtronic emulator.
2016-03-20 Adding a version of the Microtronic speech synthesizer that works with the real Microtronic. Analog values, timings and thresholds for inputs are quite sensitive and requires a lot of tweaking and tr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
    [microtronic-speech-synthesizer-for-uno-v2.ino]
2016-03-29 Speaks status descriptions, current display contents and further infos triggered by cursor keys.
2016-05-15 Adding schematics.
2017-08-11 Scanned another older flyer. Shows an early prototype version of the 2090.
2020-05-21 Adding original Microtronic schematics.
2020-06-23 Update. First version running with Nokia display. "Push Button Functions" still missing, and display / screen layout needs improvement.
    [microtronic-nextgen.ino]
2020-06-27 Bugfix Mnemonics display update.
    [microtronic-nextgen.ino]
2020-06-27 RESET, PGM 3, PGM 4, PGM 5, PGM 6 working. PGM "ROM" contents added. PGM 7 doesn't work yet (probably KIN not working for new display yet). However, PGM 8 etc. works. See "PGMROM" strings. Last time 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
    [microtronic-nextgen.ino]
2020-06-27 Massive bugfix - switch / case broken in current Arduino, replaced by if-then-else! KIN works. PGM7 works (NIM Game).
    [microtronic-nextgen.ino]
2020-06-29 SDCard integrated. Select Pin = 53. Use ICSP / SPI header for SDCard module. MOSI / MISO / SCK / GND / 5V. Moved 1 HZ Led, Carry, and Zero to PINS 34, 36, 38. First "SD Load" (PGM 2) from SDCard work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
2020-06-29 Keyboard scanning bugfix and File Selector Display.
    [microtronic-nextgen.ino]
2020-06-30 Breakpoint and SingleStep updates. Display refresh bugfixes.
    [microtronic-nextgen.ino]
2020-06-30 KIN display refresh bugfix.
    [microtronic-nextgen.ino]
2020-06-30 Keypad layout changed for Frank's PCB. LIGHT button implemented (Pin 35).
2020-07-27 1Hz LED / output frequency bug fix. Display refresh bug fix (510-C00 works now).
    [microtronic-nextgen.ino]
2020-07-27 Zero LED patch.
2020-09-26 Update - enable input pullups for DIN, invert logic level for DOT. Tested, works!
    [microtronic-nextgen.ino]
2020-09-26 Bugfix: LOADING went into an endless loop... fixed.
    [microtronic-nextgen.ino]
2020-09-26 Loading bugfix - again. Finally works ;-)
    [microtronic-nextgen.ino]
2020-10-06 Display refresh bugfix / speedup.
    [microtronic-nextgen.ino]
2020-10-08 Update - CPU throttle and display refresh bugfixes. Use RUN+<HEXKEY> to set CPU speed!
    [microtronic-nextgen.ino]
2020-10-31 Adding Arduino libraries.zip
2020-11-06 More fine grained control over CPU throttle - use UP / DOWN in RUNNING mode. Also, display mode forward / backward toggling on RIGHT / LEFT key added, in addition to ENTER.
2020-11-14 Update: autosave, autorun, autostart address in INI file. Load last saved program upon startup. Logo splash screen. Overwrite file protection. Force start with RUN button help down during boot (even 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
2020-11-14 Update: autosave, autorun, autostart address in INI file. Load last saved program upon startup. Logo splash screen. Overwrite file protection. Force start with RUN button help down during boot (even 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
    [microtronic-nextgen.ino]
2020-11-14 Adding inverted DOT outputs for Microtronic 2nd Generation Board.
    [microtronic-nextgen.ino]
2020-11-15 Bugfix inverted outputs for 2095 emulation Microtronic 2nd Generation board.
    [hardware.h, microtronic-nextgen.ino]
2020-11-15 Bugfix PGM1 -> Microtronic double-inverted clockWrite for Microtronic 2nd Generation board.
    [hardware.h, microtronic-nextgen.ino]
2020-11-23 Version 17. Adding new flag: INVERTED_OUTPUTS_FOR_2095_EMU. Allows to easily chose on more set of non-inverted outputs for 2095 emulation with 2nd generation board.
    [hardware.h, microtronic-nextgen.ino]
2020-12-02 Version 20 - adding keybeep to INI file. Keyboard problems fixed. Debouncing and repeat for function keys. Usability enhancements - filename creator, page / up down for program entry, etc.
    [microtronic-nextgen.ino]
2020-12-02 Version 21. Bugfix CPU throttle / keyboard display. Follow-up bug from keyboard scanning refactoring.
    [microtronic-nextgen.ino]
2020-12-02 Using C/CE to jump to OP code entry if in entering address mode. Allows to bypass having to enter the address and use UP / DOWN buttons interactively.
2020-12-05 Changed 1Hz clock to ISR routine; also based PGM 3 / 4 on ISR TIMER4 now.
2020-12-11 Identified the fasted OLED display - SH1106 1.3" SPI
2020-12-21 Bugfix date initialization and keyboard matrix rows reversed to accomodate PCB.
    [hardware.h, microtronic-nextgen-nokia.ino]
2020-12-21 Bugfix RTC date initialization.
    [microtronic-nextgen-sh1106-i2c.ino, microtronic-nextgen-sh1106-spi.ino]
2020-12-21 Microtronic Next Generation PCB images.
2020-12-29 SPI Version hardware setup change. PCB.
2020-12-29 SPI OLED PCB Version.
2021-01-03 INPUT pin mode for DINs, for compatibility with electronics experiments. However, INPUT_PULLUP for Busch 2095 emulation!
2021-01-04 Bugfix - for Next Generation Board, don't invert outputs! Irrelevant for 2nd Generation board.
    [microtronic-nextgen-sh1106-spi.ino]
2021-01-12 Uno R3 PGM EEPROM bugfix!
    [PGM-EEPROM.ino]
2021-01-12 README.md 2016 R3 / Mega versions documentation bugfix - explain proper CPU throttle potentiometer connections.
2021-01-12 README.md documentation bugfix - proper CPU throttle potentiometer connection requires VCC, GND, and A5 for R3 2090 emulator.
2021-01-13 New Busch 2090 R3 version: PGM 1 & PGM 2 EEPROM "CORE LOAD & DUMP", more PGM programs (Blackjack, Primes, Lunar Lander, ...), PGM programs in PGMSPACE now (not EEPROM PGM), real ISR-based 1 Hz clock.
2021-01-13 README.md 2021 Arduino Uno R3 emulator version.
2021-01-13 Blackjack 17+4 game bugfix
    [busch2090.ino]
2021-01-13 17+4 Blackjack Program bugfix (PGM F).
    [busch2090.ino, microtronic-2nd-generation.ino, microtronic-nextgen-sh1106-i2c.ino, microtronic-nextgen-sh1106-spi.ino]
2021-01-13 Redundant images were erased due to case insensitive file system (JPG)
2021-01-14 Blackjack 17+4 PGM F bugfix.
    [microtronic-nextgen-nokia.ino]
2021-01-15 Bugfixes - 2095 emulation for new boards.
    [hardware.h, microtronic-nextgen-nokia.ino, microtronic-nextgen-sh1106-spi.ino]
2021-01-15 Bugfix - 2095 Emulation. Not tested yet.
    [hardware.h, microtronic-2nd-generation.ino]
2021-01-16 Lilly's bugfix for STP + HALT (with minor modifications). Thanks!
    [busch2090.ino]
2021-01-16 Follow-up bugfix: pc++ causes instrictions to skip, so we need to achieve the display stepping over to next instruction differently. lastWasDISP variable is back ;-)
    [busch2090.ino]
2021-01-17 Alternative SOFT_RESET method: HALT + CCE. Not as nice as the physical button, but this can free up the RESET pin 0 so it becomes available as the 4th DOT output.
2021-01-17 Let use choose between PIN0 = RESET or PIN0 = DOT4 output. See #define RESET_BUTTON_AT_PIN_0. Reset button is obsolete, we can use HALT + CCE for reset.
    [busch2090.ino]
2021-01-17 Don't use reset button by default.
2021-01-17 README.md reset button update.
2021-01-17 README.md input pin discussion.
2021-01-20 Update - make CPU Throttle Potentiometer optional. See USE_CPU_THROTTLE_POT_AT_PIN_A5. If not defined, use A5 for Clock 1 HZ output (thanks, Lilly!). In any case, CPU speed can now be selected via RU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
2021-01-20 README.md update. CPU Throttle optional, and RUN + <HEXKEY> key combo CPU speed explained.
2021-01-21 Switch for non-inverted inputs (external pulldowns).
    [busch2090.ino]
2021-01-21 README.md update: NextGen SPI SH1106 Version 2.
2021-01-22 Update - v1.5. Make inputs non-inverted by default, update README.me.
    [busch2090.ino]
2021-01-23 Adding KiCad files and Gerbers for SPI Version.
2021-01-26 New image - Lilly's pulldown resistors.
2021-01-28 Update - step / reg / halt bugfix.
    [busch2090.ino]
2021-01-30 2090 Emulator ATmega 328p PCB Version.
2021-02-02 SHR op-code carray flag bug fix - thanks Lilly!
    [busch2090-pcb.ino, busch2090.ino, microtronic-2nd-generation.ino, microtronic-nextgen-nokia.ino, microtronic-nextgen-sh1106-spi.ino]
2021-02-02 Bugfix SHR instruction, thanks Lilly!
    [microtronic-2nd-generation.ino, microtronic-nextgen-nokia.ino, microtronic-nextgen-sh1106-spi.ino]
2021-02-02 README.md update - 2090 prototype breadboard.
2021-02-10 LED Bubble Display
2021-05-07 Adding Gerbers for SPI OLED display version (V2, with pulldown resistors for DIN inputs).
2021-06-08 LED Retro Bubble Display PCB SMD Version.
2021-06-10 Retro bubble display microtronic SMD PCB version & Gerbers.
2021-06-10 README.md update, schematics.
2021-06-15 Gerbers update - Bubble LED Display Microtronic.
2021-06-15 Schematics / Pictures update Retro Bubble LED Display Version.
2021-07-20 Adding BOM.
2021-08-02 README.md update - Seeed PCBs.
2021-09-08 Power consumption optimization - thanks to Frank!
2021-10-09 Adding blinking input digit (cursor) for DISP and KIN input. Useful for input over multiple registers - you know which register is currently KINed by seeing corresponding digit flash on the display.
2021-10-16 CPU 0 delay bugfix.
    [busch2090-pcb-midi.ino]
2022-01-03 Refactoring and incorporating patches / bugfixes from latest versions into the 2016 ATmega 2560 Mega Emulator version.
    [busch2090-mega-v4.ino]
2022-01-03 Bugfix "loaded @" start address display for PGM load.
    [busch2090-mega-v4.ino]
2022-03-30 Zero Flag LED Bugfix.
    [busch2090-mega-v4.ino]
2023-12-02 Microtronic-Artikel aus der "HC - Mein Homecomputer" vom Juli 1984.
2024-04-06 Update busch2090-pcb-midi.ino
    Undocumented behaviour of the Microtronic 2090:
    Overflow during HXDZ leads to 0 in all registers D, E, and F.
2024-04-06 Update busch2090-pcb.ino
    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
2025-01-13 Adding third column of function keys - RESET, CPU+, CPU-, <ON MORE KEY FOR SOMETHING>. Using PD6 for third column. One more pin left for audio - PD7. Future work.
2025-01-15 Added NewTone sound output to PD7. Removed TIMER1 for the 1 Hz clock because NewTone needs the timer... 1 Hz clock is in software again.
2025-01-16 Quick-and-dirty schematics.
2025-01-20 KiCAD files and Gerber (KiCAD 7).
2025-01-22 Bugfix - thanks to Björn Rathje (stuck digits in case number of displayed registers decreased; "F20 F10 C01" still showed 2 digits on the display).
    [microtronic-nextgen-sh1106-spi.ino]
2025-01-24 Phoenix gerbers v2 - fixed the unconnected "col5" bug in the schematics -> "mosi_col5".
2025-02-15 Firmware for new board revision.
2025-08-26 Adding schematics of Microtronic NextGen V2 with SH1106 display.
2026-09-11 Fix spelling in the documentation
    Micotronic -> Microtronic (2x) keyboad -> keyboard
    Rasperry -> Raspberry orginal -> original (2x)
    Vesion -> Version oscilate -> oscillate
    anylonger -> any longer povides -> provides
    breadboad -> breadboard specically -> specifically
    contributers -> contributors timinig -> timing
    controling -> controlling Progams -> Programs
    digitial -> digital Hackday -> Hackaday
    dissassembler -> disassembler functionaliy -> functionality
    instalation -> installation
    The German passages are quoted correspondence and were left as they are.
    Two manuals/*.txt permission letters were Lat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
2026-10-06 software: verify all manual programs against the printed listings; fix 7 errors
    All 22 programs from the manuals were checked word by word against the
    scanned listings. O/I letter-for-digit slips normalised; genuine errors
    fixed in 17+4 (0B), BLOCKADE (6D), NUMGUESS (00), PRIMES (59),
    RESISTOR (07), SINUS (55) and TITATO (23). OCR disclaimer replaced.
    Claude-Session: https://claude.ai/code/session_01RRZMkeXQShygyYhWuUdVNF
2026-10-07 Built-in Primes program: fix address 59 (D58 -> D5B), as verified against the printed listing
    Source only; firmware binaries built from these sketches are unchanged until rebuilt.
    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
    [busch2090-mega-v4.ino, busch2090-pcb-midi.ino, busch2090-pcb.ino, busch2090.ino, microtronic-2nd-generation.ino, microtronic-nextgen-nokia.ino, microtronic-nextgen-sh1106-i2c.ino, microtronic-nextgen-sh1106-spi.ino]
