lambdamikel/Busch-2090/manuals/spielmittel-article2-page1.jpg

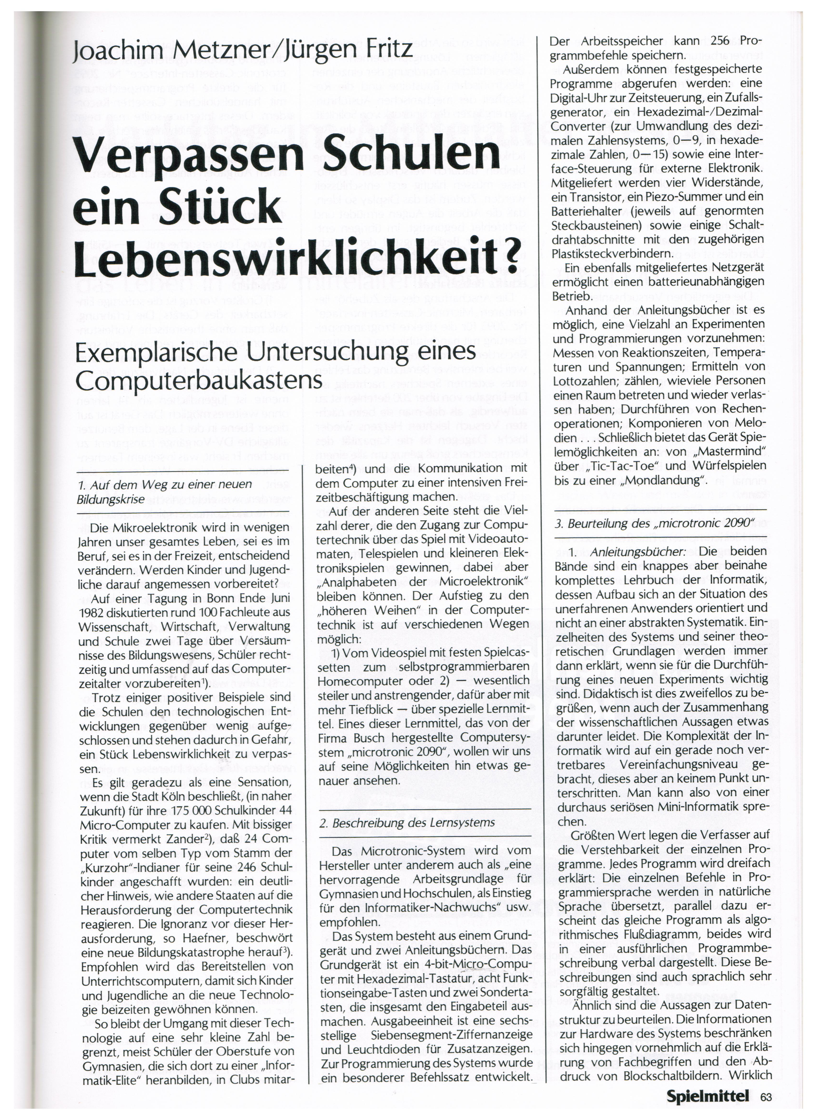
manuals/spielmittel-article2-page1.jpg
